pollen-robotics/grabette/integrations/openarm/openarm_gripette_simu/README.md

# OpenArm Gripette Simulation

MuJoCo simulation of the OpenArm right arm + Gripette gripper with gRPC control interfaces, policy evaluation support, and synthetic data collection in LeRobot format.

## Install

`placo` (used for kinematics) dynamically links the system `urdfdom` libraries,
which are **not** installed by `uv`. On Debian/Ubuntu, install them first:

```bash
sudo apt install -y liburdfdom-sensor4.0 liburdfdom-model4.0 liburdfdom-world4.0
# or the catch-all: sudo apt install -y liburdfdom-dev
```

Without them, `import placo` (and the sim) fails with
`ImportError: liburdfdom_sensor.so.4.0: cannot open shared object file`.

Then sync the Python environment:

> Part of the uv **workspace**: a bare `uv sync` here would build the *entire
> monorepo* environment. Always pass `--package` (root README → Development).
> The base simulator supports Python 3.11; the `dataset` and `eval` extras
> require Python 3.12 because they install LeRobot 0.6.x.

```bash
uv sync --package openarm-gripette-simu                  # base install
uv sync --package openarm-gripette-simu --extra dataset  # + lerobot (dataset collection)
uv sync --package openarm-gripette-simu --extra dev      # + grpcio-tools (proto stubs)
```

The robot model comes from the workspace package
[`openarm_gripette_model`](../openarm_gripette_model), resolved locally from the
monorepo via `[tool.uv.sources]` (`openarm-gripette-model = { workspace = true }`)
— no external fetch.

## Run the server

```bash
# With 3D viewer
uv run python -m openarm_gripette_simu --scene scenes/table_red_cube.xml \
    --initial-joints 0.0 0 0 1.57 0 0 0

# Headless
uv run python -m openarm_gripette_simu --scene scenes/table_red_cube.xml --headless
```

Two gRPC services on separate ports:

| Service | Port | Description |
|---|---|---|
| GripperService | 50051 | Camera stream + gripper motor control (same API as real Gripette) |
| ArmService | 50052 | Delta Cartesian arm control, episode reset, success detection |

## gRPC API

### GripperService (port 50051)

Identical to the real [Gripette](../../../packages/gripette) gRPC API.

| RPC | Description |
|-----|---|
| `StreamState` | 30Hz JPEG camera frames + motor positions + load + timestamp |
| `SendMotorCommand(m1, m2[, torque_limit])` | Set gripper joint goals (rad); optional grip force cap (0..1, 0 = unset) |
| `ReadMotors` | Read gripper joint positions (rad) + load |
| `SetTorque(enable)` | No-op in simulation |
| `Ping` | Health check |

### ArmService (port 50052)

| RPC | Description |
|-----|---|
| `SendCartesianDelta(dx, dy, dz, dr6d[6])` | Apply delta to end-effector pose (meters + 6D rotation). **Deltas are camera-LOCAL — see below.** |
| `GetArmState` | Current camera-frame pose (xyz + r6d) and joint positions |
| `Reset(joint_positions=[])` | Reset episode: randomize cube + arm (empty joints = random start) |
| `GetSuccessStatus` | Returns `goal_reached` (cube touched) + displacement |
| `Ping` | Health check |

The 6D rotation representation (Zhou et al., CVPR 2019) matches the action space used by diffusion policies trained with LeRobot.

#### `SendCartesianDelta` is camera-local (integrator semantics)

`(dx, dy, dz)` and `dr6d` are interpreted in the **integrator's current
camera-frame target**, not in the world frame. The server maintains an
internal `(_target_pos, _target_r6d)` initialized from FK on startup (and
re-synced after `Reset`), and each call updates it as:

```python
R_target = rotation_6d_to_matrix(self._target_r6d)
self._target_pos = self._target_pos + R_target @ (dx, dy, dz)   # local → world
self._target_r6d = rotation_matrix_to_6d(R_target @ rotation_6d_to_matrix(dr6d))
# IK solves to the new (target_pos, target_r6d) and commands the arm joints.
```

This matches `convert_dataset.py` in the [DiffusionPolicy](../../DiffusionPolicy)
integration, which builds the per-frame action as `R[t].T @ Δpos_world` and
`R[t].T @ R[t+1]` (the integrator-semantics box above has the full frame
rationale). To verify the integrator end-to-end against a running server, use
the gRPC-client `cartesian_square.py` in the
[`openarm_gripette`](../openarm_gripette) package — not the standalone one in
this repo's `examples/` (see "Examples" below).

### Evaluation loop pattern

```python
import grpc
from openarm_gripette_simu.proto import arm_pb2, arm_pb2_grpc

stub = arm_pb2_grpc.ArmServiceStub(grpc.insecure_channel("localhost:50052"))

for episode in range(n_episodes):
    stub.Reset(arm_pb2.ResetRequest())  # randomized start + cube
    for step in range(max_steps):
        state = stub.GetArmState(arm_pb2.GetArmStateRequest())
        # ... policy inference ...
        stub.SendCartesianDelta(arm_pb2.CartesianDelta(...))
        status = stub.GetSuccessStatus(arm_pb2.SuccessStatusRequest())
        if status.goal_reached:
            break
```

### Action representation at eval (`--chunk_relative`)

`evaluate.py` speaks two action representations. **Per-step deltas are the
default** and need no flag. A checkpoint trained with chunk-relative actions
(`GRABETTE_CHUNK_RELATIVE=1` in `integrations/Pi05/train.py`) emits 8-D
chunk offsets that must be differenced back into per-step deltas before the
arm server sees them:

```
--chunk_relative auto   # default: read the checkpoint's policy_preprocessor.json
                        # and enable iff a chunk-relative step is registered
--chunk_relative on     # force on (remote --policy_addr: the checkpoint is not
                        # local, so say it explicitly or auto refuses to guess)
--chunk_relative off    # force off
```

Chunk-relative needs `--n_action_steps 40` or more; the reference (the
chunk's first action) cancels in the differencing, so short horizons replay
the model's per-step noise as jitter (15 is visibly jerky). The width of the
action vector is cross-checked against the mode (8-D chunk-relative, 11-D
delta) and a mismatch aborts with a hint instead of silently misinterpreting.
Install with the `eval` extra (`grabette-chunkrel` is a workspace dependency)
— see `docs/relative_actions_lerobot_native.md` for the design and results.

Note: `--skip_stale` used to read a dead action queue on pi05 and dropped the
chunk head on every tick; it now drops exactly once per replan.

### View the camera stream

```bash
uv run python -c "
import cv2, grpc, numpy as np
from openarm_gripette_simu.proto import gripper_pb2, gripper_pb2_grpc
stub = gripper_pb2_grpc.GripperServiceStub(grpc.insecure_channel('localhost:50051'))
for frame in stub.StreamState(gripper_pb2.StreamRequest()):
    img = cv2.imdecode(np.frombuffer(frame.jpeg_data, np.uint8), cv2.IMREAD_COLOR)
    cv2.imshow('Gripette', img)
    if cv2.waitKey(1) & 0xFF == ord('q'): break
"
```

## Synthetic data collection

Generates diverse reach-and-touch episodes in LeRobot v3 format or as raw numpy arrays.

Trajectory types (mixed randomly per episode):
- **Direct reach** (40%): cube visible at start, go straight to it
- **Scan then reach** (35%): camera looking away, sweep to find cube, then reach
- **Offset reach** (25%): start displaced sideways, re-center then reach

Each episode randomizes:
- Cube XY position (±6cm in X, ±20cm in Y) and yaw (full rotation)
- Arm start joints (±0.08 rad per joint)
- Cube placement uses MuJoCo collision detection to guarantee no contact with the arm at spawn

```bash
# LeRobot format (requires: uv sync --extra dataset)
uv run python examples/collect_reach_dataset.py \
    --repo-id user/simu_reach --episodes 500

# Raw npy/jpg format (no lerobot dependency)
uv run python examples/collect_reach_dataset.py \
    --raw --root data/raw_reach --episodes 500

# Push to HuggingFace Hub
uv run python examples/collect_reach_dataset.py \
    --repo-id user/simu_reach --episodes 500 --push

# Visual debug
uv run python examples/collect_reach_dataset.py \
    --repo-id local/test --episodes 5 --viewer
```

Dataset features match the Grabette training pipeline:
- `observation.state`: `[11]` float32 — `[x, y, z, r6d_0..5, proximal_deg, distal_deg]`
- `observation.images.cam0`: video, 972×1296 fisheye
- `action`: `[11]` float32 — same 11D (absolute, next-step target)

Reach episodes record at **50fps** (20ms per frame), 972×1296 — the sim's native rate. (The real rig and the **grasp** dataset below use 30fps / 960×720 to match it; the reach set is a separate, older synthetic task.)

## Grasp data collection

`examples/collect_grasp_dataset.py` generates scripted grasp-and-lift demos of the
arm picking a cylinder ("can") off the table, in LeRobot format, for training a
visuomotor grasp policy. The gripper is driven free-floating (welded mocap) along
an approach → descend → close → hold → lift trajectory; only successful episodes
(cube lifted ≥ 5 cm) are saved.

```bash
uv run python examples/collect_grasp_dataset.py \
    --episodes 200 --repo_id user/sim_grabette_grasp --push_to_hub --private
```

Dataset format (matches the real Grabette recordings):
- `observation.images.cam0`: **h264** video, **960×720** fisheye (distorted at the
  calibration resolution then downscaled), **30 fps**.
- `action`: `[8]` float32 — `[x, y, z, ax, ay, az, proximal, distal]`: the absolute
  `oak_l` (SLAM/control) pose + gripper joint **position** at the next step.
  `DiffusionPolicy/convert_dataset.py` turns these into the camera-local deltas the
  policy trains on.

Grasp-pose sampling (tunables in `examples/grabette_trajectory.py`):
- `GRASP_TILT_RANGE_DEG = (65, 75)` — tilt off vertical (0 = top-down). Diagonal
  grasps; top-down is both hardest to reach and near the wrist-roll singularity.
- `GRASP_AZIMUTH_RANGE_DEG = (10, 30)` — grasp yaw. Positive is the right arm's
  natural side; negative wraps the elbow into the pedestal.
- `GRASP_OFFSET_BODY` z (0.090) — how deep the can sits in the V (smaller = deeper).

Episode-type mix (CLI fractions): `--release_fraction` (start closed→open),
`--recover_fraction` (deliberate near-miss → reposition → re-grasp); the remainder
are normal grasps.

Two prefilters keep only **arm-executable** demos (data-gen is free-floating, so it
must check the arm explicitly):
- `--ik_filter` (default on) — rejects per-frame poses the OpenArm can't reach.
- `--pedestal_filter` (default on) — rejects configs that collide with the mounting
  column (shared `pedestal.py` clearance query — the same one the eval gate uses).

`scenes/grabette_grasp.xml` (the free-floating grasp scene) is regenerated from the
model by `scenes/gen_grabette_grasp.py` after a model re-export.

**Verify a collected dataset** with `examples/replay_dataset.py` (needs a display):

```bash
# Free-floating gripper + the recorded cam0 frames (check the data itself)
uv run python examples/replay_dataset.py --repo_id user/sim_grabette_grasp

# Replay the recorded oak_l poses on the FULL ARM (IK + physics) and report grasp
# success — confirms the saved episodes are arm-executable
uv run python examples/replay_dataset.py --repo_id user/sim_grabette_grasp --arm
```

## Evaluate a trained policy

`examples/evaluate.py` loads a trained policy (Diffusion / ACT / Pi0…, the type
is auto-detected from its `config.json`) and drives the arm over gRPC for N
episodes, reporting grasp success. The policy must have been trained on the
camera-local delta format produced by the `DiffusionPolicy` integration's
`convert_dataset.py` (2D gripper state, 11D delta action).

```bash
uv sync --package openarm-gripette-simu --extra eval   # adds LeRobot Diffusion/Pi policy deps + scipy

# Terminal 1 — arm grasp scene, headless
uv run python -m openarm_gripette_simu --scene scenes/table_grasp.xml --headless

# Terminal 2 — run the policy
uv run python examples/evaluate.py \
    --checkpoint <user>/<model>-best \
    --num_episodes 30 --n_action_steps 8
```

- `--checkpoint` — local path or HF repo id.
- **`--grip_assist`** — the fix to reach for when the policy approaches well but
  the gripper "closes without really gripping": see
  [When the gripper closes but barely touches the object](#when-the-gripper-closes-but-barely-touches-the-object).
  Supersedes `--latch_close` / `--commit_close` / `--grip_gain`.
- `--n_action_steps 8` — committed grasp (lower = more reactive approach, but can hesitate on the trigger).
- `--debug` — preview the camera feed; `--log_gripper` — print the gripper command vs observed state (and `present_load`) each step.
- `--clamp_pos_mm` / `--clamp_rot_deg` — cap per-step Cartesian deltas (stability test).
- `--grip_torque_limit` — **grip force cap** as a fraction `0..1` of the servo's max torque, applied to both gripper DOFs. `0` (default) = full torque = the pre-existing behavior, so **existing policies are unaffected unless you opt in**. With a cap set, the DOF driven into the object stalls at the cap → a consistent, object-size-independent grip force, while the policy's position targets (grasp *shape*) are untouched — no shape classifier needed. Force is then the cap rather than position overshoot, which is what makes `--grip_assist` safe to let close until it feels the object. Real hardware only (no-op in sim, which has no torque cap). **Pair it with `--grip_assist`** (see below); the older `--grip_gain` route needed the cap for the same reason. Start around `0.25` (field-validated: "medium" grip, ample for grasping, and thermally safe to hold indefinitely — no overload-protection fade); watch the `motor{1,2}_load` telemetry via `--log_gripper`. Load clamps at `cap×1000`; `present_current` keeps rising past the cap if you need to sense firmer grasps.

**OpenCV: headless by default, GUI window opt-in.** The workspace installs **`opencv-python-headless`** — lerobot depends on it and the on-device services (grabette on the Pi) need it, and a single venv can hold only one `cv2`. In this default, `--debug` **saves annotated frames to `eval_debug_frames/`** (and warns once) instead of opening a window. To get a **live preview window** on a GUI workstation, install the full build over the headless one:

```bash
uv pip install --force-reinstall opencv-python
```

Workstation-only (don't do this for a Pi deployment), and re-run it after any `uv sync` — sync restores the headless build.

### When the gripper closes but barely touches the object

**Try this first when a policy approaches correctly but fails to actually grip.**
It is the primary remedy for the most common grasp failure on this hardware, and
it **supersedes `--latch_close` / `--commit_close` / `--grip_gain`** — set it
instead of those, not alongside them.

**The failure.** The policy replays the closing *angle* it was shown, which is
where the human demonstrator's fingers sat **while pressing the object**. Replayed
on a force-blind position servo, that angle can leave the fingers stopped just
short, touching nothing: "parked at angle θ in air" and "pressing the object at
angle θ" are indistinguishable to the policy, and the dataset gave it no force
channel to tell them apart. Measured on the real arm: the policy commanded
proximal `0.865` while the object blocks the fingers at `0.871` — short by
~0.006 rad, i.e. it would just touch the mustard with essentially zero force.

**What the assist does.** It leaves the policy in charge of *when* to close and
*which posture* to use, and intervenes only in the one state where the policy
demonstrably fails — it has **settled** into a closed pose that is **not
gripping**. Then it extends the closure **along the policy's own prox/distal
direction** until the fingers stall on the object, presses a little further to
develop grip force, and latches. Everywhere else the gripper command passes
through untouched, so neither the approach nor an already-good grasp is
perturbed.

Preserving the posture matters here: with a 2-DoF index finger against a fixed
thumb, the prox/distal *ratio* **is** the grasp type (fingertip pinch ↔ power
wrap). A fixed "closed" target would override the policy's choice and could
drive the index into the thumb; extending along its direction cannot.

```bash
uv run python examples/evaluate.py \
    --checkpoint <user>/<model> \
    --grip_assist 50 --assist_lag 0.010 --assist_step 0.02 --assist_squeeze 0.05 \
    --grip_torque_limit 0.25 \
    --start_gripper 0.40 0.30 --log_gripper --assist_log /tmp/assist.jsonl
```

**Contact is detected as a stall** — all three terms are required, and each one
is there because omitting it failed on the robot:

| term | flag | why it is needed |
|---|---|---|
| the fingers have stopped advancing | `--assist_settle_eps` (0.004) | fingers still *travelling* to a fresh command lag ~0.09 rad and draw cap current; without this the assist latched 3 ticks in having added nothing |
| settled **short** of the commanded pose | `--assist_lag` (0.010 rad) | a finger that simply arrived has ~no lag; a blocked one keeps a growing one |
| while drawing load | `--grip_assist LOAD_THRESH` | a limp/disabled servo is also "not moving", but pushes nothing, and must not read as a grasp |

Readings are debounced (`--assist_confirm_ticks`, default 2) because the load
register is noisy. **Slip is load-only** (load fell): a gripped finger keeps
creeping while the policy raises its own command, and treating that motion as
slip ratcheted the extra closure 0.18 → 0.24 → 0.30 on the arm.

**Tuning.** The defaults come from measurements on the real gripper at a 0.25
torque cap: free motion lags 0.002–0.004 rad with load 0–24, while from first
contact lag is 0.014 and growing as load climbs 72 → 250 (the cap). Re-measure
for a different gripper or cap with
[`examples/characterize_grip_load.py`](examples/characterize_grip_load.py),
which sweeps the closure in assist-sized steps and prints the load-vs-closure
curve per object. **Thresholds do not transfer between hardware and sim** (the
sim's load is MuJoCo `actuator_force`, not the servo's 0–1000 PWM proxy). If a
soft object's signal barely clears the noise floor, raise `--assist_step` (a
deeper press gives a stronger signal) rather than lowering the threshold into
the noise.

**Debugging.** Every tick reports *why* the assist acted or didn't — `open`,
`cmd still moving 3/5`, `dwell`, `stepping to 0.040`, `contact confirmed`,
`squeezing to`, `latched at`, `holding`, `slip`, `no contact within max_extra`,
`disarmed` — via `--log_gripper`, and `--assist_log FILE` writes a per-tick
JSONL (model vs sent command, observed position, load, state, offset, lag,
advance, reason) for offline analysis. A silent no-show is therefore always
explainable: if it never engages, the reason field names the gate that blocked
it (usually `cmd still moving`, fixed with `--assist_stable_ticks 3`).

The per-episode summary reports the latched **extra closure**, which is a useful
measurement in its own right: *how much the policy was under-closing by*.

**Field result (mustard, real arm).** Raw grasping (no assist, no latch/gain)
reproduces the failure clearly. `--latch_close 0.50 --grip_gain 1.3`, tuned over
several sessions and specific to that model/object, works. `--grip_assist` with
the bench-measured defaults works at least as well, with nothing to re-tune when
the object or checkpoint changes.

> **Note:** the eval reopens the gripper to `--start_gripper` when it exits
> (including Ctrl-C). A run that ends while gripped would otherwise leave the
> servo squeezing at the torque cap indefinitely — and the *next* episode would
> then start with the policy observing a **closed** gripper, which is out of
> distribution (every demo starts open) and makes it predict lift/hold instead
> of approach/close. After a `kill -9`, reopen the gripper manually.

### Remote inference (big VLA checkpoints)

Models too large for the robot machine (Pi0.5/Pi0Fast, ~10 GB in fp32) can run
on a remote GPU through a [Ficelle](https://github.com/SteveNguyen/Ficelle)
policy server — all pre/post-processing happens server-side through the
checkpoint's own pipeline, this loop only ships raw observations and receives
action chunks. Works for single-frame policies (Pi0/Pi0.5) and the two-frame
Diffusion models (the server's `n_obs_steps` picks the wire format
automatically); sync mode only.

```bash
# On the GPU machine (needs the ficelle repo). --transport iroh works through
# NAT with no VPN/port-forwarding (QUIC hole-punching) and prints a ticket:
uv run python serve.py --checkpoint <user>/<model> --dtype float32 --transport iroh
# (--dtype float32: the lerobot pi05 port has a bf16 dtype clash in its flow path)
#   -> iroh ticket: endpointv1...

# On the robot machine — same eval loop, no local checkpoint; --policy_addr
# takes the ticket (or a 'host:port' if the server is reachable directly):
uv run python examples/evaluate.py \
    --policy_addr endpointv1... --n_action_steps 15 \
    --task "pick up the red can" --num_episodes 10
```

- The ficelle client must be installed in this environment
  (`uv pip install -e '<ficelle>/client[iroh]'` — websockets + msgpack +
  numpy, plus the iroh bindings for the ticket transport).
- `--n_action_steps` matters: Pi0.5's native chunk is 50 actions = 5 s
  open-loop at 10 fps; 10–25 re-plans often enough to stay closed-loop.
- `--jpeg_quality 90` compresses frames for transport (use over WiFi/VPN;
  raw is fine on a LAN).

### Eval safety gates (`arm_servicer`)

`SendCartesianDelta` validates each IK solution before applying it (holding the
last-good command + rolling back the integrator target if it fails):
- **Pedestal gate** — rejects a config that moves a guarded link within 2 cm of the
  mounting column. Moves that *increase* clearance are always allowed, so the arm
  can never deadlock inside the margin.
- **Singularity guard** — rejects an IK solution that jumps more than
  `JOINT_JUMP_LIMIT` (0.5 rad) from the last command — the signature of a
  near-singular "explosion" (it also stops the arm flailing into the column).

Both use the shared `pedestal.py` clearance query against the `pedestal_box` proxy
geom in `scenes/table_grasp.xml` (the same query the data-gen `--pedestal_filter`
uses, so demos and eval enforce the identical constraint). Per-episode the servicer
logs `[grasp-diag]` (commanded-vs-actual grasp gap) and `[grasp-orient]` (grasp
tilt/azimuth) at `GetSuccessStatus`, for diagnosing systematic misses.

## Scenes

Scene XML files live in `scenes/`. They include the robot model and add environment elements.

| Scene | Description |
|---|---|
| `scenes/table_red_cube.xml` | Wooden table with a movable red cube (reach task) |
| `scenes/table_grasp.xml` | Arm + table + grasp cylinder + `pedestal_box` proxy (grasp eval / replay) |
| `scenes/grabette_grasp.xml` | Free-floating gripper + cylinder (grasp data generation); regenerated by `scenes/gen_grabette_grasp.py` |

To create a new scene, copy an existing one as a template. The robot is included via `<include file="...robot.xml"/>`. The `Simulation` class injects the correct `meshdir` so scenes can live anywhere.

## Examples

Standalone demos (no gRPC — each script spawns its own MuJoCo simulation):

```bash
uv run python examples/cartesian_square.py   # Standalone Cartesian square (NOT a gRPC client)
uv run python examples/joint_control.py      # Move joints one by one
uv run python examples/gripper_demo.py       # Gripper open/close cycle
uv run python examples/table_scene.py        # Table scene with red cube
uv run python examples/grpc_client_demo.py   # gRPC client (requires server running)
```

> **Two `cartesian_square.py` files exist.** The one in *this* repo
> (`openarm_gripette_simu/examples/cartesian_square.py`) is **standalone**:
> it imports `Simulation`/`Kinematics` directly and runs its own MuJoCo
> instance with world-frame waypoints. It is **not** a gRPC client — running
> `python -m openarm_gripette_simu --scene ...` in another terminal has no
> effect on it. The canonical end-to-end smoke test of the camera-local
> delta convention is the gRPC-client `cartesian_square.py` in the
> [`openarm_gripette`](../openarm_gripette) package (takes `--arm_addr`) — it
> drives a running server and tests the integrator semantics described above.

## Camera

The simulated Gripette camera matches the real camera calibration:
- Render/calibration resolution: 1296×972 (distorted at this res, then downscaled to the **960×720** streamed to the policy)
- Lens model: KannalaBrandt8 fisheye
- MuJoCo renders a wide-FOV (130°) pinhole image, then remaps with real distortion coefficients

Camera rendering is done in the main thread (alongside physics and viewer) and cached; gRPC streams read the cached frame to avoid GL context conflicts.

## Timing

| Component | Rate |
|---|---|
| Physics | 500Hz (dt=0.002s) default; 1000Hz (dt=0.001s) in the grasp scenes |
| Camera render | 30Hz (matches the real Grabette stream) |
| Gripper gRPC stream | 30Hz |
| Dataset FPS | 30 (grasp, matches real) · 50 (reach) |
| Viewer sync | 60Hz |

## Regenerating proto stubs

```bash
uv sync --package openarm-gripette-simu --extra dev
uv run python -m grpc_tools.protoc -I proto \
    --python_out=openarm_gripette_simu/proto \
    --grpc_python_out=openarm_gripette_simu/proto \
    --pyi_out=openarm_gripette_simu/proto \
    proto/gripper.proto proto/arm.proto
```

Then fix the imports in generated `*_pb2_grpc.py` files: change `import xxx_pb2` to `from . import xxx_pb2`.
