pollen-robotics/grabette/docs/images/turn_on.gif

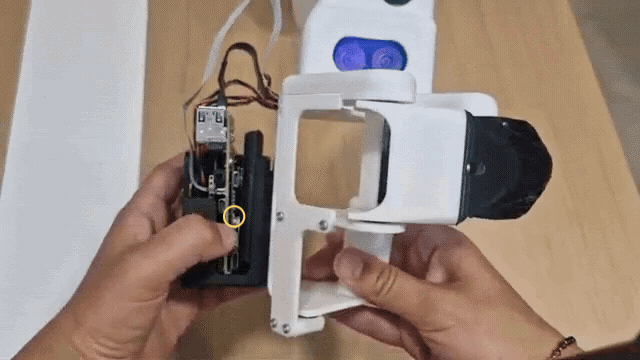
docs/images/turn_on.gif
