pollen-robotics/grabette/packages/grabette/docs/images/grabette_face.jpg

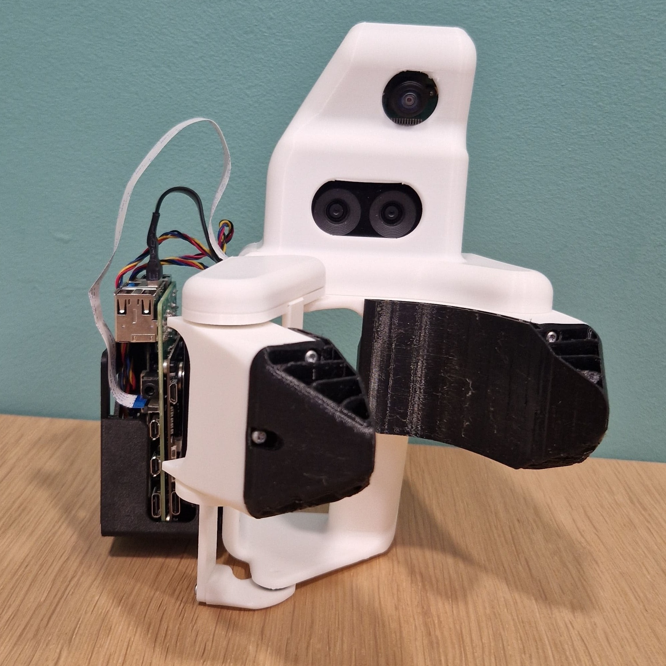
packages/grabette/docs/images/grabette_face.jpg
