pollen-robotics/grabette/packages/grabette/assembly/CAD_files/Left/STEP/Pivot_Bot_L.step

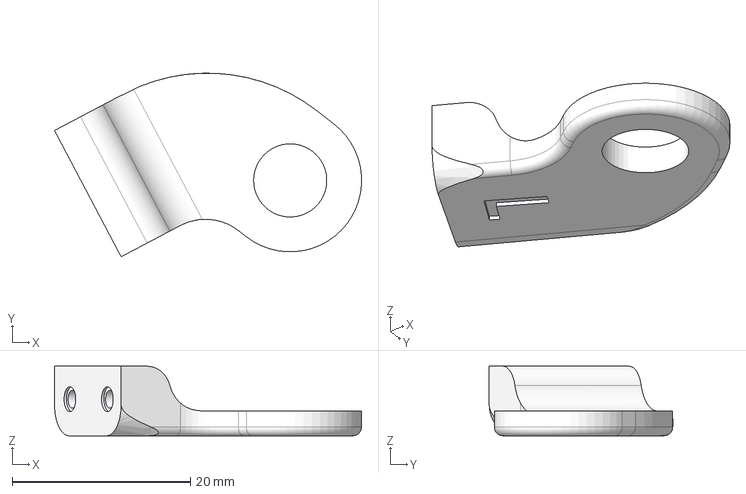
[picture p7: CAD file, 2026-07-06]
packages/grabette/assembly/CAD_files/Left/STEP/Pivot_Bot_L.step
34.4 x 20.6 x 7.80 mm
