pollen-robotics/grabette/packages/grabette/assembly/CAD_files/Right/STEP/Proximal_Shell_R.step

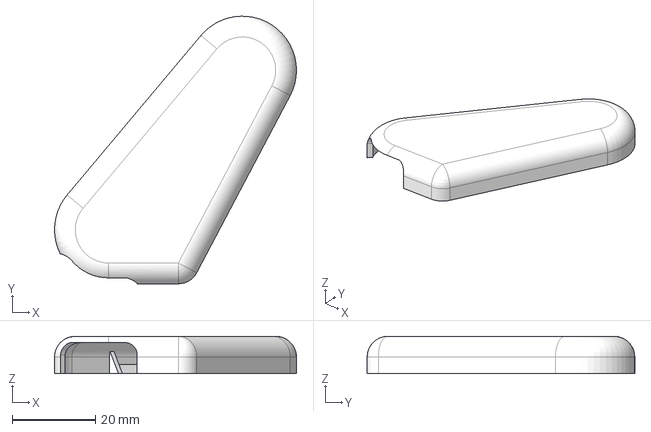
[picture p8: CAD file, 2026-07-06]
packages/grabette/assembly/CAD_files/Right/STEP/Proximal_Shell_R.step
58.1 x 64.3 x 9.00 mm
