pollen-robotics/grabette/packages/gripette/assembly/CAD_files/Left/STEP/Cameras_Holder_L.step

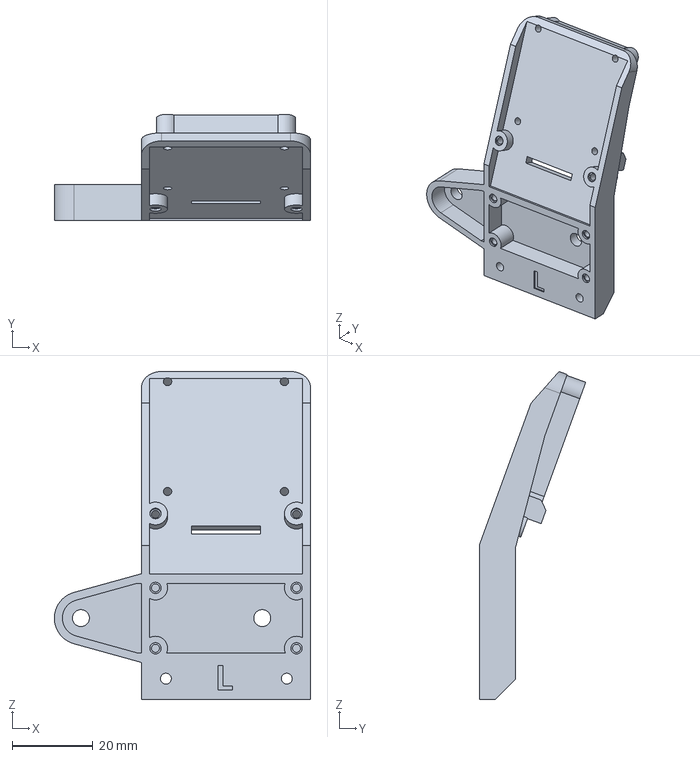
[picture p9: CAD file, 2026-07-06]
packages/gripette/assembly/CAD_files/Left/STEP/Cameras_Holder_L.step
63.6 x 26.4 x 81.4 mm
