pollen-robotics/grabette/packages/gripette/assembly/CAD_files/Right/STEP/Grip_soft_tip_R.step

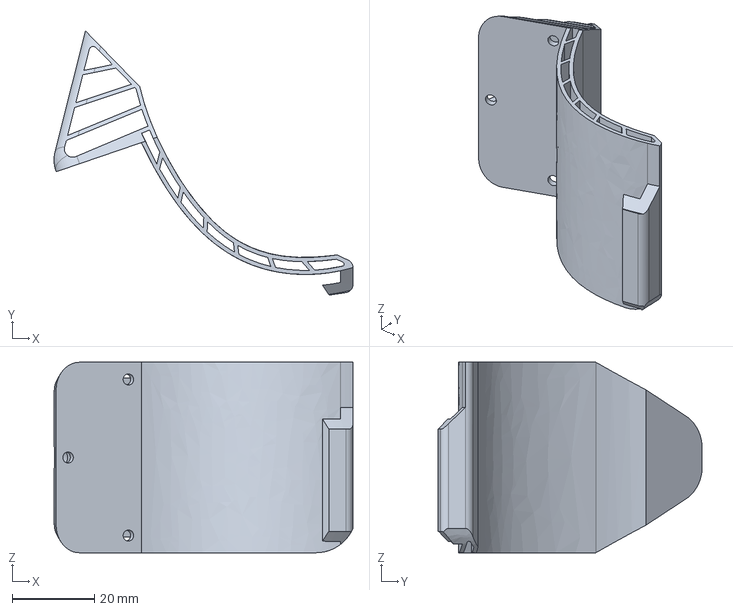
[picture p10: CAD file, 2026-07-06]
packages/gripette/assembly/CAD_files/Right/STEP/Grip_soft_tip_R.step
72.8 x 64.4 x 46.4 mm
