pollen-robotics/grabette/packages/grabette/assembly/CAD_files/Right/STEP/Grip_R.step

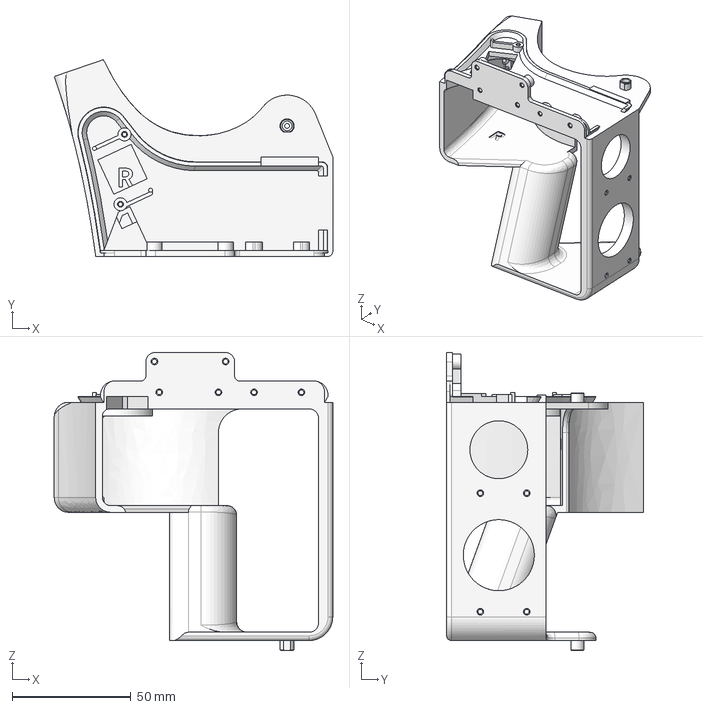
[picture p11: CAD file, 2026-07-06]
packages/grabette/assembly/CAD_files/Right/STEP/Grip_R.step
117.5 x 82.9 x 125.7 mm
