pollen-robotics/grabette/packages/gripette/assembly/CAD_files/Left/STEP/Proximal_Bot_L.step

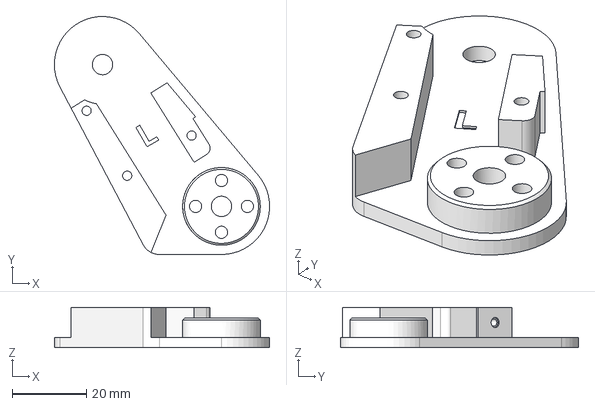
[picture p12: CAD file, 2026-07-06]
packages/gripette/assembly/CAD_files/Left/STEP/Proximal_Bot_L.step
58.1 x 64.3 x 10.9 mm
