pollen-robotics/grabette/packages/gripette/assembly/CAD_files/Right/STEP/Grip_Shell_R.step

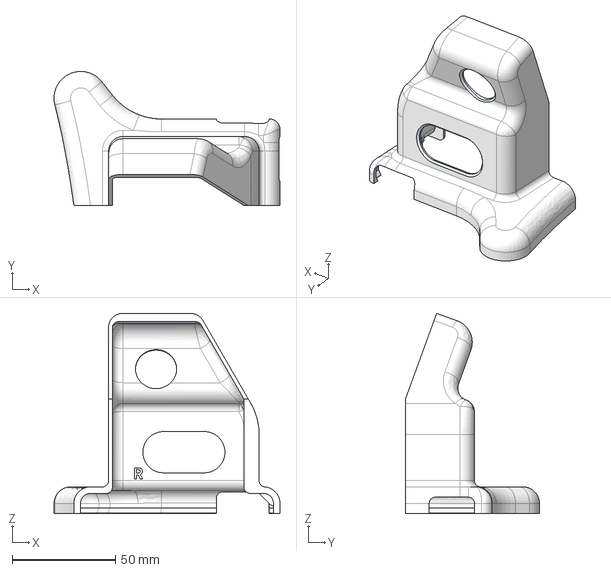
[picture p13: CAD file, 2026-07-06]
packages/gripette/assembly/CAD_files/Right/STEP/Grip_Shell_R.step
109.6 x 65.1 x 97.2 mm
