pollen-robotics/grabette/packages/grabette/assembly/CAD_files/Left/STEP/Button.step

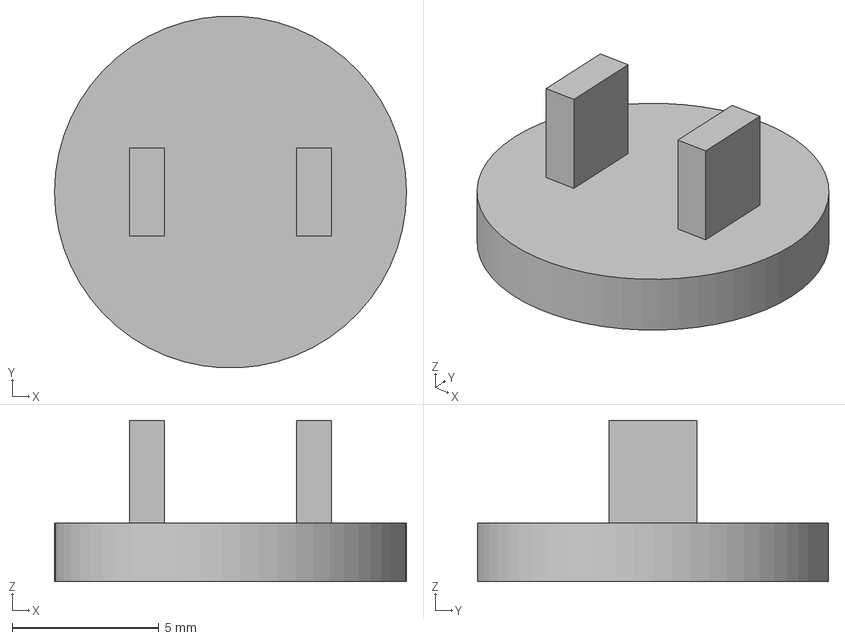
[picture p14: CAD file, 2026-07-06]
packages/grabette/assembly/CAD_files/Left/STEP/Button.step
12.0 x 12.0 x 5.50 mm
