pollen-robotics/grabette/packages/gripette/assembly/CAD_files/Left/STEP/Gripper_Base_L.step

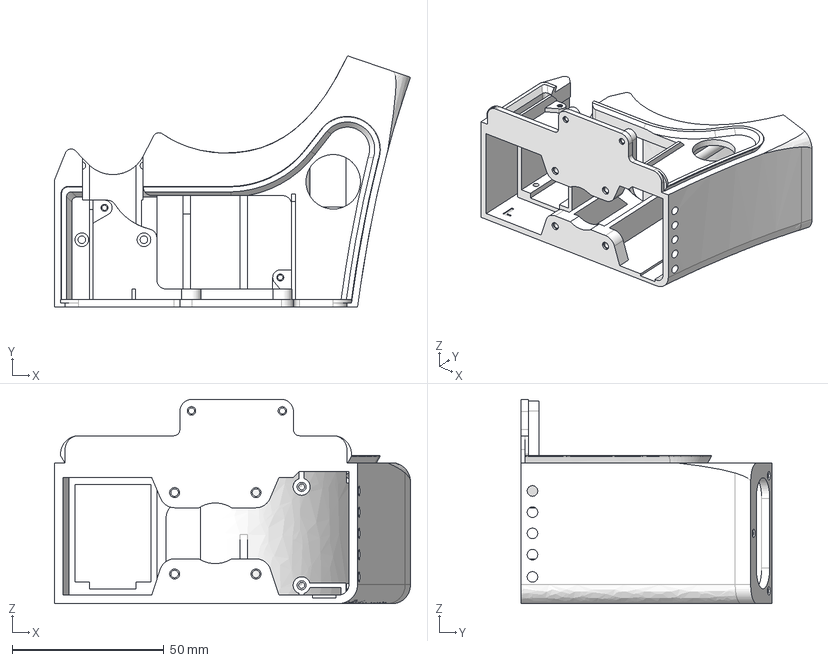
[picture p15: CAD file, 2026-07-06]
packages/gripette/assembly/CAD_files/Left/STEP/Gripper_Base_L.step
117.5 x 82.9 x 67.4 mm
