pollen-robotics/grabette/packages/grabette/assembly/CAD_files/Left/STEP/Raspi_Box_L_Flat.step

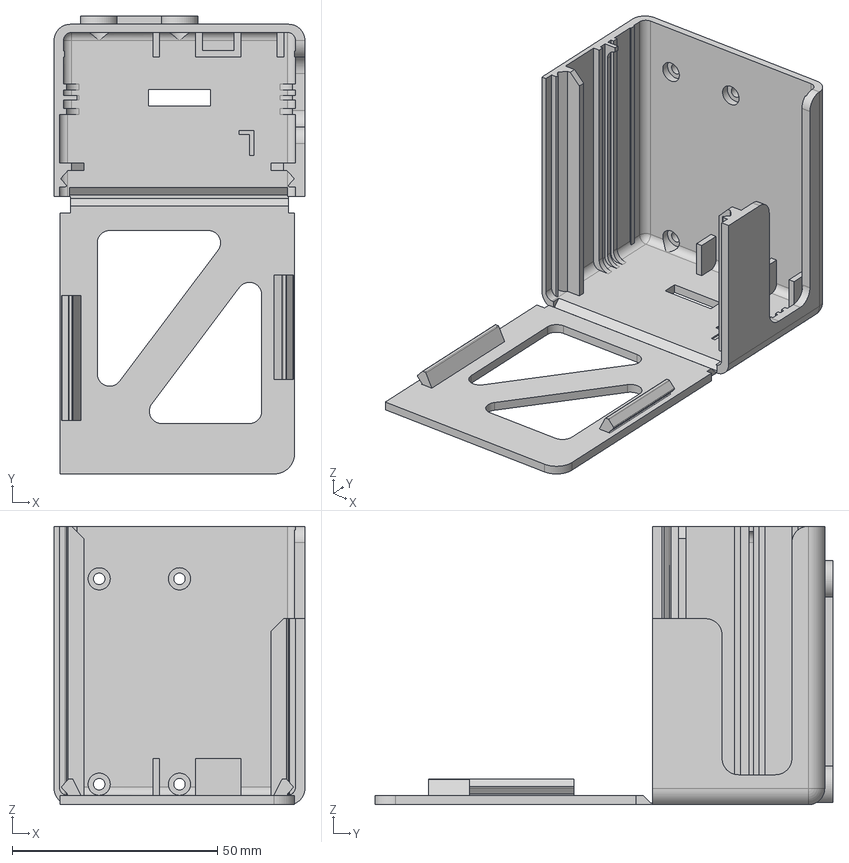
[picture p16: CAD file, 2026-07-06]
packages/grabette/assembly/CAD_files/Left/STEP/Raspi_Box_L_Flat.step
61.1 x 111.5 x 67.8 mm
