pollen-robotics/grabette/packages/grabette/assembly/CAD_files/Right/STEP/Distal_Soft_tip.step

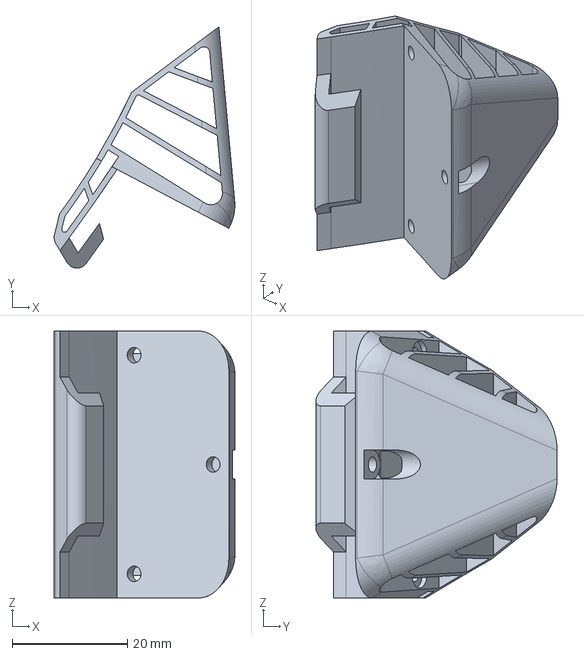
[picture p17: CAD file, 2026-07-06]
packages/grabette/assembly/CAD_files/Right/STEP/Distal_Soft_tip.step
31.4 x 41.9 x 46.4 mm
