pollen-robotics/grabette/packages/grabette/assembly/CAD_files/Left/STEP/Spacer H8.5.step

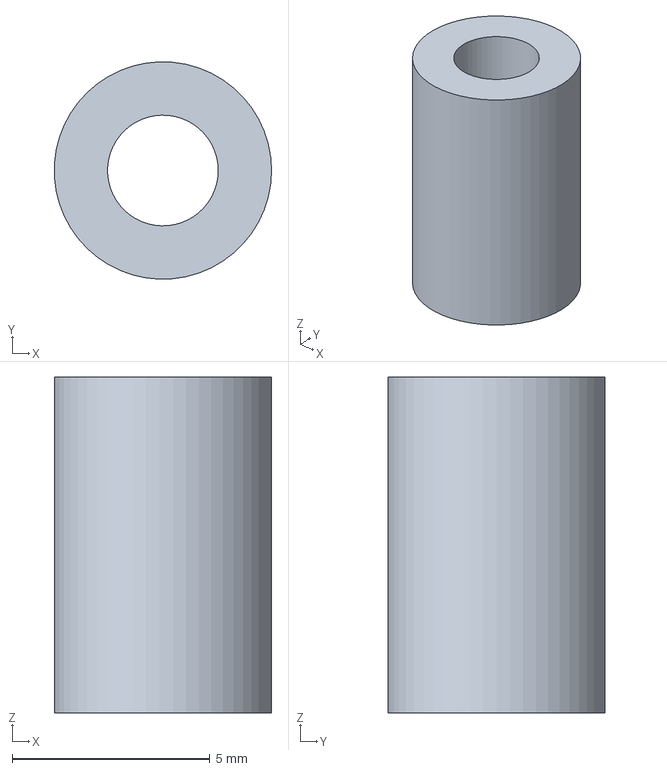
[picture p18: CAD file, 2026-07-06]
packages/grabette/assembly/CAD_files/Left/STEP/Spacer H8.5.step
5.49 x 5.50 x 8.50 mm
