pollen-robotics/grabette/packages/gripette/assembly/CAD_files/Left/STEP/Distal_Part_L.step

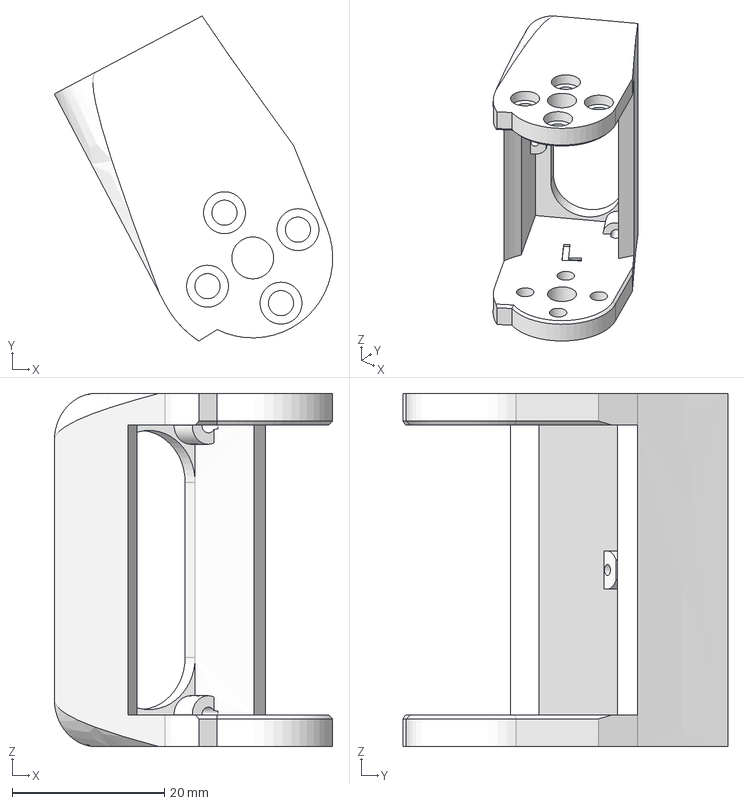
[picture p19: CAD file, 2026-07-06]
packages/gripette/assembly/CAD_files/Left/STEP/Distal_Part_L.step
36.5 x 42.7 x 46.4 mm
