pollen-robotics/grabette/packages/gripette/assembly/CAD_files/Right/STEP/Proximal_Top_R.step

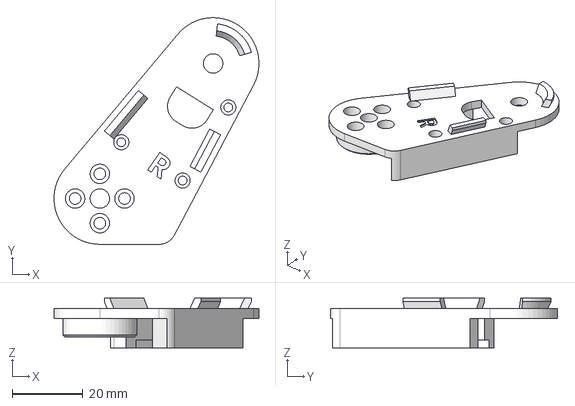
[picture p20: CAD file, 2026-07-06]
packages/gripette/assembly/CAD_files/Right/STEP/Proximal_Top_R.step
58.1 x 64.3 x 14.1 mm
