pollen-robotics/grabette/packages/grabette/assembly/CAD_files/Left/STEP/Grip_L.step

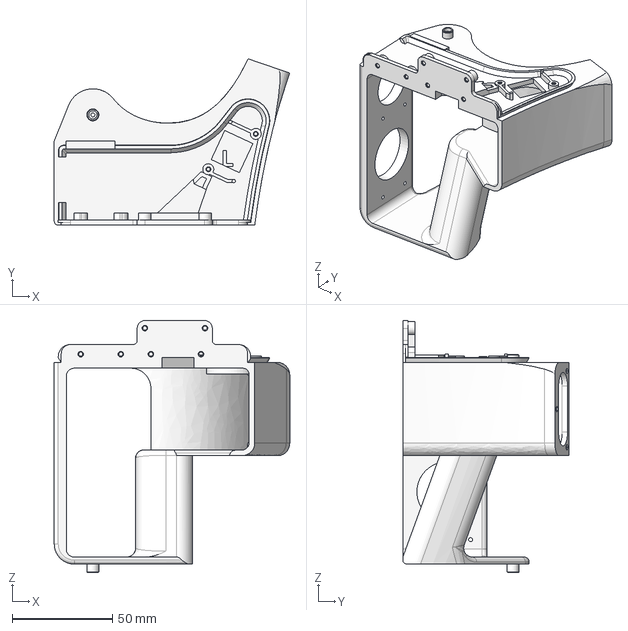
[picture p21: CAD file, 2026-07-06]
packages/grabette/assembly/CAD_files/Left/STEP/Grip_L.step
117.5 x 82.9 x 125.7 mm
