pollen-robotics/grabette/packages/grabette/assembly/CAD_files/Right/STEP/Distal_R.step

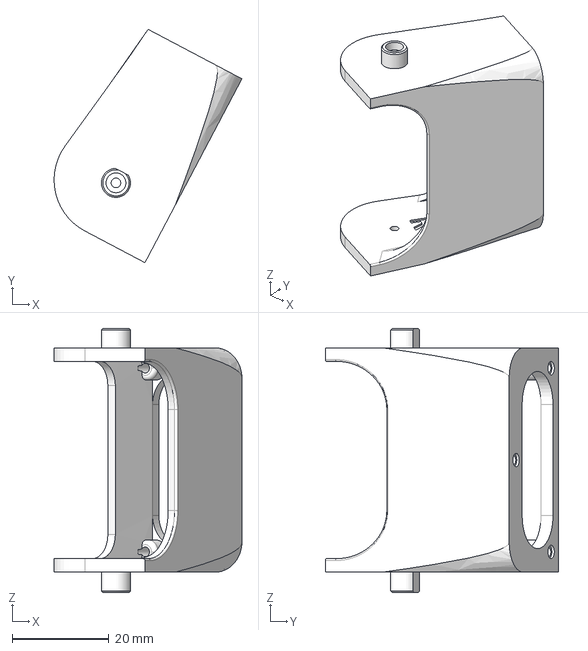
[picture p22: CAD file, 2026-07-06]
packages/grabette/assembly/CAD_files/Right/STEP/Distal_R.step
38.9 x 48.3 x 54.6 mm
