pollen-robotics/grabette/packages/gripette/assembly/CAD_files/Left/STEP/Cross_Bar.step

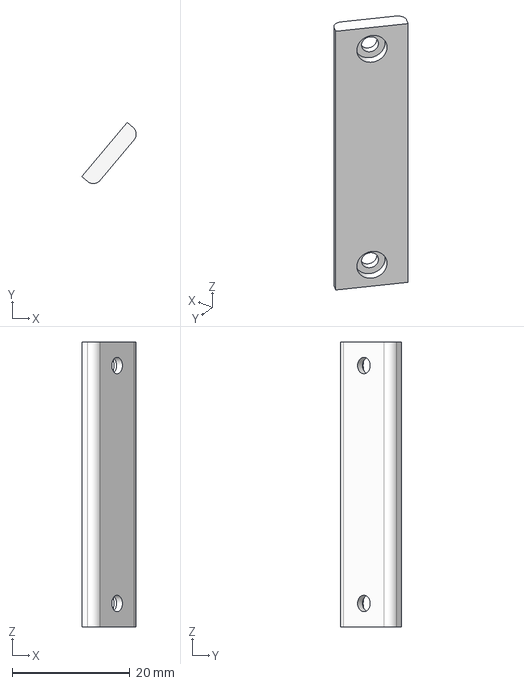
[picture p23: CAD file, 2026-07-06]
packages/gripette/assembly/CAD_files/Left/STEP/Cross_Bar.step
9.24 x 10.4 x 48.4 mm
