pollen-robotics/grabette/packages/grabette/assembly/CAD_files/Left/STEP/Proximal_Flat_L.step

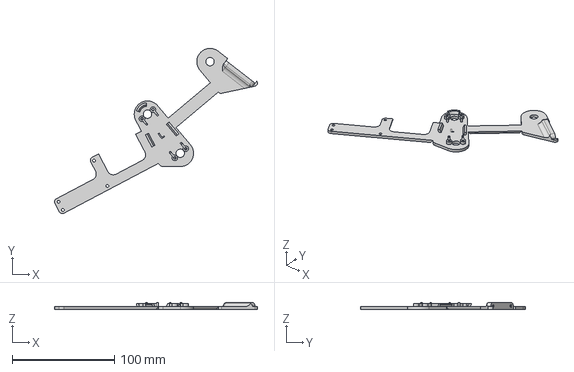
[picture p24: CAD file, 2026-07-06]
packages/grabette/assembly/CAD_files/Left/STEP/Proximal_Flat_L.step
198.8 x 161.7 x 6.80 mm
