pollen-robotics/grabette/(list of files, cad)

Other CAD files:
integrations/openarm/openarm_gripette_model/openarm_gripette_model/openarm_right/assets/part_1__configuration_copy_of_2x8.stl
packages/grabette/urdf/grabette_left/assets/radial_magnet__configuration__4x2mm.stl
packages/grabette/urdf/grabette_left_viewer/assets/lens_adhesive.stl
packages/grabette/urdf/grabette_right_viewer/assets/distal_r.stl
packages/gripette/urdf/gripette_left/assets/proximal_top_l.stl
packages/gripette/urdf/gripette_right/assets/arducam_fisheye.stl
packages/gripette/urdf/openarm_gripette_right/assets/612_00001_tim_thermal_oak_d_poe.stl
integrations/openarm/openarm_gripette_model/openarm_gripette_model/openarm_right/assets/cameras_holder_r.stl
packages/grabette/assembly/CAD_files/Left/STEP/Proximal_Shell_L.step
packages/grabette/urdf/grabette_left_viewer/assets/distal_soft_tip.stl
packages/grabette/urdf/grabette_right_viewer/assets/grip_shell_r.stl
packages/gripette/urdf/gripette_left/assets/sr_lens_py058.stl
packages/gripette/urdf/gripette_right/assets/proximal_shell_r.stl
packages/gripette/urdf/openarm_gripette_right/assets/proximal_bot_r.stl
integrations/openarm/openarm_gripette_model/openarm_gripette_model/openarm_right/assets/distal_r.stl
packages/grabette/urdf/grabette_left_viewer/assets/proximal_shell_l.stl
packages/grabette/urdf/grabette_right_viewer/assets/proximal_shell_r.stl
packages/gripette/assembly/CAD_files/Right/STEP/Proximal_Bot_R.step
packages/gripette/urdf/gripette_left/assets/grip_soft_tip_l.stl
packages/gripette/urdf/gripette_right/assets/proximal_bot_r.stl
integrations/openarm/openarm_gripette_model/openarm_gripette_model/openarm_right/assets/cross_bar.stl
packages/grabette/assembly/CAD_files/Left/STEP/Grip_soft_tip_L.step
packages/grabette/assembly/CAD_files/Right/STEP/Grip_soft_tip_R.step
packages/grabette/urdf/grabette_left_viewer/assets/distal_l.stl
packages/gripette/assembly/CAD_files/Left/STEP/Grip_Shell_L.step
packages/gripette/assembly/CAD_files/Right/STEP/Cameras_Holder_R.step
packages/gripette/urdf/gripette_right/assets/606_00021_sr_back_cover_py074.stl
integrations/openarm/openarm_gripette_model/openarm_gripette_model/openarm_right/assets/proximal_top_r.stl
packages/grabette/urdf/grabette_right_viewer/assets/spacer_h8_5.stl
packages/gripette/assembly/CAD_files/Left/STEP/Proximal_Shell_L.step
packages/gripette/assembly/CAD_files/Right/STEP/Distal_Soft_tip.step
packages/gripette/urdf/gripette_left/assets/grip_shell_l.stl
packages/gripette/urdf/gripette_right/assets/sr_lens_py058.stl
packages/gripette/urdf/openarm_gripette_right/assets/grip_shell_r.stl
integrations/openarm/openarm_gripette_model/openarm_gripette_model/openarm_right/assets/611_00020.stl
packages/grabette/assembly/CAD_files/Right/STEP/Raspi_Box_R_Flat.step
packages/grabette/urdf/grabette_left_viewer/assets/612_00001_tim_thermal_oak_d_poe.stl
packages/grabette/urdf/grabette_right_viewer/assets/distal_soft_tip.stl
packages/gripette/urdf/gripette_right/assets/grip_soft_tip_r.stl
integrations/openarm/openarm_gripette_model/openarm_gripette_model/openarm_right/assets/grip_soft_tip_r.stl
packages/grabette/urdf/grabette_left_viewer/assets/spacer_h8_5.stl
packages/grabette/urdf/grabette_right_viewer/assets/bushing_6x8x4.stl
packages/gripette/assembly/CAD_files/Left/STEP/Proximal_Top_L.step
packages/gripette/urdf/openarm_gripette_right/assets/611_00020.stl
packages/grabette/assembly/CAD_files/Right/STEP/Pivot_Bot_R.step
packages/grabette/urdf/grabette_left_viewer/assets/proximal_bend_l.stl
packages/grabette/urdf/grabette_right_viewer/assets/button.stl
packages/gripette/assembly/CAD_files/Right/STEP/Cross_Bar.step
packages/gripette/urdf/gripette_left/assets/distal_soft_tip.stl
packages/grabette/assembly/CAD_files/Left/STEP/Grip_Shell_L.step
packages/grabette/assembly/CAD_files/Right/STEP/Cameras_Holder_R.step
packages/grabette/urdf/grabette_left_viewer/assets/cameras_holder_l.stl
packages/grabette/urdf/grabette_right_viewer/assets/pivot_bot_r.stl
packages/gripette/assembly/CAD_files/Left/STEP/Distal_Soft_tip.step
packages/gripette/assembly/CAD_files/Right/STEP/Distal_Part_R.step
packages/gripette/urdf/gripette_left/assets/distal_l.stl
packages/gripette/urdf/gripette_right/assets/rasp_pi_0_2w__configuration_default.stl
integrations/openarm/openarm_gripette_model/openarm_gripette_model/openarm_right/assets/sr_lens_py058.stl
packages/grabette/urdf/grabette_left_viewer/assets/raspberry_pi_4_model_b.stl
packages/grabette/urdf/grabette_right_viewer/assets/606_00021_sr_back_cover_py074.stl
packages/gripette/assembly/CAD_files/Left/STEP/Grip_soft_tip_L.step
packages/gripette/assembly/CAD_files/Right/STEP/Gripper_Base_R.step
packages/gripette/urdf/gripette_right/assets/cameras_holder_r.stl
integrations/openarm/openarm_gripette_model/openarm_gripette_model/openarm_right/assets/distal_soft_tip.stl
packages/grabette/assembly/CAD_files/Left/STEP/Cameras_Holder_L.step
packages/grabette/urdf/grabette_left_viewer/assets/611_00020_1.stl
packages/grabette/urdf/grabette_right/assets/radial_magnet__configuration__4x2mm.stl
packages/grabette/urdf/grabette_right_viewer/assets/sr_lens_py058.stl
packages/gripette/urdf/gripette_left/assets/606_00020_sr_front_cover.stl
packages/gripette/urdf/gripette_right/assets/gripper_base_r.stl
packages/gripette/urdf/openarm_gripette_right/assets/lens_adhesive.stl
packages/grabette/assembly/CAD_files/Left/STEP/Distal_L.step
packages/grabette/assembly/CAD_files/Right/STEP/Proximal_Flat_R.step
packages/grabette/urdf/grabette_right_viewer/assets/611_00020.stl
packages/gripette/urdf/gripette_left/assets/lens_adhesive.stl
packages/gripette/urdf/gripette_right/assets/611_00020.stl
packages/gripette/urdf/openarm_gripette_right/assets/proximal_top_r.stl
integrations/openarm/openarm_gripette_model/openarm_gripette_model/openarm_right/assets/606_00020_sr_front_cover.stl
packages/grabette/urdf/grabette_left_viewer/assets/grip_l.stl
packages/grabette/urdf/grabette_right_viewer/assets/pisugar3plus.stl
packages/gripette/urdf/gripette_left/assets/611_00020.stl
packages/grabette/urdf/grabette_left_viewer/assets/pivot_bot_l.stl
packages/gripette/urdf/gripette_left/assets/606_00021_sr_back_cover_py074.stl
packages/gripette/urdf/openarm_gripette_right/assets/cross_bar.stl
integrations/openarm/openarm_gripette_model/openarm_gripette_model/openarm_right/assets/gripper_base_r.stl
packages/grabette/urdf/grabette_left_viewer/assets/bushing_6x8x4.stl
packages/grabette/urdf/grabette_right_viewer/assets/arducam_fisheye.stl
packages/gripette/urdf/gripette_right/assets/distal_r.stl
integrations/openarm/openarm_gripette_model/openarm_gripette_model/openarm_right/assets/proximal_shell_r.stl
packages/gripette/urdf/gripette_left/assets/611_00020_1.stl
packages/gripette/urdf/gripette_right/assets/bulkhead.stl
packages/gripette/urdf/openarm_gripette_right/assets/hub_dyn.stl
integrations/openarm/openarm_gripette_model/openarm_gripette_model/openarm_right/assets/611_00020_1.stl
packages/grabette/urdf/grabette_left_viewer/assets/606_00020_sr_front_cover.stl
packages/grabette/urdf/grabette_right_viewer/assets/part_1__configuration_copy_of_2x5.stl
packages/gripette/urdf/gripette_left/assets/proximal_bot_l.stl
packages/gripette/urdf/openarm_gripette_right/assets/feetech_sts3215__configuration_default.stl
integrations/openarm/openarm_gripette_model/openarm_gripette_model/openarm_right/assets/grip_shell_r.stl
packages/grabette/urdf/grabette_left_viewer/assets/pisugar3plus.stl
packages/gripette/urdf/openarm_gripette_right/assets/grip_soft_tip_r.stl
integrations/openarm/openarm_gripette_model/openarm_gripette_model/openarm_right/assets/lens_adhesive.stl
packages/grabette/urdf/grabette_left_viewer/assets/button.stl
packages/grabette/urdf/grabette_right_viewer/assets/raspi_box_r.stl
packages/gripette/urdf/gripette_left/assets/proximal_shell_l.stl
packages/gripette/urdf/gripette_right/assets/grip_shell_r.stl
packages/gripette/urdf/openarm_gripette_right/assets/distal_soft_tip.stl
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
