pollen-robotics/grabette/packages/gripette/docs/bluetooth_setup.md

# Gripette Bluetooth WiFi Setup Guide

The gripette (Pi Zero 2W) is enclosed in the gripper with no physical access. A Bluetooth Low Energy (BLE) service lets you configure WiFi credentials from a phone or laptop — no SSH or screen needed.

## Prerequisites

- Raspberry Pi Zero 2W running Debian Bookworm (or later)
- BlueZ Bluetooth stack (pre-installed on Raspberry Pi OS)
- NetworkManager (`nmcli`) for WiFi management
- Chrome or Edge browser on the client device (Web Bluetooth is not supported in Firefox or Safari)

## Pi Setup

### 1. Install system dependencies

These are usually pre-installed on Raspberry Pi OS:

```bash
sudo apt install python3-dbus python3-gi bluez
```

### 2. Configure BlueZ for BLE-only mode

By default, BlueZ enables classic Bluetooth (BR/EDR) alongside BLE. Classic mode advertises audio profiles (A2DP, Handsfree, etc.) and uses the system hostname as the device name, which overrides the BLE service name.

Since the gripette only needs BLE, disable classic Bluetooth:

```bash
sudo nano /etc/bluetooth/main.conf
```

Find the `[General]` section (or create it) and set:

```ini
[General]
ControllerMode = le
```

Then restart BlueZ:

```bash
sudo systemctl restart bluetooth
```

Verify with:

```bash
sudo bluetoothctl show
```

You should see no audio UUIDs (A/V Remote Control, Handsfree, Audio Source/Sink). The device will advertise only as a BLE peripheral with the name "Gripette".

### 3. Install the systemd service

```bash
sudo cp systemd/gripette-bluetooth.service /etc/systemd/system/
sudo systemctl daemon-reload
sudo systemctl enable gripette-bluetooth
sudo systemctl start gripette-bluetooth
```

Check it's running:

```bash
sudo systemctl status gripette-bluetooth
```

### 4. (Optional) Change the PIN

The default PIN is `00000`. To change it, edit the systemd service:

```bash
sudo systemctl edit gripette-bluetooth
```

Add:

```ini
[Service]
Environment=GRIPPER_BT_PIN=12345
```

Then restart:

```bash
sudo systemctl restart gripette-bluetooth
```

## Configuring WiFi from a Phone or Laptop

### 1. Open the Web Bluetooth tool

Open the [BT Tool](https://pollen-robotics.github.io/grabette/) in **Chrome** or **Edge**, then pick **Gripette** in the device chooser (Web Bluetooth requires HTTPS — Firefox and Safari are not supported). It's the single shared page that provisions any robot.

### 2. Connect

Click **"Connect to Gripette"**. A browser popup will show nearby BLE devices. Select **"Gripette"** and click Pair.

### 3. Verify connection

Click **"Ping"**. You should see `PONG` in the log.

### 4. Send WiFi credentials

Enter the SSID and password, then click **"Connect WiFi"**. The tool sends the PIN, exchanges keys and seals the password before sending it (see the command reference below); the Pi then connects via an explicit WPA-PSK `nmcli` profile.

The tool tries the default PIN (`00000`) on its own. If you changed it, the browser asks for it the first time the device rejects the default, and reuses it until the page is closed.

### 5. Verify

Click **"Read Network Status"**. If successful, you should see something like:

```
CONNECTED [wlan0] 192.168.1.36
```

The gripette is now on your WiFi network.

## BLE command reference

The web tool wraps these, but the commands are also usable directly — written as UTF-8 to the COMMAND characteristic; responses arrive as notifications:

| Command | Response | Description |
|---|---|---|
| `PING` | `PONG` | Health check |
| `PIN_xxxxx` | `OK: Connected` / `ERROR: Incorrect PIN` | Authenticate (required before the WIFI commands); rate-limited, 5 wrong PINs lock further attempts for 30s, doubling on each repeat |
| `WIFI_SCAN` | JSON array of SSIDs | Nearby networks, strongest first |
| `WIFI_KEYEX` | `{"kid","pk","alg"}` | The robot's ephemeral X25519 public key; no auth needed |
| `WIFI_CONNECT_ENC <json>` | `OK: Connecting to <ssid>` / `ERROR: ...` | Connect, with the password sealed (see below) |
| `WIFI_RESET` | `OK: WiFi connections cleared (<n> removed)` | Delete all saved WiFi networks |

The WiFi password is **never sent in clear**: the client runs `WIFI_KEYEX`, derives a shared key from its own ephemeral X25519 key with `HKDF-SHA256` (salt = the PIN), seals the password with `AES-256-GCM` (AAD = the SSID), and sends `{ssid,kid,epk,nonce,ct}`. `WIFI_CONNECT_ENC` and `WIFI_RESET` consume the authentication — re-send `PIN_xxxxx` before another one; `WIFI_SCAN` does not.

Network status is also readable from a dedicated BLE characteristic (auto-updates every 10s).

## Troubleshooting

### Device shows as hostname (e.g., "raspiZ") instead of "Gripette"

Classic Bluetooth is still active. Follow step 2 above to set `ControllerMode = le` in `/etc/bluetooth/main.conf`.

### Device appears as an audio device

Same cause — classic Bluetooth profiles are active. Set `ControllerMode = le`.

### "Incorrect PIN or passkey" when pairing

Stale pairing data. Remove the device from both sides:

- **On your phone/laptop**: Bluetooth settings → find the device → Forget/Remove
- **On the Pi**:
  ```bash
  sudo bluetoothctl
  paired-devices
  remove XX:XX:XX:XX:XX:XX   # use the MAC address shown
  exit
  sudo systemctl restart gripette-bluetooth
  ```

### Web page shows "Disconnected" and nothing happens on click

- **Wrong browser**: Web Bluetooth only works in Chrome and Edge. Firefox and Safari are not supported.
- **Not HTTPS**: Web Bluetooth requires a secure context. Use the GitHub Pages link (HTTPS) or `localhost` for local testing:
  ```bash
  python3 -m http.server 8080 --directory docs/
  # Then open http://localhost:8080 in Chrome
  ```

### No BLE devices found in the browser popup

- Make sure the bluetooth service is running: `sudo systemctl status gripette-bluetooth`
- Check that BLE is unblocked: `rfkill list bluetooth`
- If blocked: `sudo rfkill unblock bluetooth`

### WiFi connection fails

- Verify the SSID and password are correct
- Check that NetworkManager is running: `systemctl status NetworkManager`
- Check available networks: `nmcli device wifi list`
- Check logs: `sudo journalctl -u gripette-bluetooth -f`

### Service won't start

Check logs for the actual error:

```bash
sudo journalctl -u gripette-bluetooth -e
```

Common causes:
- Missing dependencies: `sudo apt install python3-dbus python3-gi`
- BlueZ not running: `sudo systemctl start bluetooth`
- Another process using the BLE adapter
