pollen-robotics/grabette/docs/media/getting-started.jpg

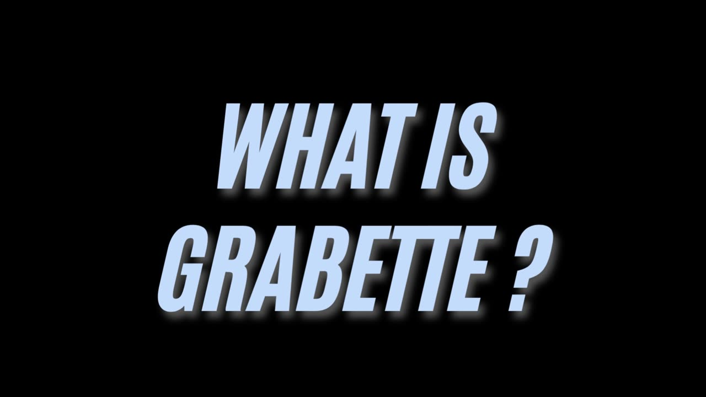
docs/media/getting-started.jpg
