pollen-robotics/grabette/packages/grabette/urdf/grabette_left/robot.urdf

<?xml version="1.0" ?>
<!-- Generated using onshape-to-robot -->
<!-- Onshape https://cad.onshape.com/documents/8728c7fdb0e0b3c78180e1fb/w/25c822efb72989a8d89a69ff/e/724e65bc9d4ec97a8392b3b0 -->
<robot name="grabette_left">
  <!-- Link grip_l -->
  <link name="grip_l">
    <inertial>
      <origin xyz="0.0240646 -0.0278499 -0.027438" rpy="0 0 0"/>
      <mass value="0.255807"/>
      <inertia ixx="0.000771636" ixy="-9.6858e-05" ixz="-0.000175444" iyy="0.00108165" iyz="1.16152e-05" izz="0.000572696"/>
    </inertial>
    <!-- Part std00333_plast_tcb_torx_2_5x8__configuration_copy_of_default -->
    <visual>
      <origin xyz="0.0263486 -0.0394281 0.0598084" rpy="-1.22173 -0 -3.14159"/>
      <geometry>
        <mesh filename="package://assets/std00333_plast_tcb_torx_2_5x8__configuration_copy_of_default.stl"/>
      </geometry>
      <material name="std00333_plast_tcb_torx_2_5x8__configuration_copy_of_default_material">
        <color rgba="0.901961 0.901961 0.901961 1"/>
      </material>
    </visual>
    <collision>
      <origin xyz="0.0263486 -0.0394281 0.0598084" rpy="-1.22173 -0 -3.14159"/>
      <geometry>
        <mesh filename="package://assets/std00333_plast_tcb_torx_2_5x8__configuration_copy_of_default.stl"/>
      </geometry>
    </collision>
    <!-- Part std00333_plast_tcb_torx_2_5x8__configuration_copy_of_default_2 -->
    <visual>
      <origin xyz="0.0259436 -0.0596 0.0172" rpy="-1.5708 -0 -0"/>
      <geometry>
        <mesh filename="package://assets/std00333_plast_tcb_torx_2_5x8__configuration_copy_of_default.stl"/>
      </geometry>
      <material name="std00333_plast_tcb_torx_2_5x8__configuration_copy_of_default_2_material">
        <color rgba="0.901961 0.901961 0.901961 1"/>
      </material>
    </visual>
    <collision>
      <origin xyz="0.0259436 -0.0596 0.0172" rpy="-1.5708 -0 -0"/>
      <geometry>
        <mesh filename="package://assets/std00333_plast_tcb_torx_2_5x8__configuration_copy_of_default.stl"/>
      </geometry>
    </collision>
    <!-- Part std00333_plast_tcb_torx_2_5x8__configuration_copy_of_default_3 -->
    <visual>
      <origin xyz="0.0966323 0.0249261 -0.0232" rpy="1.5708 -0 -0.399274"/>
      <geometry>
        <mesh filename="package://assets/std00333_plast_tcb_torx_2_5x8__configuration_copy_of_default.stl"/>
      </geometry>
      <material name="std00333_plast_tcb_torx_2_5x8__configuration_copy_of_default_3_material">
        <color rgba="0.901961 0.901961 0.901961 1"/>
      </material>
    </visual>
    <collision>
      <origin xyz="0.0966323 0.0249261 -0.0232" rpy="1.5708 -0 -0.399274"/>
      <geometry>
        <mesh filename="package://assets/std00333_plast_tcb_torx_2_5x8__configuration_copy_of_default.stl"/>
      </geometry>
    </collision>
    <!-- Part cameras_holder_l -->
    <visual>
      <origin xyz="0.210444 0.0157273 0.001" rpy="0 -0 -0"/>
      <geometry>
        <mesh filename="package://assets/cameras_holder_l.stl"/>
      </geometry>
      <material name="cameras_holder_l_material">
        <color rgba="0.262745 0.282353 0.301961 1"/>
      </material>
    </visual>
    <collision>
      <origin xyz="0.210444 0.0157273 0.001" rpy="0 -0 -0"/>
      <geometry>
        <mesh filename="package://assets/cameras_holder_l.stl"/>
      </geometry>
    </collision>
    <!-- Part hmi -->
    <visual>
      <origin xyz="0.0694271 -0.0183 0.00404" rpy="-3.14159 -0 1.13446"/>
      <geometry>
        <mesh filename="package://assets/hmi.stl"/>
      </geometry>
      <material name="hmi_material">
        <color rgba="0.231373 0.380392 0.705882 1"/>
      </material>
    </visual>
    <collision>
      <origin xyz="0.0694271 -0.0183 0.00404" rpy="-3.14159 -0 1.13446"/>
      <geometry>
        <mesh filename="package://assets/hmi.stl"/>
      </geometry>
    </collision>
    <!-- Part grip_shell_l -->
    <visual>
      <origin xyz="0.210444 0.0157273 0.001" rpy="0 -0 -0"/>
      <geometry>
        <mesh filename="package://assets/grip_shell_l.stl"/>
      </geometry>
      <material name="grip_shell_l_material">
        <color rgba="1 1 1 1"/>
      </material>
    </visual>
    <collision>
      <origin xyz="0.210444 0.0157273 0.001" rpy="0 -0 -0"/>
      <geometry>
        <mesh filename="package://assets/grip_shell_l.stl"/>
      </geometry>
    </collision>
    <!-- Part raspi_box_l -->
    <visual>
      <origin xyz="0.156727 -0.040775 -0.0933453" rpy="0 0 -1.5708"/>
      <geometry>
        <mesh filename="package://assets/raspi_box_l.stl"/>
      </geometry>
      <material name="raspi_box_l_material">
        <color rgba="0.262745 0.282353 0.301961 1"/>
      </material>
    </visual>
    <collision>
      <origin xyz="0.156727 -0.040775 -0.0933453" rpy="0 0 -1.5708"/>
      <geometry>
        <mesh filename="package://assets/raspi_box_l.stl"/>
      </geometry>
    </collision>
    <!-- Part hex_socket_head_cap_screw_m4x0_70_x_8__a416dc2a8d778a4ef6150c0739aa89d1 -->
    <visual>
      <origin xyz="0.00484864 -0.056 0.0322246" rpy="1.5708 -0 -0"/>
      <geometry>
        <mesh filename="package://assets/hex_socket_head_cap_screw_m4x0_70_x_8__a416dc2a8d778a4ef6150c0739aa89d1.stl"/>
      </geometry>
      <material name="hex_socket_head_cap_screw_m4x0_70_x_8__a416dc2a8d778a4ef6150c0739aa89d1_material">
        <color rgba="0.603922 0.647059 0.686275 1"/>
      </material>
    </visual>
    <collision>
      <origin xyz="0.00484864 -0.056 0.0322246" rpy="1.5708 -0 -0"/>
      <geometry>
        <mesh filename="package://assets/hex_socket_head_cap_screw_m4x0_70_x_8__a416dc2a8d778a4ef6150c0739aa89d1.stl"/>
      </geometry>
    </collision>
    <!-- Part part_1__configuration_copy_of_2x5 -->
    <visual>
      <origin xyz="0.0575889 -0.0271237 0.00554" rpy="-3.14159 -0 -2.00713"/>
      <geometry>
        <mesh filename="package://assets/part_1__configuration_copy_of_2x5.stl"/>
      </geometry>
      <material name="part_1__configuration_copy_of_2x5_material">
        <color rgba="0.901961 0.901961 0.901961 1"/>
      </material>
    </visual>
    <collision>
      <origin xyz="0.0575889 -0.0271237 0.00554" rpy="-3.14159 -0 -2.00713"/>
      <geometry>
        <mesh filename="package://assets/part_1__configuration_copy_of_2x5.stl"/>
      </geometry>
    </collision>
    <!-- Part arducam_fisheye -->
    <visual>
      <origin xyz="0.0408486 -0.0374758 0.0745284" rpy="3.14159 1.22173 -1.5708"/>
      <geometry>
        <mesh filename="package://assets/arducam_fisheye.stl"/>
      </geometry>
      <material name="arducam_fisheye_material">
        <color rgba="0.235294 0.235294 0.235294 1"/>
      </material>
    </visual>
    <collision>
      <origin xyz="0.0408486 -0.0374758 0.0745284" rpy="3.14159 1.22173 -1.5708"/>
      <geometry>
        <mesh filename="package://assets/arducam_fisheye.stl"/>
      </geometry>
    </collision>
    <!-- Part std00333_plast_tcb_torx_2_5x8__configuration_copy_of_default_4 -->
    <visual>
      <origin xyz="0.0553486 -0.0295095 0.0870595" rpy="-1.22173 -0 -3.14159"/>
      <geometry>
        <mesh filename="package://assets/std00333_plast_tcb_torx_2_5x8__configuration_copy_of_default.stl"/>
      </geometry>
      <material name="std00333_plast_tcb_torx_2_5x8__configuration_copy_of_default_4_material">
        <color rgba="0.901961 0.901961 0.901961 1"/>
      </material>
    </visual>
    <collision>
      <origin xyz="0.0553486 -0.0295095 0.0870595" rpy="-1.22173 -0 -3.14159"/>
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
      <geometry>
        <mesh filename="package://assets/button.stl"/>
      </geometry>
    </collision>
    <!-- Part grip_l -->
    <visual>
      <origin xyz="0.210444 0.0157273 0.001" rpy="0 -0 -0"/>
      <geometry>
        <mesh filename="package://assets/grip_l.stl"/>
      </geometry>
      <material name="grip_l_material">
        <color rgba="0.917647 0.917647 0.917647 1"/>
      </material>
    </visual>
    <collision>
      <origin xyz="0.210444 0.0157273 0.001" rpy="0 -0 -0"/>
      <geometry>
        <mesh filename="package://assets/grip_l.stl"/>
      </geometry>
    </collision>
    <!-- Part radial_magnet__configuration__4x2mm -->
    <visual>
      <origin xyz="0 0 0.002" rpy="0 -0 -0"/>
      <geometry>
        <mesh filename="package://assets/radial_magnet__configuration__4x2mm.stl"/>
      </geometry>
      <material name="radial_magnet__configuration__4x2mm_material">
        <color rgba="0.713725 0.760784 0.8 1"/>
      </material>
    </visual>
    <collision>
      <origin xyz="0 0 0.002" rpy="0 -0 -0"/>
      <geometry>
        <mesh filename="package://assets/radial_magnet__configuration__4x2mm.stl"/>
      </geometry>
    </collision>
    <!-- Part std00333_plast_tcb_torx_2_5x8__configuration_copy_of_default_9 -->
    <visual>
      <origin xyz="0.0559436 -0.0596 0.0172" rpy="-1.5708 -0 -0"/>
      <geometry>
        <mesh filename="package://assets/std00333_plast_tcb_torx_2_5x8__configuration_copy_of_default.stl"/>
      </geometry>
      <material name="std00333_plast_tcb_torx_2_5x8__configuration_copy_of_default_9_material">
        <color rgba="0.901961 0.901961 0.901961 1"/>
      </material>
    </visual>
    <collision>
      <origin xyz="0.0559436 -0.0596 0.0172" rpy="-1.5708 -0 -0"/>
      <geometry>
        <mesh filename="package://assets/std00333_plast_tcb_torx_2_5x8__configuration_copy_of_default.stl"/>
      </geometry>
    </collision>
    <!-- Part std00333_plast_tcb_torx_2_5x8__configuration_copy_of_default_10 -->
    <visual>
      <origin xyz="-0.0228729 -0.021225 -0.0883453" rpy="3.14159 -1.5708 0"/>
      <geometry>
        <mesh filename="package://assets/std00333_plast_tcb_torx_2_5x8__configuration_copy_of_default.stl"/>
      </geometry>
      <material name="std00333_plast_tcb_torx_2_5x8__configuration_copy_of_default_10_material">
        <color rgba="0.901961 0.901961 0.901961 1"/>
      </material>
    </visual>
    <collision>
      <origin xyz="-0.0228729 -0.021225 -0.0883453" rpy="3.14159 -1.5708 0"/>
      <geometry>
        <mesh filename="package://assets/std00333_plast_tcb_torx_2_5x8__configuration_copy_of_default.stl"/>
      </geometry>
    </collision>
    <!-- Part hex_socket_head_cap_screw_m4x0_70_x_8__a416dc2a8d778a4ef6150c0739aa89d1_2 -->
    <visual>
      <origin xyz="0.0498486 -0.056 0.0322246" rpy="1.5708 -0 -0"/>
      <geometry>
        <mesh filename="package://assets/hex_socket_head_cap_screw_m4x0_70_x_8__a416dc2a8d778a4ef6150c0739aa89d1.stl"/>
      </geometry>
      <material name="hex_socket_head_cap_screw_m4x0_70_x_8__a416dc2a8d778a4ef6150c0739aa89d1_2_material">
        <color rgba="0.603922 0.647059 0.686275 1"/>
      </material>
    </visual>
    <collision>
      <origin xyz="0.0498486 -0.056 0.0322246" rpy="1.5708 -0 -0"/>
      <geometry>
        <mesh filename="package://assets/hex_socket_head_cap_screw_m4x0_70_x_8__a416dc2a8d778a4ef6150c0739aa89d1.stl"/>
      </geometry>
    </collision>
    <!-- Part std00333_plast_tcb_torx_2_5x8__configuration_copy_of_default_11 -->
    <visual>
      <origin xyz="-0.0228729 -0.040775 -0.0383453" rpy="3.14159 -1.5708 0"/>
      <geometry>
        <mesh filename="package://assets/std00333_plast_tcb_torx_2_5x8__configuration_copy_of_default.stl"/>
      </geometry>
      <material name="std00333_plast_tcb_torx_2_5x8__configuration_copy_of_default_11_material">
        <color rgba="0.901961 0.901961 0.901961 1"/>
      </material>
    </visual>
    <collision>
      <origin xyz="-0.0228729 -0.040775 -0.0383453" rpy="3.14159 -1.5708 0"/>
      <geometry>
        <mesh filename="package://assets/std00333_plast_tcb_torx_2_5x8__configuration_copy_of_default.stl"/>
      </geometry>
    </collision>
    <!-- Part grip_soft_tip_l -->
    <visual>
      <origin xyz="0.210444 0.0157273 0.001" rpy="0 -0 -0"/>
      <geometry>
        <mesh filename="package://assets/grip_soft_tip_l.stl"/>
      </geometry>
      <material name="grip_soft_tip_l_material">
        <color rgba="0.301961 0.301961 0.301961 1"/>
      </material>
    </visual>
    <collision>
      <origin xyz="0.210444 0.0157273 0.001" rpy="0 -0 -0"/>
      <geometry>
        <mesh filename="package://assets/grip_soft_tip_l.stl"/>
      </geometry>
    </collision>
    <!-- Part std00333_plast_tcb_torx_2_5x8__configuration_copy_of_default_12 -->
    <visual>
      <origin xyz="-0.0228729 -0.021225 -0.0383453" rpy="3.14159 -1.5708 0"/>
      <geometry>
        <mesh filename="package://assets/std00333_plast_tcb_torx_2_5x8__configuration_copy_of_default.stl"/>
      </geometry>
      <material name="std00333_plast_tcb_torx_2_5x8__configuration_copy_of_default_12_material">
        <color rgba="0.901961 0.901961 0.901961 1"/>
      </material>
    </visual>
    <collision>
      <origin xyz="-0.0228729 -0.021225 -0.0383453" rpy="3.14159 -1.5708 0"/>
      <geometry>
        <mesh filename="package://assets/std00333_plast_tcb_torx_2_5x8__configuration_copy_of_default.stl"/>
      </geometry>
    </collision>
    <!-- Part std00333_plast_tcb_torx_2_5x8__configuration_copy_of_default_13 -->
    <visual>
      <origin xyz="0.0553486 -0.0394281 0.0598084" rpy="-1.22173 -0 -3.14159"/>
      <geometry>
        <mesh filename="package://assets/std00333_plast_tcb_torx_2_5x8__configuration_copy_of_default.stl"/>
      </geometry>
      <material name="std00333_plast_tcb_torx_2_5x8__configuration_copy_of_default_13_material">
        <color rgba="0.901961 0.901961 0.901961 1"/>
      </material>
    </visual>
    <collision>
      <origin xyz="0.0553486 -0.0394281 0.0598084" rpy="-1.22173 -0 -3.14159"/>
      <geometry>
        <mesh filename="package://assets/std00333_plast_tcb_torx_2_5x8__configuration_copy_of_default.stl"/>
      </geometry>
    </collision>
    <!-- Part hexalobular_socket_pan_head_screw_m2_5x0_45_x_16__d027c88750a7a6e541e7a7a21ff46b0b -->
    <visual>
      <origin xyz="-0.0530179 -0.016075 -0.0875569" rpy="0 -1.5708 0"/>
      <geometry>
        <mesh filename="package://assets/hexalobular_socket_pan_head_screw_m2_5x0_45_x_16__d027c88750a7a6e541e7a7a21ff46b0b.stl"/>
      </geometry>
      <material name="hexalobular_socket_pan_head_screw_m2_5x0_45_x_16__d027c88750a7a6e541e7a7a21ff46b0b_material">
        <color rgba="0.603922 0.647059 0.686275 1"/>
      </material>
    </visual>
    <collision>
      <origin xyz="-0.0530179 -0.016075 -0.0875569" rpy="0 -1.5708 0"/>
      <geometry>
        <mesh filename="package://assets/hexalobular_socket_pan_head_screw_m2_5x0_45_x_16__d027c88750a7a6e541e7a7a21ff46b0b.stl"/>
      </geometry>
    </collision>
    <!-- Part spacer_h8_5 -->
    <visual>
      <origin xyz="-0.0415779 0.0249758 -0.0875569" rpy="0 -1.5708 0"/>
      <geometry>
        <mesh filename="package://assets/spacer_h8_5.stl"/>
      </geometry>
      <material name="spacer_h8_5_material">
        <color rgba="0.262745 0.282353 0.301961 1"/>
      </material>
    </visual>
    <collision>
      <origin xyz="-0.0415779 0.0249758 -0.0875569" rpy="0 -1.5708 0"/>
      <geometry>
        <mesh filename="package://assets/spacer_h8_5.stl"/>
      </geometry>
    </collision>
    <!-- Part spacer_h8_5_2 -->
    <visual>
      <origin xyz="-0.0415779 0.0249758 -0.0295569" rpy="0 -1.5708 0"/>
      <geometry>
        <mesh filename="package://assets/spacer_h8_5.stl"/>
      </geometry>
      <material name="spacer_h8_5_2_material">
        <color rgba="0.262745 0.282353 0.301961 1"/>
      </material>
    </visual>
    <collision>
      <origin xyz="-0.0415779 0.0249758 -0.0295569" rpy="0 -1.5708 0"/>
      <geometry>
        <mesh filename="package://assets/spacer_h8_5.stl"/>
      </geometry>
    </collision>
    <!-- Part raspberry_pi_4_model_b -->
    <visual>
      <origin xyz="-0.0407879 -0.040575 -0.0485569" rpy="1.5708 -1.5708 0"/>
      <geometry>
        <mesh filename="package://assets/raspberry_pi_4_model_b.stl"/>
      </geometry>
      <material name="raspberry_pi_4_model_b_material">
        <color rgba="0.713725 0.760784 0.8 1"/>
      </material>
    </visual>
    <collision>
      <origin xyz="-0.0407879 -0.040575 -0.0485569" rpy="1.5708 -1.5708 0"/>
      <geometry>
        <mesh filename="package://assets/raspberry_pi_4_model_b.stl"/>
      </geometry>
    </collision>
    <!-- Part hexalobular_socket_pan_head_screw_m2_5x0_45_x_16__d027c88750a7a6e541e7a7a21ff46b0b_2 -->
    <visual>
      <origin xyz="-0.0530179 -0.016075 -0.0295569" rpy="0 -1.5708 0"/>
      <geometry>
        <mesh filename="package://assets/hexalobular_socket_pan_head_screw_m2_5x0_45_x_16__d027c88750a7a6e541e7a7a21ff46b0b.stl"/>
      </geometry>
      <material name="hexalobular_socket_pan_head_screw_m2_5x0_45_x_16__d027c88750a7a6e541e7a7a21ff46b0b_2_material">
        <color rgba="0.603922 0.647059 0.686275 1"/>
      </material>
    </visual>
    <collision>
      <origin xyz="-0.0530179 -0.016075 -0.0295569" rpy="0 -1.5708 0"/>
      <geometry>
        <mesh filename="package://assets/hexalobular_socket_pan_head_screw_m2_5x0_45_x_16__d027c88750a7a6e541e7a7a21ff46b0b.stl"/>
      </geometry>
    </collision>
    <!-- Part pisugar3plus -->
    <visual>
      <origin xyz="-0.0373979 -0.0405815 -0.058576" rpy="-1.5708 1.5708 0"/>
      <geometry>
        <mesh filename="package://assets/pisugar3plus.stl"/>
      </geometry>
      <material name="pisugar3plus_material">
        <color rgba="0.235294 0.235294 0.235294 1"/>
      </material>
    </visual>
    <collision>
      <origin xyz="-0.0373979 -0.0405815 -0.058576" rpy="-1.5708 1.5708 0"/>
      <geometry>
        <mesh filename="package://assets/pisugar3plus.stl"/>
      </geometry>
    </collision>
    <!-- Part ase01187_elec_rpi_hat -->
    <visual>
      <origin xyz="-0.0500779 -0.016525 -0.0875569" rpy="0 -1.5708 0"/>
      <geometry>
        <mesh filename="package://assets/ase01187_elec_rpi_hat.stl"/>
      </geometry>
      <material name="ase01187_elec_rpi_hat_material">
        <color rgba="0.647059 0.647059 0.647059 1"/>
      </material>
    </visual>
    <collision>
      <origin xyz="-0.0500779 -0.016525 -0.0875569" rpy="0 -1.5708 0"/>
      <geometry>
        <mesh filename="package://assets/ase01187_elec_rpi_hat.stl"/>
      </geometry>
    </collision>
    <!-- Part pz_pan_head_screw_m2_5x0_45_x_6__1594e833f5b11f4fecc3a0ad0b729b46 -->
    <visual>
      <origin xyz="-0.0436779 -0.065075 -0.0875569" rpy="0 -1.5708 0"/>
      <geometry>
        <mesh filename="package://assets/pz_pan_head_screw_m2_5x0_45_x_6__1594e833f5b11f4fecc3a0ad0b729b46.stl"/>
      </geometry>
      <material name="pz_pan_head_screw_m2_5x0_45_x_6__1594e833f5b11f4fecc3a0ad0b729b46_material">
        <color rgba="0.603922 0.647059 0.686275 1"/>
      </material>
    </visual>
    <collision>
      <origin xyz="-0.0436779 -0.065075 -0.0875569" rpy="0 -1.5708 0"/>
      <geometry>
        <mesh filename="package://assets/pz_pan_head_screw_m2_5x0_45_x_6__1594e833f5b11f4fecc3a0ad0b729b46.stl"/>
      </geometry>
    </collision>
    <!-- Part pz_pan_head_screw_m2_5x0_45_x_6__1594e833f5b11f4fecc3a0ad0b729b46_2 -->
    <visual>
      <origin xyz="-0.0436779 -0.065075 -0.0295569" rpy="0 -1.5708 0"/>
      <geometry>
        <mesh filename="package://assets/pz_pan_head_screw_m2_5x0_45_x_6__1594e833f5b11f4fecc3a0ad0b729b46.stl"/>
      </geometry>
      <material name="pz_pan_head_screw_m2_5x0_45_x_6__1594e833f5b11f4fecc3a0ad0b729b46_2_material">
        <color rgba="0.603922 0.647059 0.686275 1"/>
      </material>
    </visual>
    <collision>
      <origin xyz="-0.0436779 -0.065075 -0.0295569" rpy="0 -1.5708 0"/>
      <geometry>
        <mesh filename="package://assets/pz_pan_head_screw_m2_5x0_45_x_6__1594e833f5b11f4fecc3a0ad0b729b46.stl"/>
      </geometry>
    </collision>
    <!-- Part 611_00020_1 -->
    <visual>
      <origin xyz="0.0498486 -0.0325 0.0168246" rpy="1.5708 0 3.14159"/>
      <geometry>
        <mesh filename="package://assets/611_00020_1.stl"/>
      </geometry>
      <material name="611_00020_1_material">
        <color rgba="0 0 0 1"/>
      </material>
    </visual>
    <collision>
      <origin xyz="0.0498486 -0.0325 0.0168246" rpy="1.5708 0 3.14159"/>
      <geometry>
        <mesh filename="package://assets/611_00020_1.stl"/>
      </geometry>
    </collision>
    <!-- Part 611_00020 -->
    <visual>
      <origin xyz="0.0498486 -0.0325 0.0168246" rpy="1.5708 0 3.14159"/>
      <geometry>
        <mesh filename="package://assets/611_00020.stl"/>
      </geometry>
      <material name="611_00020_material">
        <color rgba="0 0 0 1"/>
      </material>
    </visual>
    <collision>
      <origin xyz="0.0498486 -0.0325 0.0168246" rpy="1.5708 0 3.14159"/>
      <geometry>
        <mesh filename="package://assets/611_00020.stl"/>
      </geometry>
    </collision>
    <!-- Part 602_00009_phillips_flat_head__m2_x_0_40mm_thread__14mm_long_screw_92010a802_1 -->
    <visual>
      <origin xyz="0.0498486 -0.0325 0.0168246" rpy="1.5708 0 3.14159"/>
      <geometry>
        <mesh filename="package://assets/602_00009_phillips_flat_head__m2_x_0_40mm_thread__14mm_long_screw_92010a802_1.stl"/>
      </geometry>
      <material name="602_00009_phillips_flat_head__m2_x_0_40mm_thread__14mm_long_screw_92010a802_1_material">
        <color rgba="0 0 0 1"/>
      </material>
    </visual>
    <collision>
      <origin xyz="0.0498486 -0.0325 0.0168246" rpy="1.5708 0 3.14159"/>
      <geometry>
        <mesh filename="package://assets/602_00009_phillips_flat_head__m2_x_0_40mm_thread__14mm_long_screw_92010a802_1.stl"/>
      </geometry>
    </collision>
    <!-- Part sr_lens_py058 -->
    <visual>
      <origin xyz="0.0498486 -0.0325 0.0168246" rpy="1.5708 0 3.14159"/>
      <geometry>
        <mesh filename="package://assets/sr_lens_py058.stl"/>
      </geometry>
      <material name="sr_lens_py058_material">
        <color rgba="0.262745 0.282353 0.301961 0.376471"/>
      </material>
    </visual>
    <collision>
      <origin xyz="0.0498486 -0.0325 0.0168246" rpy="1.5708 0 3.14159"/>
      <geometry>
        <mesh filename="package://assets/sr_lens_py058.stl"/>
      </geometry>
    </collision>
    <!-- Part 602_00009_phillips_flat_head__m2_x_0_40mm_thread__14mm_long_screw_92010a802 -->
    <visual>
      <origin xyz="0.0498486 -0.0325 0.0168246" rpy="1.5708 0 3.14159"/>
      <geometry>
        <mesh filename="package://assets/602_00009_phillips_flat_head__m2_x_0_40mm_thread__14mm_long_screw_92010a802.stl"/>
      </geometry>
      <material name="602_00009_phillips_flat_head__m2_x_0_40mm_thread__14mm_long_screw_92010a802_material">
        <color rgba="0 0 0 1"/>
      </material>
    </visual>
    <collision>
      <origin xyz="0.0498486 -0.0325 0.0168246" rpy="1.5708 0 3.14159"/>
      <geometry>
        <mesh filename="package://assets/602_00009_phillips_flat_head__m2_x_0_40mm_thread__14mm_long_screw_92010a802.stl"/>
      </geometry>
    </collision>
    <!-- Part 612_00001_tim_thermal_oak_d_poe -->
    <visual>
      <origin xyz="0.0498486 -0.0325 0.0168246" rpy="1.5708 0 3.14159"/>
      <geometry>
        <mesh filename="package://assets/612_00001_tim_thermal_oak_d_poe.stl"/>
      </geometry>
      <material name="612_00001_tim_thermal_oak_d_poe_material">
        <color rgba="0.596078 0.666667 0.686275 1"/>
      </material>
    </visual>
    <collision>
      <origin xyz="0.0498486 -0.0325 0.0168246" rpy="1.5708 0 3.14159"/>
      <geometry>
        <mesh filename="package://assets/612_00001_tim_thermal_oak_d_poe.stl"/>
      </geometry>
    </collision>
    <!-- Part lens_adhesive -->
    <visual>
      <origin xyz="0.0498486 -0.0325 0.0168246" rpy="1.5708 0 3.14159"/>
      <geometry>
        <mesh filename="package://assets/lens_adhesive.stl"/>
      </geometry>
      <material name="lens_adhesive_material">
        <color rgba="0.262745 0.282353 0.301961 1"/>
      </material>
    </visual>
    <collision>
      <origin xyz="0.0498486 -0.0325 0.0168246" rpy="1.5708 0 3.14159"/>
      <geometry>
        <mesh filename="package://assets/lens_adhesive.stl"/>
      </geometry>
    </collision>
    <!-- Part 606_00021_sr_back_cover_py074 -->
    <visual>
      <origin xyz="0.0498486 -0.0325 0.0168246" rpy="1.5708 0 3.14159"/>
      <geometry>
        <mesh filename="package://assets/606_00021_sr_back_cover_py074.stl"/>
      </geometry>
      <material name="606_00021_sr_back_cover_py074_material">
        <color rgba="0.262745 0.282353 0.301961 1"/>
      </material>
    </visual>
    <collision>
      <origin xyz="0.0498486 -0.0325 0.0168246" rpy="1.5708 0 3.14159"/>
      <geometry>
        <mesh filename="package://assets/606_00021_sr_back_cover_py074.stl"/>
      </geometry>
    </collision>
    <!-- Part 602_00009_phillips_flat_head__m2_x_0_40mm_thread__14mm_long_screw_92010a802_2 -->
    <visual>
      <origin xyz="0.0498486 -0.0325 0.0168246" rpy="1.5708 0 3.14159"/>
      <geometry>
        <mesh filename="package://assets/602_00009_phillips_flat_head__m2_x_0_40mm_thread__14mm_long_screw_92010a802_2.stl"/>
      </geometry>
      <material name="602_00009_phillips_flat_head__m2_x_0_40mm_thread__14mm_long_screw_92010a802_2_material">
        <color rgba="0 0 0 1"/>
      </material>
    </visual>
    <collision>
      <origin xyz="0.0498486 -0.0325 0.0168246" rpy="1.5708 0 3.14159"/>
      <geometry>
        <mesh filename="package://assets/602_00009_phillips_flat_head__m2_x_0_40mm_thread__14mm_long_screw_92010a802_2.stl"/>
      </geometry>
    </collision>
    <!-- Part 602_00009_phillips_flat_head__m2_x_0_40mm_thread__14mm_long_screw_92010a802_3 -->
    <visual>
      <origin xyz="0.0498486 -0.0325 0.0168246" rpy="1.5708 0 3.14159"/>
      <geometry>
        <mesh filename="package://assets/602_00009_phillips_flat_head__m2_x_0_40mm_thread__14mm_long_screw_92010a802_3.stl"/>
      </geometry>
      <material name="602_00009_phillips_flat_head__m2_x_0_40mm_thread__14mm_long_screw_92010a802_3_material">
        <color rgba="0 0 0 1"/>
      </material>
    </visual>
    <collision>
      <origin xyz="0.0498486 -0.0325 0.0168246" rpy="1.5708 0 3.14159"/>
      <geometry>
        <mesh filename="package://assets/602_00009_phillips_flat_head__m2_x_0_40mm_thread__14mm_long_screw_92010a802_3.stl"/>
      </geometry>
    </collision>
    <!-- Part 606_00020_sr_front_cover -->
    <visual>
      <origin xyz="0.0498486 -0.0325 0.0168246" rpy="1.5708 0 3.14159"/>
      <geometry>
        <mesh filename="package://assets/606_00020_sr_front_cover.stl"/>
      </geometry>
      <material name="606_00020_sr_front_cover_material">
        <color rgba="0.262745 0.282353 0.301961 1"/>
      </material>
    </visual>
    <collision>
      <origin xyz="0.0498486 -0.0325 0.0168246" rpy="1.5708 0 3.14159"/>
      <geometry>
        <mesh filename="package://assets/606_00020_sr_front_cover.stl"/>
      </geometry>
    </collision>
  </link>
  <!-- Frame camera (dummy link + fixed joint) -->
  <link name="camera">
    <origin xyz="0 0 0" rpy="0 -0 0"/>
    <inertial>
      <origin xyz="0 0 0" rpy="0 0 0"/>
      <mass value="1e-9"/>
      <inertia ixx="0" ixy="0" ixz="0" iyy="0" iyz="0" izz="0"/>
    </inertial>
  </link>
  <joint name="camera_frame" type="fixed">
    <origin xyz="0.0408486 -0.0255417 0.0701847" rpy="-1.91986 0 0"/>
    <parent link="grip_l"/>
    <child link="camera"/>
    <axis xyz="0 0 0"/>
  </joint>
  <!-- Frame oak_l (dummy link + fixed joint) -->
  <link name="oak_l">
    <origin xyz="0 0 0" rpy="0 -0 0"/>
    <inertial>
      <origin xyz="0 0 0" rpy="0 0 0"/>
      <mass value="1e-9"/>
      <inertia ixx="0" ixy="0" ixz="0" iyy="0" iyz="0" izz="0"/>
    </inertial>
  </link>
  <joint name="oak_l_frame" type="fixed">
    <origin xyz="0.0173486 -0.025667 0.0298246" rpy="-1.5708 -0 -0"/>
    <parent link="grip_l"/>
    <child link="oak_l"/>
    <axis xyz="0 0 0"/>
  </joint>
  <!-- Frame oak_r (dummy link + fixed joint) -->
  <link name="oak_r">
    <origin xyz="0 0 0" rpy="0 -0 0"/>
    <inertial>
      <origin xyz="0 0 0" rpy="0 0 0"/>
      <mass value="1e-9"/>
      <inertia ixx="0" ixy="0" ixz="0" iyy="0" iyz="0" izz="0"/>
    </inertial>
  </link>
  <joint name="oak_r_frame" type="fixed">
    <origin xyz="0.0373486 -0.025667 0.0298246" rpy="-1.5708 -0 -0"/>
    <parent link="grip_l"/>
    <child link="oak_r"/>
    <axis xyz="0 0 0"/>
  </joint>
  <!-- Frame gripper_base (dummy link + fixed joint) -->
  <link name="gripper_base">
    <origin xyz="0 0 0" rpy="0 -0 0"/>
    <inertial>
      <origin xyz="0 0 0" rpy="0 0 0"/>
      <mass value="1e-9"/>
      <inertia ixx="0" ixy="0" ixz="0" iyy="0" iyz="0" izz="0"/>
    </inertial>
  </link>
  <joint name="gripper_base_frame" type="fixed">
    <origin xyz="0.0337996 -0.055 -0.0232" rpy="1.5708 -0 -0"/>
    <parent link="grip_l"/>
    <child link="gripper_base"/>
    <axis xyz="0 0 0"/>
  </joint>
  <!-- Frame gripper_center (dummy link + fixed joint) -->
  <link name="gripper_center">
    <origin xyz="0 0 0" rpy="0 -0 0"/>
    <inertial>
      <origin xyz="0 0 0" rpy="0 0 0"/>
      <mass value="1e-9"/>
      <inertia ixx="0" ixy="0" ixz="0" iyy="0" iyz="0" izz="0"/>
    </inertial>
  </link>
  <joint name="gripper_center_frame" type="fixed">
    <origin xyz="0.0373485 0.0335873 -0.0232" rpy="-0 -0 1.5708"/>
    <parent link="grip_l"/>
    <child link="gripper_center"/>
    <axis xyz="0 0 0"/>
  </joint>
  <!-- Frame thumb_tip (dummy link + fixed joint) -->
  <link name="thumb_tip">
    <origin xyz="0 0 0" rpy="0 -0 0"/>
    <inertial>
      <origin xyz="0 0 0" rpy="0 0 0"/>
      <mass value="1e-9"/>
      <inertia ixx="0" ixy="0" ixz="0" iyy="0" iyz="0" izz="0"/>
    </inertial>
  </link>
  <joint name="thumb_tip_frame" type="fixed">
    <origin xyz="0.0910992 0.0551614 -0.0232" rpy="-1.5708 0 0.799448"/>
    <parent link="grip_l"/>
    <child link="thumb_tip"/>
    <axis xyz="0 0 0"/>
  </joint>
  <!-- Link proximal_bend_l -->
  <link name="proximal_bend_l">
    <inertial>
      <origin xyz="0.019149 0.0136249 0.0295442" rpy="0 0 0"/>
      <mass value="0.0324903"/>
      <inertia ixx="5.74845e-05" ixy="-2.45216e-06" ixz="-5.37656e-07" iyy="5.32659e-05" iyz="7.01926e-06" izz="1.37202e-05"/>
    </inertial>
    <!-- Part std00333_plast_tcb_torx_2_5x8__configuration_copy_of_default_14 -->
    <visual>
      <origin xyz="0.0243773 -0.00769107 0.1002" rpy="-2.65605 1.5708 0"/>
      <geometry>
        <mesh filename="package://assets/std00333_plast_tcb_torx_2_5x8__configuration_copy_of_default.stl"/>
      </geometry>
      <material name="std00333_plast_tcb_torx_2_5x8__configuration_copy_of_default_14_material">
        <color rgba="0.901961 0.901961 0.901961 1"/>
      </material>
    </visual>
    <collision>
      <origin xyz="0.0243773 -0.00769107 0.1002" rpy="-2.65605 1.5708 0"/>
      <geometry>
        <mesh filename="package://assets/std00333_plast_tcb_torx_2_5x8__configuration_copy_of_default.stl"/>
      </geometry>
    </collision>
    <!-- Part proximal_shell_l -->
    <visual>
      <origin xyz="-0.210444 0.0157273 -0.001" rpy="3.14159 -0 -3.14159"/>
      <geometry>
        <mesh filename="package://assets/proximal_shell_l.stl"/>
      </geometry>
      <material name="proximal_shell_l_material">
        <color rgba="1 1 1 1"/>
      </material>
    </visual>
    <collision>
      <origin xyz="-0.210444 0.0157273 -0.001" rpy="3.14159 -0 -3.14159"/>
      <geometry>
        <mesh filename="package://assets/proximal_shell_l.stl"/>
      </geometry>
    </collision>
    <!-- Part std00333_plast_tcb_torx_2_5x8__configuration_copy_of_default_15 -->
    <visual>
      <origin xyz="0 -0 0.1067" rpy="3.14159 0 -3.14159"/>
      <geometry>
        <mesh filename="package://assets/std00333_plast_tcb_torx_2_5x8__configuration_copy_of_default.stl"/>
      </geometry>
      <material name="std00333_plast_tcb_torx_2_5x8__configuration_copy_of_default_15_material">
        <color rgba="0.901961 0.901961 0.901961 1"/>
      </material>
    </visual>
    <collision>
      <origin xyz="0 -0 0.1067" rpy="3.14159 0 -3.14159"/>
      <geometry>
        <mesh filename="package://assets/std00333_plast_tcb_torx_2_5x8__configuration_copy_of_default.stl"/>
      </geometry>
    </collision>
    <!-- Part proximal_bend_l -->
    <visual>
      <origin xyz="-0.210444 0.0157273 -0.001" rpy="-3.14159 -0 -3.14159"/>
      <geometry>
        <mesh filename="package://assets/proximal_bend_l.stl"/>
      </geometry>
      <material name="proximal_bend_l_material">
        <color rgba="1 1 1 1"/>
      </material>
    </visual>
    <collision>
      <origin xyz="-0.210444 0.0157273 -0.001" rpy="-3.14159 -0 -3.14159"/>
      <geometry>
        <mesh filename="package://assets/proximal_bend_l.stl"/>
      </geometry>
    </collision>
    <!-- Part part_1__configuration_copy_of_2x5_3 -->
    <visual>
      <origin xyz="0.0375014 0.033803 -0.00914" rpy="-0 0 -0.698124"/>
      <geometry>
        <mesh filename="package://assets/part_1__configuration_copy_of_2x5.stl"/>
      </geometry>
      <material name="part_1__configuration_copy_of_2x5_3_material">
        <color rgba="0.901961 0.901961 0.901961 1"/>
      </material>
    </visual>
    <collision>
      <origin xyz="0.0375014 0.033803 -0.00914" rpy="-0 0 -0.698124"/>
      <geometry>
        <mesh filename="package://assets/part_1__configuration_copy_of_2x5.stl"/>
      </geometry>
    </collision>
    <!-- Part pivot_bot_l -->
    <visual>
      <origin xyz="-0.210444 0.0157273 -0.001" rpy="3.14159 0 -3.14159"/>
      <geometry>
        <mesh filename="package://assets/pivot_bot_l.stl"/>
      </geometry>
      <material name="pivot_bot_l_material">
        <color rgba="1 1 1 1"/>
      </material>
    </visual>
    <collision>
      <origin xyz="-0.210444 0.0157273 -0.001" rpy="3.14159 0 -3.14159"/>
      <geometry>
        <mesh filename="package://assets/pivot_bot_l.stl"/>
      </geometry>
    </collision>
    <!-- Part part_1__configuration_copy_of_2x5_4 -->
    <visual>
      <origin xyz="0.00536235 -0.00449947 -0.00914" rpy="-0 0 -0.698124"/>
      <geometry>
        <mesh filename="package://assets/part_1__configuration_copy_of_2x5.stl"/>
      </geometry>
      <material name="part_1__configuration_copy_of_2x5_4_material">
        <color rgba="0.901961 0.901961 0.901961 1"/>
      </material>
    </visual>
    <collision>
      <origin xyz="0.00536235 -0.00449947 -0.00914" rpy="-0 0 -0.698124"/>
      <geometry>
        <mesh filename="package://assets/part_1__configuration_copy_of_2x5.stl"/>
      </geometry>
    </collision>
    <!-- Part std00333_plast_tcb_torx_2_5x8__configuration_copy_of_default_16 -->
    <visual>
      <origin xyz="0.0246107 -0.00724886 0.0507" rpy="-2.65605 1.5708 0"/>
      <geometry>
        <mesh filename="package://assets/std00333_plast_tcb_torx_2_5x8__configuration_copy_of_default.stl"/>
      </geometry>
      <material name="std00333_plast_tcb_torx_2_5x8__configuration_copy_of_default_16_material">
        <color rgba="0.901961 0.901961 0.901961 1"/>
      </material>
    </visual>
    <collision>
      <origin xyz="0.0246107 -0.00724886 0.0507" rpy="-2.65605 1.5708 0"/>
      <geometry>
        <mesh filename="package://assets/std00333_plast_tcb_torx_2_5x8__configuration_copy_of_default.stl"/>
      </geometry>
    </collision>
    <!-- Part std00333_plast_tcb_torx_2_5x8__configuration_copy_of_default_17 -->
    <visual>
      <origin xyz="0.037678 0.017515 0.0507" rpy="-2.65605 1.5708 0"/>
      <geometry>
        <mesh filename="package://assets/std00333_plast_tcb_torx_2_5x8__configuration_copy_of_default.stl"/>
      </geometry>
      <material name="std00333_plast_tcb_torx_2_5x8__configuration_copy_of_default_17_material">
        <color rgba="0.901961 0.901961 0.901961 1"/>
      </material>
    </visual>
    <collision>
      <origin xyz="0.037678 0.017515 0.0507" rpy="-2.65605 1.5708 0"/>
      <geometry>
        <mesh filename="package://assets/std00333_plast_tcb_torx_2_5x8__configuration_copy_of_default.stl"/>
      </geometry>
    </collision>
    <!-- Part bushing_6x8x4 -->
    <visual>
      <origin xyz="0.0321391 0.0383025 0.0464" rpy="-0 0 3.14159"/>
      <geometry>
        <mesh filename="package://assets/bushing_6x8x4.stl"/>
      </geometry>
      <material name="bushing_6x8x4_material">
        <color rgba="0 0 0 1"/>
      </material>
    </visual>
    <collision>
      <origin xyz="0.0321391 0.0383025 0.0464" rpy="-0 0 3.14159"/>
      <geometry>
        <mesh filename="package://assets/bushing_6x8x4.stl"/>
      </geometry>
    </collision>
    <!-- Part std00333_plast_tcb_torx_2_5x8__configuration_copy_of_default_18 -->
    <visual>
      <origin xyz="0.0285775 0.000268728 0.1002" rpy="-2.65605 1.5708 0"/>
      <geometry>
        <mesh filename="package://assets/std00333_plast_tcb_torx_2_5x8__configuration_copy_of_default.stl"/>
      </geometry>
      <material name="std00333_plast_tcb_torx_2_5x8__configuration_copy_of_default_18_material">
        <color rgba="0.901961 0.901961 0.901961 1"/>
      </material>
    </visual>
    <collision>
      <origin xyz="0.0285775 0.000268728 0.1002" rpy="-2.65605 1.5708 0"/>
      <geometry>
        <mesh filename="package://assets/std00333_plast_tcb_torx_2_5x8__configuration_copy_of_default.stl"/>
      </geometry>
    </collision>
    <!-- Part plain_washer_large_grade_a_m2_5__9a369f0dc77bf9c598cdf3fb468977e5 -->
    <visual>
      <origin xyz="0 -0 0.1048" rpy="-0 -0 -3.14159"/>
      <geometry>
        <mesh filename="package://assets/plain_washer_large_grade_a_m2_5__9a369f0dc77bf9c598cdf3fb468977e5.stl"/>
      </geometry>
      <material name="plain_washer_large_grade_a_m2_5__9a369f0dc77bf9c598cdf3fb468977e5_material">
        <color rgba="0.603922 0.647059 0.686275 1"/>
      </material>
    </visual>
    <collision>
      <origin xyz="0 -0 0.1048" rpy="-0 -0 -3.14159"/>
      <geometry>
        <mesh filename="package://assets/plain_washer_large_grade_a_m2_5__9a369f0dc77bf9c598cdf3fb468977e5.stl"/>
      </geometry>
    </collision>
    <!-- Part bushing_6x8x4_2 -->
    <visual>
      <origin xyz="0 0 0" rpy="3.14159 -0 0"/>
      <geometry>
        <mesh filename="package://assets/bushing_6x8x4.stl"/>
      </geometry>
      <material name="bushing_6x8x4_2_material">
        <color rgba="0 0 0 1"/>
      </material>
    </visual>
    <collision>
      <origin xyz="0 0 0" rpy="3.14159 -0 0"/>
      <geometry>
        <mesh filename="package://assets/bushing_6x8x4.stl"/>
      </geometry>
    </collision>
    <!-- Part part_1__configuration_copy_of_2x5_5 -->
    <visual>
      <origin xyz="0.0267767 0.0428019 -0.00914" rpy="0 -0 2.44347"/>
      <geometry>
        <mesh filename="package://assets/part_1__configuration_copy_of_2x5.stl"/>
      </geometry>
      <material name="part_1__configuration_copy_of_2x5_5_material">
        <color rgba="0.901961 0.901961 0.901961 1"/>
      </material>
    </visual>
    <collision>
      <origin xyz="0.0267767 0.0428019 -0.00914" rpy="0 -0 2.44347"/>
      <geometry>
        <mesh filename="package://assets/part_1__configuration_copy_of_2x5.stl"/>
      </geometry>
    </collision>
    <!-- Part bushing_6x8x4_3 -->
    <visual>
      <origin xyz="0.0321391 0.0383025 -0" rpy="3.14159 -0 -3.14159"/>
      <geometry>
        <mesh filename="package://assets/bushing_6x8x4.stl"/>
      </geometry>
      <material name="bushing_6x8x4_3_material">
        <color rgba="0 0 0 1"/>
      </material>
    </visual>
    <collision>
      <origin xyz="0.0321391 0.0383025 -0" rpy="3.14159 -0 -3.14159"/>
      <geometry>
        <mesh filename="package://assets/bushing_6x8x4.stl"/>
      </geometry>
    </collision>
    <!-- Part bushing_6x8x4_4 -->
    <visual>
      <origin xyz="0 -0 0.1005" rpy="-0 0 -3.14159"/>
      <geometry>
        <mesh filename="package://assets/bushing_6x8x4.stl"/>
      </geometry>
      <material name="bushing_6x8x4_4_material">
        <color rgba="0 0 0 1"/>
      </material>
    </visual>
    <collision>
      <origin xyz="0 -0 0.1005" rpy="-0 0 -3.14159"/>
      <geometry>
        <mesh filename="package://assets/bushing_6x8x4.stl"/>
      </geometry>
    </collision>
    <!-- Part sensor -->
    <visual>
      <origin xyz="-0.00123268 0.0140883 -0.0068" rpy="3.14159 -0 -2.26892"/>
      <geometry>
        <mesh filename="package://assets/sensor.stl"/>
      </geometry>
      <material name="sensor_material">
        <color rgba="0.768627 0.886275 0.952941 1"/>
      </material>
    </visual>
    <collision>
      <origin xyz="-0.00123268 0.0140883 -0.0068" rpy="3.14159 -0 -2.26892"/>
      <geometry>
        <mesh filename="package://assets/sensor.stl"/>
      </geometry>
    </collision>
    <!-- Part part_1__configuration_copy_of_2x5_6 -->
    <visual>
      <origin xyz="-0.00536235 0.00449947 -0.00914" rpy="-0 0 -0.698124"/>
      <geometry>
        <mesh filename="package://assets/part_1__configuration_copy_of_2x5.stl"/>
      </geometry>
      <material name="part_1__configuration_copy_of_2x5_6_material">
        <color rgba="0.901961 0.901961 0.901961 1"/>
      </material>
    </visual>
    <collision>
      <origin xyz="-0.00536235 0.00449947 -0.00914" rpy="-0 0 -0.698124"/>
      <geometry>
        <mesh filename="package://assets/part_1__configuration_copy_of_2x5.stl"/>
      </geometry>
    </collision>
    <!-- Part sensor_2 -->
    <visual>
      <origin xyz="0.0333718 0.0242142 -0.0068" rpy="-3.14159 0 0.872672"/>
      <geometry>
        <mesh filename="package://assets/sensor.stl"/>
      </geometry>
      <material name="sensor_2_material">
        <color rgba="0.768627 0.886275 0.952941 1"/>
      </material>
    </visual>
    <collision>
      <origin xyz="0.0333718 0.0242142 -0.0068" rpy="-3.14159 0 0.872672"/>
      <geometry>
        <mesh filename="package://assets/sensor.stl"/>
      </geometry>
    </collision>
  </link>
  <!-- Link distal_l -->
  <link name="distal_l">
    <inertial>
      <origin xyz="-0.0104681 0.0190995 -0.023707" rpy="0 0 0"/>
      <mass value="0.0254111"/>
      <inertia ixx="1.18331e-05" ixy="1.30414e-06" ixz="1.3505e-07" iyy="8.7926e-06" iyz="-2.46366e-07" izz="7.48869e-06"/>
    </inertial>
    <!-- Part distal_l -->
    <visual>
      <origin xyz="0.242583 -0.0225751 0.001" rpy="-0 -0 -0"/>
      <geometry>
        <mesh filename="package://assets/distal_l.stl"/>
      </geometry>
      <material name="distal_l_material">
        <color rgba="1 1 1 1"/>
      </material>
    </visual>
    <collision>
      <origin xyz="0.242583 -0.0225751 0.001" rpy="-0 -0 -0"/>
      <geometry>
        <mesh filename="package://assets/distal_l.stl"/>
      </geometry>
    </collision>
    <!-- Part std00333_plast_tcb_torx_2_5x8__configuration_copy_of_default_19 -->
    <visual>
      <origin xyz="0 0 -0.0528" rpy="-0 -0 -0"/>
      <geometry>
        <mesh filename="package://assets/std00333_plast_tcb_torx_2_5x8__configuration_copy_of_default.stl"/>
      </geometry>
      <material name="std00333_plast_tcb_torx_2_5x8__configuration_copy_of_default_19_material">
        <color rgba="0.901961 0.901961 0.901961 1"/>
      </material>
    </visual>
    <collision>
      <origin xyz="0 0 -0.0528" rpy="-0 -0 -0"/>
      <geometry>
        <mesh filename="package://assets/std00333_plast_tcb_torx_2_5x8__configuration_copy_of_default.stl"/>
      </geometry>
    </collision>
    <!-- Part std00333_plast_tcb_torx_2_5x8__configuration_copy_of_default_20 -->
    <visual>
      <origin xyz="-0.0251042 0.0257931 -0.0232" rpy="-1.5708 -0 -2.58624"/>
      <geometry>
        <mesh filename="package://assets/std00333_plast_tcb_torx_2_5x8__configuration_copy_of_default.stl"/>
      </geometry>
      <material name="std00333_plast_tcb_torx_2_5x8__configuration_copy_of_default_20_material">
        <color rgba="0.901961 0.901961 0.901961 1"/>
      </material>
    </visual>
    <collision>
      <origin xyz="-0.0251042 0.0257931 -0.0232" rpy="-1.5708 -0 -2.58624"/>
      <geometry>
        <mesh filename="package://assets/std00333_plast_tcb_torx_2_5x8__configuration_copy_of_default.stl"/>
      </geometry>
    </collision>
    <!-- Part radial_magnet__configuration__4x2mm_2 -->
    <visual>
      <origin xyz="-0 -0 0.002" rpy="-0 -0 -0"/>
      <geometry>
        <mesh filename="package://assets/radial_magnet__configuration__4x2mm.stl"/>
      </geometry>
      <material name="radial_magnet__configuration__4x2mm_2_material">
        <color rgba="0.713725 0.760784 0.8 1"/>
      </material>
    </visual>
    <collision>
      <origin xyz="-0 -0 0.002" rpy="-0 -0 -0"/>
      <geometry>
        <mesh filename="package://assets/radial_magnet__configuration__4x2mm.stl"/>
      </geometry>
    </collision>
    <!-- Part distal_soft_tip -->
    <visual>
      <origin xyz="0.0425827 -0.0225751 -0.0474" rpy="-3.14159 0 3.14159"/>
      <geometry>
        <mesh filename="package://assets/distal_soft_tip.stl"/>
      </geometry>
      <material name="distal_soft_tip_material">
        <color rgba="0.301961 0.301961 0.301961 1"/>
      </material>
    </visual>
    <collision>
      <origin xyz="0.0425827 -0.0225751 -0.0474" rpy="-3.14159 0 3.14159"/>
      <geometry>
        <mesh filename="package://assets/distal_soft_tip.stl"/>
      </geometry>
    </collision>
    <!-- Part std00333_plast_tcb_torx_2_5x8__configuration_copy_of_default_21 -->
    <visual>
      <origin xyz="-0.0114064 0.0331157 -0.0422" rpy="-1.5708 -0 -2.58624"/>
      <geometry>
        <mesh filename="package://assets/std00333_plast_tcb_torx_2_5x8__configuration_copy_of_default.stl"/>
      </geometry>
      <material name="std00333_plast_tcb_torx_2_5x8__configuration_copy_of_default_21_material">
        <color rgba="0.901961 0.901961 0.901961 1"/>
      </material>
    </visual>
    <collision>
      <origin xyz="-0.0114064 0.0331157 -0.0422" rpy="-1.5708 -0 -2.58624"/>
      <geometry>
        <mesh filename="package://assets/std00333_plast_tcb_torx_2_5x8__configuration_copy_of_default.stl"/>
      </geometry>
    </collision>
    <!-- Part std00333_plast_tcb_torx_2_5x8__configuration_copy_of_default_22 -->
    <visual>
      <origin xyz="-0.0114064 0.0331157 -0.0042" rpy="-1.5708 -0 -2.58624"/>
      <geometry>
        <mesh filename="package://assets/std00333_plast_tcb_torx_2_5x8__configuration_copy_of_default.stl"/>
      </geometry>
      <material name="std00333_plast_tcb_torx_2_5x8__configuration_copy_of_default_22_material">
        <color rgba="0.901961 0.901961 0.901961 1"/>
      </material>
    </visual>
    <collision>
      <origin xyz="-0.0114064 0.0331157 -0.0042" rpy="-1.5708 -0 -2.58624"/>
      <geometry>
        <mesh filename="package://assets/std00333_plast_tcb_torx_2_5x8__configuration_copy_of_default.stl"/>
      </geometry>
    </collision>
    <!-- Part plain_washer_large_grade_a_m2_5__9a369f0dc77bf9c598cdf3fb468977e5_2 -->
    <visual>
      <origin xyz="0 0 -0.0509" rpy="3.14159 -0 -0"/>
      <geometry>
        <mesh filename="package://assets/plain_washer_large_grade_a_m2_5__9a369f0dc77bf9c598cdf3fb468977e5.stl"/>
      </geometry>
      <material name="plain_washer_large_grade_a_m2_5__9a369f0dc77bf9c598cdf3fb468977e5_2_material">
        <color rgba="0.603922 0.647059 0.686275 1"/>
      </material>
    </visual>
    <collision>
      <origin xyz="0 0 -0.0509" rpy="3.14159 -0 -0"/>
      <geometry>
        <mesh filename="package://assets/plain_washer_large_grade_a_m2_5__9a369f0dc77bf9c598cdf3fb468977e5.stl"/>
      </geometry>
    </collision>
  </link>
  <!-- Frame finger_tip (dummy link + fixed joint) -->
  <link name="finger_tip">
    <origin xyz="0 0 0" rpy="0 -0 0"/>
    <inertial>
      <origin xyz="0 0 0" rpy="0 0 0"/>
      <mass value="1e-9"/>
      <inertia ixx="0" ixy="0" ixz="0" iyy="0" iyz="0" izz="0"/>
    </inertial>
  </link>
  <joint name="finger_tip_frame" type="fixed">
    <origin xyz="-0.0243384 0.0565209 -0.0232" rpy="-1.5708 -0 -0.643367"/>
    <parent link="distal_l"/>
    <child link="finger_tip"/>
    <axis xyz="0 0 0"/>
  </joint>
  <!-- Joint from proximal_bend_l to distal_l -->
  <joint name="distal" type="revolute">
    <origin xyz="0.0321391 0.0383025 -0" rpy="3.14159 -0 -3.14159"/>
    <parent link="proximal_bend_l"/>
    <child link="distal_l"/>
    <axis xyz="0 0 1"/>
    <limit effort="10" velocity="10" lower="-1.5708" upper="0"/>
  </joint>
  <!-- Joint from grip_l to proximal_bend_l -->
  <joint name="proximal" type="revolute">
    <origin xyz="-0 0 -0" rpy="-3.14159 0 3.14159"/>
    <parent link="grip_l"/>
    <child link="proximal_bend_l"/>
    <axis xyz="0 0 1"/>
    <limit effort="10" velocity="10" lower="-0" upper="1.5708"/>
  </joint>
</robot>
