pollen-robotics/grabette/packages/grabette/urdf/grabette_right/robot.urdf

<?xml version="1.0" ?>
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
<robot name="grabette_right">
  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
  <link name="grip_r">
    <inertial>
      <origin xyz="-0.0240018 -0.0287977 -0.0275815" rpy="0 0 0"/>
      <mass value="0.256238"/>
      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
    </inertial>
    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
  </link>
  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
  <link name="camera">
    <origin xyz="0 0 0" rpy="0 -0 0"/>
    <inertial>
      <origin xyz="0 0 0" rpy="0 0 0"/>
      <mass value="1e-9"/>
      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
    </inertial>
  </link>
  <joint name="camera_frame" type="fixed">
    <origin xyz="-0.0408486 -0.0255417 0.0701847" rpy="-1.91986 0 0"/>
    <parent link="grip_r"/>
    <child link="camera"/>
    <axis xyz="0 0 0"/>
  </joint>
  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
  <link name="oak_l">
    <origin xyz="0 0 0" rpy="0 -0 0"/>
    <inertial>
      <origin xyz="0 0 0" rpy="0 0 0"/>
      <mass value="1e-9"/>
      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
    </inertial>
  </link>
  <joint name="oak_l_frame" type="fixed">
    <origin xyz="-0.0373486 -0.025667 0.0298246" rpy="-1.5708 0 0"/>
    <parent link="grip_r"/>
    <child link="oak_l"/>
    <axis xyz="0 0 0"/>
  </joint>
  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
  <link name="oak_r">
    <origin xyz="0 0 0" rpy="0 -0 0"/>
    <inertial>
      <origin xyz="0 0 0" rpy="0 0 0"/>
      <mass value="1e-9"/>
      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
    </inertial>
  </link>
  <joint name="oak_r_frame" type="fixed">
    <origin xyz="-0.0173486 -0.025667 0.0298246" rpy="-1.5708 0 0"/>
    <parent link="grip_r"/>
    <child link="oak_r"/>
    <axis xyz="0 0 0"/>
  </joint>
  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
  <link name="gripper_center">
    <origin xyz="0 0 0" rpy="0 -0 0"/>
    <inertial>
      <origin xyz="0 0 0" rpy="0 0 0"/>
      <mass value="1e-9"/>
      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
    </inertial>
  </link>
  <joint name="gripper_center_frame" type="fixed">
    <origin xyz="-0.0373485 0.0335873 -0.0232" rpy="0 -0 1.5708"/>
    <parent link="grip_r"/>
    <child link="gripper_center"/>
    <axis xyz="0 0 0"/>
  </joint>
  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
  <link name="gripper_base">
    <origin xyz="0 0 0" rpy="0 -0 0"/>
    <inertial>
      <origin xyz="0 0 0" rpy="0 0 0"/>
      <mass value="1e-9"/>
      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
    </inertial>
  </link>
  <joint name="gripper_base_frame" type="fixed">
    <origin xyz="-0.0337996 -0.055 -0.0232" rpy="1.5708 -0 0"/>
    <parent link="grip_r"/>
    <child link="gripper_base"/>
    <axis xyz="0 0 0"/>
  </joint>
  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
  <link name="thumb_tip">
    <origin xyz="0 0 0" rpy="0 -0 0"/>
    <inertial>
      <origin xyz="0 0 0" rpy="0 0 0"/>
      <mass value="1e-9"/>
      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
    </inertial>
  </link>
  <joint name="thumb_tip_frame" type="fixed">
    <origin xyz="-0.0910992 0.0551614 -0.0232" rpy="-1.5708 -0 -0.799448"/>
    <parent link="grip_r"/>
    <child link="thumb_tip"/>
    <axis xyz="0 0 0"/>
  </joint>
  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
  <link name="proximal_bend_r">
    <inertial>
      <origin xyz="-0.0195347 0.0138995 0.0280594" rpy="0 0 0"/>
      <mass value="0.0318375"/>
      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
    </inertial>
    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
  </link>
  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
  <link name="distal_r">
    <inertial>
      <origin xyz="0.0105389 0.0192286 -0.0235252" rpy="0 0 0"/>
      <mass value="0.0252381"/>
      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
    </inertial>
    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
  </link>
  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
  <link name="finger_tip">
    <origin xyz="0 0 0" rpy="0 -0 0"/>
    <inertial>
      <origin xyz="0 0 0" rpy="0 0 0"/>
      <mass value="1e-9"/>
      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
    </inertial>
  </link>
  <joint name="finger_tip_frame" type="fixed">
    <origin xyz="0.0243384 0.0565209 -0.0232" rpy="-1.5708 0 0.643367"/>
    <parent link="distal_r"/>
    <child link="finger_tip"/>
    <axis xyz="0 0 0"/>
  </joint>
  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
  <joint name="distal" type="revolute">
    <origin xyz="-0.0321391 0.0383025 0" rpy="-3.14159 -0 3.14159"/>
    <parent link="proximal_bend_r"/>
    <child link="distal_r"/>
    <axis xyz="0 0 1"/>
    <limit effort="10" velocity="10" lower="0" upper="1.5708"/>
  </joint>
  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
  <joint name="proximal" type="revolute">
    <origin xyz="0 -0 -0" rpy="3.14159 0 3.14159"/>
    <parent link="grip_r"/>
    <child link="proximal_bend_r"/>
    <axis xyz="0 0 1"/>
    <limit effort="10" velocity="10" lower="-1.5708" upper="0"/>
  </joint>
</robot>
