pollen-robotics/grabette/packages/grabette/urdf/grabette_right/robot.xml

<?xml version="1.0" ?>
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
<mujoco model="grabette_right">
  <compiler angle="radian" meshdir="assets" autolimits="true"/>
  <default>
    <default class="grabette_right">
      <joint frictionloss="0.1" armature="0.005"/>
      <position kp="50" dampratio="1"/>
      <default class="visual">
        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
      </default>
      <default class="collision">
        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
      </default>
    </default>
  </default>
  <worldbody>
    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
    <body name="grip_r" pos="0 0 0" quat="1 0 0 0" childclass="grabette_right">
      <freejoint name="grip_r_freejoint"/>
      <inertial pos="-0.0240018 -0.0287977 -0.0275815" mass="0.256238" fullinertia="0.00078102 0.00108374 0.000579012 0.000113596 0.000175966 8.28982e-06"/>
      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
      <body name="proximal_bend_r" pos="0 -0 -0" quat="0 0 1 0">
        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
        <joint axis="0 0 1" name="proximal" type="hinge" range="-1.5707963267948966 0.0"/>
        <inertial pos="-0.0195347 0.0138995 0.0280594" mass="0.0318375" fullinertia="5.37694e-05 4.9433e-05 1.33557e-05 2.28134e-06 1.46204e-06 6.35764e-06"/>
        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
        <body name="distal_r" pos="-0.0321391 0.0383025 0" quat="0 0 1 -0">
          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
          <joint axis="0 0 1" name="distal" type="hinge" range="0.0 1.5707963267948966"/>
          <inertial pos="0.0105389 0.0192286 -0.0235252" mass="0.0252381" fullinertia="1.16475e-05 8.65045e-06 7.40635e-06 -1.26994e-06 -8.7344e-08 -1.59146e-07"/>
          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
        </body>
      </body>
    </body>
  </worldbody>
  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
  <actuator>
    <position class="grabette_right" name="proximal" joint="proximal" inheritrange="1"/>
    <position class="grabette_right" name="distal" joint="distal" inheritrange="1"/>
  </actuator>
  <equality/>
</mujoco>
