pollen-robotics/grabette/packages/gripette/urdf/gripette_left/robot.xml

<?xml version="1.0" ?>
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
<mujoco model="gripette_left">
  <compiler angle="radian" meshdir="assets" autolimits="true"/>
  <default>
    <default class="gripette_left">
      <joint frictionloss="0.1" armature="0.005"/>
      <position kp="50" dampratio="1"/>
      <default class="visual">
        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
      </default>
      <default class="collision">
        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
      </default>
    </default>
  </default>
  <worldbody>
    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
    <body name="gripper_base_l" pos="0 0 0" quat="1 0 0 0" childclass="gripette_left">
      <freejoint name="gripper_base_l_freejoint"/>
      <inertial pos="0.0302537 -0.0209 -0.00633402" mass="0.227305" fullinertia="0.000403434 0.000539645 0.000379522 -3.41978e-05 -2.59299e-05 7.53632e-05"/>
      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
      <body name="proximal_bot_l" pos="0 0 -0.04225" quat="0.707107 -0 -0 -0.707107">
        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
        <joint axis="0 0 1" name="proximal" type="hinge" range="-1.5707963267948948 1.7763568394002505e-15"/>
        <inertial pos="-0.0238219 -0.0233283 0.0203821" mass="0.0888242" fullinertia="4.32416e-05 5.12465e-05 3.54147e-05 -9.64446e-06 -7.64551e-07 -9.95402e-07"/>
        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
        <body name="distal_l" pos="-0.0383025 -0.0321391 -0.0001" quat="0.970296 -0 0 0.241922">
          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
          <joint axis="0 0 1" name="distal" type="hinge" range="-1.5707963267948966 0.0"/>
          <inertial pos="-0.0238587 0.000329333 0.019056" mass="0.0238665" fullinertia="7.50823e-06 1.03054e-05 6.05718e-06 2.56739e-07 -1.342e-09 2.36e-10"/>
          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
        </body>
      </body>
    </body>
  </worldbody>
  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
  <actuator>
    <position class="gripette_left" name="proximal" joint="proximal" inheritrange="1"/>
    <position class="gripette_left" name="distal" joint="distal" inheritrange="1"/>
  </actuator>
  <equality/>
</mujoco>
