pollen-robotics/grabette/packages/gripette/urdf/gripette_right/robot.xml

<?xml version="1.0" ?>
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
<mujoco model="gripette_right">
  <compiler angle="radian" meshdir="assets" autolimits="true"/>
  <default>
    <default class="gripette_right">
      <joint frictionloss="0.1" armature="0.005"/>
      <position kp="50" dampratio="1"/>
      <default class="visual">
        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
      </default>
      <default class="collision">
        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
      </default>
    </default>
  </default>
  <worldbody>
    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
    <body name="gripper_base_r" pos="0 0 0" quat="1 0 0 0" childclass="gripette_right">
      <freejoint name="gripper_base_r_freejoint"/>
      <inertial pos="-0.0302536 -0.0208987 -0.00633466" mass="0.227294" fullinertia="0.000403409 0.000539617 0.000379489 3.44239e-05 2.59208e-05 7.53636e-05"/>
      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
      <body name="proximal_bot_r" pos="0 0 -0.04225" quat="0.707107 0 -0 -0.707107">
        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
        <joint axis="0 0 1" name="proximal" type="hinge" range="0.0 1.5707963267948966"/>
        <inertial pos="-0.0253697 0.0243883 0.0242046" mass="0.0769363" fullinertia="3.19064e-05 3.84967e-05 2.83826e-05 7.34138e-06 -4.06564e-06 3.31711e-06"/>
        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
        <body name="distal_r" pos="-0.0383025 0.0321391 -0.0001" quat="0.970296 -0 -0 -0.241922">
          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
          <joint axis="0 0 1" name="distal" type="hinge" range="-9.769962616701378e-15 1.570796326794887"/>
          <inertial pos="-0.0238598 -0.000329979 0.0190584" mass="0.0238623" fullinertia="7.50665e-06 1.03037e-05 6.05691e-06 -2.56698e-07 -2.063e-09 -3.57e-10"/>
          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
        </body>
      </body>
    </body>
    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
    <body name="distal_cable_r" pos="0 0 0" quat="1 0 0 0" childclass="gripette_right">
      <freejoint name="distal_cable_r_freejoint"/>
      <inertial pos="0 0 0" mass="1e-09" fullinertia="1e-09 1e-09 1e-09 0 0 0"/>
    </body>
  </worldbody>
  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
  <actuator>
    <position class="gripette_right" name="proximal" joint="proximal" inheritrange="1"/>
    <position class="gripette_right" name="distal" joint="distal" inheritrange="1"/>
  </actuator>
  <equality/>
</mujoco>
