pollen-robotics/grabette/packages/gripette/urdf/openarm_gripette_right/robot.urdf

<?xml version="1.0" ?>
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
<robot name="openarm_gripette_right">
  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
  <link name="hfsb6_6060_750_1_step">
    <inertial>
      <origin xyz="0 0 0" rpy="0 0 0"/>
      <mass value="1e-09"/>
      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
    </inertial>
    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
  </link>
  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
  <link name="dm_j8009p_2_step_1">
    <inertial>
      <origin xyz="0 0 0" rpy="0 0 0"/>
      <mass value="1e-09"/>
      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
    </inertial>
    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
  </link>
  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
  <link name="j2_b_2_step">
    <inertial>
      <origin xyz="0 0 0" rpy="0 0 0"/>
      <mass value="1e-09"/>
      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
    </inertial>
    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
  </link>
  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
  <link name="dm_j4340_2_step">
    <inertial>
      <origin xyz="0 0 0" rpy="0 0 0"/>
      <mass value="1e-09"/>
      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
    </inertial>
    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
  </link>
  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
  <link name="dm_j4310_1_2_step">
    <inertial>
      <origin xyz="0 0 0" rpy="0 0 0"/>
      <mass value="1e-09"/>
      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
    </inertial>
    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
  </link>
  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
  <link name="j6_a_3_step">
    <inertial>
      <origin xyz="0 0 0" rpy="0 0 0"/>
      <mass value="1e-09"/>
      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
    </inertial>
    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
  </link>
  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
  <link name="j7_e_2_step">
    <inertial>
      <origin xyz="0 0 0" rpy="0 0 0"/>
      <mass value="1e-09"/>
      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
    </inertial>
    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
  </link>
  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
  <joint name="r_wrist_roll" type="revolute">
    <origin xyz="0.0172 -0 0.0455" rpy="1.5708 0.00215838 -1.5708"/>
    <parent link="j6_a_3_step"/>
    <child link="j7_e_2_step"/>
    <axis xyz="0 0 1"/>
    <limit effort="10" velocity="10" lower="-0.78324" upper="0.787556"/>
  </joint>
  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
  <link name="dm_j4310_1_2_step_2">
    <inertial>
      <origin xyz="0 0 0" rpy="0 0 0"/>
      <mass value="1e-09"/>
      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
    </inertial>
    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
  </link>
  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
  <link name="j8_a_2_step">
    <inertial>
      <origin xyz="0.0168653 -0.0836013 -0.0169536" rpy="0 0 0"/>
      <mass value="0.227294"/>
      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
    </inertial>
    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
  </link>
  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
  <link name="camera">
    <origin xyz="0 0 0" rpy="0 -0 0"/>
    <inertial>
      <origin xyz="0 0 0" rpy="0 0 0"/>
      <mass value="1e-9"/>
      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
    </inertial>
  </link>
  <joint name="camera_frame" type="fixed">
    <origin xyz="0.0933847 -0.0789583 -0.0275486" rpy="1.22173 -1.5708 0"/>
    <parent link="j8_a_2_step"/>
    <child link="camera"/>
    <axis xyz="0 0 0"/>
  </joint>
  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
  <link name="gripper_base">
    <origin xyz="0 0 0" rpy="0 -0 0"/>
    <inertial>
      <origin xyz="0 0 0" rpy="0 0 0"/>
      <mass value="1e-9"/>
      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
    </inertial>
  </link>
  <joint name="gripper_base_frame" type="fixed">
    <origin xyz="-0 -0.0495 -0.0205" rpy="-1.5708 -1.5708 0"/>
    <parent link="j8_a_2_step"/>
    <child link="gripper_base"/>
    <axis xyz="0 0 0"/>
  </joint>
  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
  <link name="oak_l">
    <origin xyz="0 0 0" rpy="0 -0 0"/>
    <inertial>
      <origin xyz="0 0 0" rpy="0 0 0"/>
      <mass value="1e-9"/>
      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
    </inertial>
  </link>
  <joint name="oak_l_frame" type="fixed">
    <origin xyz="0.0530246 -0.078833 -0.0240486" rpy="1.5708 -1.5708 0"/>
    <parent link="j8_a_2_step"/>
    <child link="oak_l"/>
    <axis xyz="0 0 0"/>
  </joint>
  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
  <link name="oak_r">
    <origin xyz="0 0 0" rpy="0 -0 0"/>
    <inertial>
      <origin xyz="0 0 0" rpy="0 0 0"/>
      <mass value="1e-9"/>
      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
    </inertial>
  </link>
  <joint name="oak_r_frame" type="fixed">
    <origin xyz="0.0530246 -0.078833 -0.00404864" rpy="1.5708 -1.5708 0"/>
    <parent link="j8_a_2_step"/>
    <child link="oak_r"/>
    <axis xyz="0 0 0"/>
  </joint>
  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
  <link name="gripper_center">
    <origin xyz="0 0 0" rpy="0 -0 0"/>
    <inertial>
      <origin xyz="0 0 0" rpy="0 0 0"/>
      <mass value="1e-9"/>
      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
    </inertial>
  </link>
  <joint name="gripper_center_frame" type="fixed">
    <origin xyz="-0 -0.138087 -0.0240485" rpy="-1.5708 0 -1.5708"/>
    <parent link="j8_a_2_step"/>
    <child link="gripper_center"/>
    <axis xyz="0 0 0"/>
  </joint>
  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
  <link name="thumb_tip">
    <origin xyz="0 0 0" rpy="0 -0 0"/>
    <inertial>
      <origin xyz="0 0 0" rpy="0 0 0"/>
      <mass value="1e-9"/>
      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
    </inertial>
  </link>
  <joint name="thumb_tip_frame" type="fixed">
    <origin xyz="-0 -0.159661 -0.0777992" rpy="0 -0.771348 1.5708"/>
    <parent link="j8_a_2_step"/>
    <child link="thumb_tip"/>
    <axis xyz="0 0 0"/>
  </joint>
  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
  <link name="feetech_sts3215__configuration_default">
    <inertial>
      <origin xyz="-0.0253697 0.0243883 0.0242046" rpy="0 0 0"/>
      <mass value="0.0769363"/>
      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
    </inertial>
    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
  </link>
  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
  <link name="distal_soft_tip">
    <inertial>
      <origin xyz="-0.0238598 -0.000329979 0.0190584" rpy="0 0 0"/>
      <mass value="0.0238623"/>
      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
    </inertial>
    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
  </link>
  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
  <link name="finger_tip">
    <origin xyz="0 0 0" rpy="0 -0 0"/>
    <inertial>
      <origin xyz="0 0 0" rpy="0 0 0"/>
      <mass value="1e-9"/>
      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
    </inertial>
  </link>
  <joint name="finger_tip_frame" type="fixed">
    <origin xyz="-0.0613312 -0.00504543 0.01905" rpy="-1.5708 -0 2.70286"/>
    <parent link="distal_soft_tip"/>
    <child link="finger_tip"/>
    <axis xyz="0 0 0"/>
  </joint>
  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
  <joint name="distal" type="revolute">
    <origin xyz="-0.0383025 0.0321391 -0.0001" rpy="-0 0 -0.488692"/>
    <parent link="feetech_sts3215__configuration_default"/>
    <child link="distal_soft_tip"/>
    <axis xyz="0 0 1"/>
    <limit effort="10" velocity="10" lower="0" upper="1.5708"/>
  </joint>
  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
  <joint name="proximal" type="revolute">
    <origin xyz="-0.01905 -0.1045 0.0133" rpy="1.5708 -0 1.5708"/>
    <parent link="j8_a_2_step"/>
    <child link="feetech_sts3215__configuration_default"/>
    <axis xyz="0 0 1"/>
    <limit effort="10" velocity="10" lower="0" upper="1.5708"/>
  </joint>
  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
  <joint name="r_wrist_pitch" type="revolute">
    <origin xyz="0.0205 0 -0.0343" rpy="1.5708 -1.56452 1.5708"/>
    <parent link="dm_j4310_1_2_step_2"/>
    <child link="j8_a_2_step"/>
    <axis xyz="0 0 1"/>
    <limit effort="10" velocity="10" lower="-1.56452" upper="1.57707"/>
  </joint>
  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
  <joint name="r_wrist_roll_mimic" type="revolute">
    <origin xyz="0.0343 -0 0.1205" rpy="1.5708 -0.00215838 1.5708"/>
    <parent link="j6_a_3_step"/>
    <child link="dm_j4310_1_2_step_2"/>
    <axis xyz="0 0 1"/>
    <limit effort="10" velocity="10" lower="-3.141592653589793" upper="3.141592653589793"/>
    <mimic joint="r_wrist_roll" multiplier="-1.0"/>
  </joint>
  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
  <joint name="r_wrist_yaw" type="revolute">
    <origin xyz="-0 -0.0955 -0.0315" rpy="1.5708 0 -0"/>
    <parent link="dm_j4310_1_2_step"/>
    <child link="j6_a_3_step"/>
    <axis xyz="0 0 1"/>
    <limit effort="10" velocity="10" lower="-1.5708" upper="1.5708"/>
  </joint>
  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
  <joint name="r_elbow" type="revolute">
    <origin xyz="0 0.03155 0.15375" rpy="-1.5708 0 0"/>
    <parent link="dm_j4340_2_step"/>
    <child link="dm_j4310_1_2_step"/>
    <axis xyz="0 0 1"/>
    <limit effort="10" velocity="10" lower="0" upper="2.44346"/>
  </joint>
  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
  <joint name="r_arm_yaw" type="revolute">
    <origin xyz="-0 0.06625 -0.0301" rpy="-1.5708 1.5708 0"/>
    <parent link="j2_b_2_step"/>
    <child link="dm_j4340_2_step"/>
    <axis xyz="0 0 1"/>
    <limit effort="10" velocity="10" lower="-1.5708" upper="1.5708"/>
  </joint>
  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
  <joint name="r_arm_roll" type="revolute">
    <origin xyz="-0.0301 -0 0.06" rpy="-3.14159 1.5708 0"/>
    <parent link="dm_j8009p_2_step_1"/>
    <child link="j2_b_2_step"/>
    <axis xyz="0 0 1"/>
    <limit effort="10" velocity="10" lower="-1.74533" upper="1.74533"/>
  </joint>
  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
  <joint name="r_arm_pitch" type="revolute">
    <origin xyz="-0 -0.0925 0.689" rpy="1.5708 0 -0"/>
    <parent link="hfsb6_6060_750_1_step"/>
    <child link="dm_j8009p_2_step_1"/>
    <axis xyz="0 0 1"/>
    <limit effort="10" velocity="10" lower="-1.39626" upper="3.49066"/>
  </joint>
</robot>
