pollen-robotics/grabette/packages/gripette/urdf/openarm_gripette_right/robot.xml

<?xml version="1.0" ?>
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
<mujoco model="openarm_gripette_right">
  <compiler angle="radian" meshdir="assets" autolimits="true"/>
  <default>
    <default class="openarm_gripette_right">
      <joint frictionloss="0.1" armature="0.005"/>
      <position kp="50" dampratio="1"/>
      <default class="visual">
        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
      </default>
      <default class="collision">
        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
      </default>
    </default>
  </default>
  <worldbody>
    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
    <body name="hfsb6_6060_750_1_step" pos="0 0 0" quat="1 0 0 0" childclass="openarm_gripette_right">
      <inertial pos="0 0 0" mass="1e-09" fullinertia="1e-09 1e-09 1e-09 0 0 0"/>
      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
      <body name="dm_j8009p_2_step_1" pos="-0 -0.0925 0.689" quat="0.707107 0.707107 -0 -0">
        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
        <joint axis="0 0 1" name="r_arm_pitch" type="hinge" range="-1.3962634015954636 3.490658503988659"/>
        <inertial pos="0 0 0" mass="1e-09" fullinertia="1e-09 1e-09 1e-09 0 0 0"/>
        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
        <body name="j2_b_2_step" pos="-0.0301 -0 0.06" quat="0 0.707107 -0 -0.707107">
          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
          <joint axis="0 0 1" name="r_arm_roll" type="hinge" range="-1.7453292519943278 1.7453292519943313"/>
          <inertial pos="0 0 0" mass="1e-09" fullinertia="1e-09 1e-09 1e-09 0 0 0"/>
          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
          <body name="dm_j4340_2_step" pos="-0 0.06625 -0.0301" quat="0.5 -0.5 0.5 0.5">
            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
            <joint axis="0 0 1" name="r_arm_yaw" type="hinge" range="-1.5707963267948957 1.5707963267948974"/>
            <inertial pos="0 0 0" mass="1e-09" fullinertia="1e-09 1e-09 1e-09 0 0 0"/>
            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
            <body name="dm_j4310_1_2_step" pos="0 0.03155 0.15375" quat="0.707107 -0.707107 0 0">
              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
              <joint axis="0 0 1" name="r_elbow" type="hinge" range="0.0 2.443460952792061"/>
              <inertial pos="0 0 0" mass="1e-09" fullinertia="1e-09 1e-09 1e-09 0 0 0"/>
              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
              <body name="j6_a_3_step" pos="-0 -0.0955 -0.0315" quat="0.707107 0.707107 -0 -0">
                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
                <joint axis="0 0 1" name="r_wrist_yaw" type="hinge" range="-1.570796326794886 1.5707963267949072"/>
                <inertial pos="0 0 0" mass="1e-09" fullinertia="1e-09 1e-09 1e-09 0 0 0"/>
                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
                <body name="j7_e_2_step" pos="0.0172 -0 0.0455" quat="0.49946 0.500539 -0.49946 -0.500539">
                  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
                  <joint axis="0 0 1" name="r_wrist_roll" type="hinge" range="-0.7832396212099086 0.7875563787900914"/>
                  <inertial pos="0 0 0" mass="1e-09" fullinertia="1e-09 1e-09 1e-09 0 0 0"/>
                  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
                </body>
                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
                <body name="dm_j4310_1_2_step_2" pos="0.0343 -0 0.1205" quat="0.49946 0.500539 0.49946 0.500539">
                  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
                  <joint axis="0 0 1" name="r_wrist_roll_mimic" type="hinge"/>
                  <inertial pos="0 0 0" mass="1e-09" fullinertia="1e-09 1e-09 1e-09 0 0 0"/>
                  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
                  <body name="j8_a_2_step" pos="0.0205 0 -0.0343" quat="0.00221726 0.707103 0.00221726 0.707103">
                    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
                    <joint axis="0 0 1" name="r_wrist_pitch" type="hinge" range="-1.5645249569847266 1.5770676966050665"/>
                    <inertial pos="0.0168653 -0.0836013 -0.0169536" mass="0.227294" fullinertia="0.000379489 0.000539617 0.000403409 -7.53636e-05 2.59208e-05 -3.44239e-05"/>
                    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
                    <body name="feetech_sts3215__configuration_default" pos="-0.01905 -0.1045 0.0133" quat="0.5 0.5 0.5 0.5">
                      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
                      <joint axis="0 0 1" name="proximal" type="hinge" range="0.0 1.5707963267948966"/>
                      <inertial pos="-0.0253697 0.0243883 0.0242046" mass="0.0769363" fullinertia="3.19064e-05 3.84967e-05 2.83826e-05 7.34138e-06 -4.06564e-06 3.31711e-06"/>
                      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
                      <body name="distal_soft_tip" pos="-0.0383025 0.0321391 -0.0001" quat="0.970296 0 0 -0.241922">
                        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
                        <joint axis="0 0 1" name="distal" type="hinge" range="0.0 1.5707963267948968"/>
                        <inertial pos="-0.0238598 -0.000329979 0.0190584" mass="0.0238623" fullinertia="7.50665e-06 1.03037e-05 6.05691e-06 -2.56698e-07 -2.063e-09 -3.57e-10"/>
                        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
                      </body>
                    </body>
                  </body>
                </body>
              </body>
            </body>
          </body>
        </body>
      </body>
    </body>
  </worldbody>
  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
  <actuator>
    <position class="openarm_gripette_right" name="r_arm_pitch" joint="r_arm_pitch" inheritrange="1"/>
    <position class="openarm_gripette_right" name="r_arm_roll" joint="r_arm_roll" inheritrange="1"/>
    <position class="openarm_gripette_right" name="r_arm_yaw" joint="r_arm_yaw" inheritrange="1"/>
    <position class="openarm_gripette_right" name="r_elbow" joint="r_elbow" inheritrange="1"/>
    <position class="openarm_gripette_right" name="r_wrist_yaw" joint="r_wrist_yaw" inheritrange="1"/>
    <position class="openarm_gripette_right" name="r_wrist_roll" joint="r_wrist_roll" inheritrange="1"/>
    <position class="openarm_gripette_right" name="r_wrist_pitch" joint="r_wrist_pitch" inheritrange="1"/>
    <position class="openarm_gripette_right" name="proximal" joint="proximal" inheritrange="1"/>
    <position class="openarm_gripette_right" name="distal" joint="distal" inheritrange="1"/>
  </actuator>
  <equality>
    <joint joint1="r_wrist_roll_mimic" joint2="r_wrist_roll" polycoef="0 -1.0 0 0 0"/>
  </equality>
</mujoco>
