pollen-robotics/grabette/integrations/openarm/openarm_gripette/openarm_gripette/openarm7_follower.py

#!/usr/bin/env python

# Copyright 2025 The HuggingFace Inc. team. All rights reserved.
#
# Licensed under the Apache License, Version 2.0 (the "License");
# you may not use this file except in compliance with the License.
# You may obtain a copy of the License at
#
#     http://www.apache.org/licenses/LICENSE-2.0
#
# Unless required by applicable law or agreed to in writing, software
# distributed under the License is distributed on an "AS IS" BASIS,
# WITHOUT WARRANTIES OR CONDITIONS OF ANY KIND, either express or implied.
# See the License for the specific language governing permissions and
# limitations under the License.

"""7-DOF OpenArm follower (arm only, no gripper on CAN).

Use when the gripper is controlled via a separate interface (e.g. the Gripette
has its own gRPC service). Inherits from `OpenArmFollower` and overrides only
what's necessary: `send_action` uses a dynamic motor-index built from
`config.motor_config.keys()` so the kp/kd gain lookup works with any number of
motors (7 here vs. 8 for the standard OpenArm).
"""

import logging
from functools import cached_property

from lerobot.types import RobotAction, RobotObservation
from lerobot.utils import check_if_already_connected, check_if_not_connected

from lerobot.robots.openarm_follower import OpenArmFollower
from lerobot.robots.utils import ensure_safe_goal_position
from .config_openarm7_follower import (
    LEFT_DEFAULT_JOINTS_LIMITS,
    RIGHT_DEFAULT_JOINTS_LIMITS,
    OpenArm7FollowerConfig,
)

logger = logging.getLogger(__name__)


class OpenArm7Follower(OpenArmFollower):
    """OpenArm follower with 7 arm joints only (no gripper on CAN)."""

    config_class = OpenArm7FollowerConfig
    name = "openarm7_follower"

    def __init__(self, config: OpenArm7FollowerConfig):
        # Apply Gripette-7-specific side defaults before the base class would
        # apply the standard OpenArm defaults (which include a 'gripper' slot).
        if config.side == "left":
            config.joint_limits = LEFT_DEFAULT_JOINTS_LIMITS
        elif config.side == "right":
            config.joint_limits = RIGHT_DEFAULT_JOINTS_LIMITS
        # Prevent the parent __init__ from overwriting our joint_limits with
        # the standard 8-motor defaults.
        original_side = config.side
        config.side = None
        super().__init__(config)
        config.side = original_side

    @cached_property
    def action_features(self) -> dict[str, type]:
        """Position-only action schema expected by the teleoperator and bus.

        LeRobot 0.6 uses ``use_velocity_and_torque`` for the upstream
        ``_motors_ft`` map shared by observations and actions. We keep those
        channels in observations for dataset compatibility, but neither the
        teleoperator nor ``send_action`` produces velocity/torque commands.
        Advertising them here makes ``lerobot-record`` index missing action
        keys. Keep the command surface aligned with what is actually sent.
        """
        return {f"{motor}.pos": float for motor in self.bus.motors}

    # -- Calibration bypass -------------------------------------------------
    # OpenArm motor zeros live in the Damiao motor firmware (set externally
    # via OpenArm's official calibration tool). The Damiao bus never reads
    # the LeRobot calibration fields (homing_offset / drive_mode / range_*),
    # so LeRobot's file-based calibration is purely vestigial for this arm.
    # We bypass it entirely to avoid prompts and accidental zero overwrites.

    @check_if_already_connected
    def connect(self, calibrate: bool = True) -> None:
        """Connect WITHOUT re-zeroing the motors.

        Upstream `OpenArmFollower.connect` calls `bus.set_zero_position()` on
        every connect when `is_calibrated` is True (their convention: zero =
        the hanging rest pose the arm is assumed to be in at startup). Our
        zeros are the OpenArm official firmware calibration and must survive
        restarts — re-zeroing at the current pose silently DESTROYS the
        calibration whenever the server starts with the arm away from the
        calibration pose (e.g. after a torque-off fall).

        Identical to the upstream method otherwise (bus + cameras + configure
        + enable torque); LeRobot calibration is skipped per the bypass above.
        """
        logger.info(f"Connecting arm on {self.config.port} (firmware zeros preserved)...")
        self.bus.connect()
        for cam in self.cameras.values():
            cam.connect()
        self.configure()
        self.bus.enable_torque()
        logger.info(f"{self} connected.")

    @property
    def is_calibrated(self) -> bool:
        return True

    def calibrate(self) -> None:
        logger.info(
            "LeRobot calibration is disabled for OpenArm7Follower. "
            "Motor zeros are stored in firmware — use OpenArm's calibration tool "
            "to (re)set them. No calibration file will be read or written."
        )

    def _joint_sign(self, motor_name: str) -> float:
        """Per-joint sign multiplier (+1 = no flip, -1 = flip direction).

        Applied symmetrically to both `get_observation` (encoder → URDF) and
        `send_action` (URDF → motor) so the round-trip stays consistent.
        Defaults to +1 if `joint_signs` isn't configured.
        """
        signs = getattr(self.config, "joint_signs", None) or {}
        return float(signs.get(motor_name, 1.0))

    @check_if_not_connected
    def get_observation(self) -> RobotObservation:
        """Same observation as the base class, then multiply each joint
        position by `joint_signs[motor_name]` so motors with reversed wiring
        appear in the URDF convention upstream.
        """
        obs = super().get_observation()
        # Position, its derivative, and generalized torque all change sign
        # when mapping a reversed motor coordinate into the URDF coordinate.
        for key in list(obs.keys()):
            motor, separator, quantity = key.rpartition(".")
            if separator and quantity in {"pos", "vel", "torque"}:
                sign = self._joint_sign(motor)
                if sign != 1.0:
                    obs[key] = obs[key] * sign
        return obs

    @check_if_not_connected
    def send_action(
        self,
        action: RobotAction,
        custom_kp: dict[str, float] | None = None,
        custom_kd: dict[str, float] | None = None,
    ) -> RobotAction:
        """Send joint position commands over CAN using MIT control.

        Same as OpenArmFollower.send_action, but builds motor_index dynamically
        from config.motor_config so it matches any motor count.

        Also flips each joint's commanded angle by `config.joint_signs[name]`
        (default +1, no flip), symmetric to the read path in
        `get_observation`. Use this when a specific motor's wiring direction
        disagrees with the URDF axis.
        """
        # URDF-space goal from the incoming action.
        urdf_goal = {
            key.removesuffix(".pos"): val
            for key, val in action.items()
            if key.endswith(".pos")
        }

        # 1. Clip in URDF space (joint_limits are URDF-correct degrees).
        for motor_name, position in urdf_goal.items():
            if motor_name in self.config.joint_limits:
                min_limit, max_limit = self.config.joint_limits[motor_name]
                clipped = max(min_limit, min(max_limit, position))
                if clipped != position:
                    logger.debug(f"Clipped {motor_name} from {position:.2f}° to {clipped:.2f}°")
                urdf_goal[motor_name] = clipped

        # 2. Flip into motor space (per-joint sign). Everything from here to
        #    the bus send happens in motor-encoder direction.
        motor_goal = {name: val * self._joint_sign(name) for name, val in urdf_goal.items()}

        # 3. Max-relative-target safety in motor space (`present_pos` is raw
        #    encoder space from the bus, so motor_goal must be in motor space).
        if self.config.max_relative_target is not None:
            present_pos = self.bus.sync_read("Present_Position")
            goal_present_pos = {k: (g, present_pos[k]) for k, g in motor_goal.items()}
            motor_goal = ensure_safe_goal_position(goal_present_pos, self.config.max_relative_target)
            # max_relative_target may have re-clipped; reflect the change back
            # into URDF space so the return value matches what actually got
            # commanded (in URDF convention).
            urdf_goal = {name: val * self._joint_sign(name) for name, val in motor_goal.items()}

        # 4. Send MIT commands in motor space.
        motor_index = {name: i for i, name in enumerate(self.config.motor_config.keys())}
        commands = {}
        for motor_name, position_degrees in motor_goal.items():
            idx = motor_index.get(motor_name, 0)
            if custom_kp is not None and motor_name in custom_kp:
                kp = custom_kp[motor_name]
            else:
                kp = (
                    self.config.position_kp[idx]
                    if isinstance(self.config.position_kp, list)
                    else self.config.position_kp
                )
            if custom_kd is not None and motor_name in custom_kd:
                kd = custom_kd[motor_name]
            else:
                kd = (
                    self.config.position_kd[idx]
                    if isinstance(self.config.position_kd, list)
                    else self.config.position_kd
                )
            commands[motor_name] = (kp, kd, position_degrees, 0.0, 0.0)

        self.bus._mit_control_batch(commands)

        # 5. Return URDF-space goal (same convention as the input action).
        return {f"{motor}.pos": val for motor, val in urdf_goal.items()}
