pollen-robotics/grabette/integrations/openarm/openarm_gripette/openarm_gripette/config_openarm7_follower.py

#!/usr/bin/env python

# Copyright 2025 The HuggingFace Inc. team. All rights reserved.
#
# Licensed under the Apache License, Version 2.0 (the "License");
# you may not use this file except in compliance with the License.
# You may obtain a copy of the License at
#
#     http://www.apache.org/licenses/LICENSE-2.0
#
# Unless required by applicable law or agreed to in writing, software
# distributed under the License is distributed on an "AS IS" BASIS,
# WITHOUT WARRANTIES OR CONDITIONS OF ANY KIND, either express or implied.
# See the License for the specific language governing permissions and
# limitations under the License.

"""Config for the 7-DOF OpenArm without a gripper on the CAN bus.

Use this when the gripper is controlled via a separate interface (e.g. the
Gripette has its own gRPC service, so the CAN-side driver only needs to
handle the 7 arm joints).
"""

from dataclasses import dataclass, field

from lerobot.robots import RobotConfig
from lerobot.robots.openarm_follower import OpenArmFollowerConfigBase

# Default arm joint limits (degrees). These match the standard OpenArm arm.
RIGHT_DEFAULT_JOINTS_LIMITS: dict[str, tuple[float, float]] = {
    "joint_1": (-75.0, 75.0),
    "joint_2": (-9.0, 90.0),
    "joint_3": (-85.0, 85.0),
    "joint_4": (0.0, 135.0),
    "joint_5": (-85.0, 85.0),
    "joint_6": (-40.0, 40.0),
    "joint_7": (-80.0, 80.0),
}

LEFT_DEFAULT_JOINTS_LIMITS: dict[str, tuple[float, float]] = {
    "joint_1": (-75.0, 75.0),
    "joint_2": (-90.0, 9.0),
    "joint_3": (-85.0, 85.0),
    "joint_4": (0.0, 135.0),
    "joint_5": (-85.0, 85.0),
    "joint_6": (-40.0, 40.0),
    "joint_7": (-80.0, 80.0),
}


@dataclass
class OpenArm7FollowerConfigBase(OpenArmFollowerConfigBase):
    """Config for the 7-DOF arm-only variant of the OpenArm follower.

    No gripper motor on the CAN bus — the gripper is expected to be controlled
    via a separate interface (gRPC, USB, etc.).
    """

    # lerobot 0.6.0 gates per-motor .vel/.torque observations behind this flag,
    # defaulting to False (position-only, for the openarm_mini teleoperator).
    # Keep the 0.5.x OBSERVATION shape: datasets recorded with this robot keep
    # their velocity/torque columns. OpenArm7Follower.action_features overrides
    # the upstream shared feature map so actions remain position-only.
    use_velocity_and_torque: bool = True

    # 7 arm joints, no gripper. Same CAN IDs and motor types as the standard OpenArm.
    motor_config: dict[str, tuple[int, int, str]] = field(
        default_factory=lambda: {
            "joint_1": (0x01, 0x11, "dm8009"),
            "joint_2": (0x02, 0x12, "dm8009"),
            "joint_3": (0x03, 0x13, "dm4340"),
            "joint_4": (0x04, 0x14, "dm4340"),
            "joint_5": (0x05, 0x15, "dm4310"),
            "joint_6": (0x06, 0x16, "dm4310"),
            "joint_7": (0x07, 0x17, "dm4310"),
        }
    )

    # MIT control gains for the 7 arm joints (matches OpenArmFollower defaults minus the gripper).
    position_kp: list[float] = field(
        default_factory=lambda: [240.0, 240.0, 240.0, 240.0, 24.0, 31.0, 25.0]
    )
    position_kd: list[float] = field(
        default_factory=lambda: [5.0, 5.0, 3.0, 5.0, 0.3, 0.3, 0.3]
    )

    # Safe default joint limits. Override via CLI or set config.side='left'/'right'.
    joint_limits: dict[str, tuple[float, float]] = field(
        default_factory=lambda: {
            "joint_1": (-5.0, 5.0),
            "joint_2": (-5.0, 5.0),
            "joint_3": (-5.0, 5.0),
            "joint_4": (0.0, 5.0),
            "joint_5": (-5.0, 5.0),
            "joint_6": (-5.0, 5.0),
            "joint_7": (-5.0, 5.0),
        }
    )

    # Per-joint sign multipliers applied symmetrically to read AND write paths.
    # Use only when a specific motor's physical rotation direction disagrees
    # with the URDF axis (and you can't or don't want to fix it in Damiao
    # firmware via the official OpenArm tool). Default = +1 for every joint
    # (no flip), preserving identical behavior to upstream.
    #
    # Per-robot overrides: each physical OpenArm may have different motor
    # wiring directions. Set per-robot via the `grpc_server_real.py` CLI flag
    # `--flip_joint_signs joint_7` (etc.), or by constructing the config
    # programmatically. Do NOT bake your robot's specific flips into this
    # default — that breaks portability to other robots / sim.
    #
    # Example: if commanded joint_7=+30° physically rotates the wrist
    # opposite to URDF's +Z axis on YOUR specific arm, pass
    # `--flip_joint_signs joint_7` to the server.
    joint_signs: dict[str, float] = field(
        default_factory=lambda: {
            "joint_1": +1.0,
            "joint_2": +1.0,
            "joint_3": +1.0,
            "joint_4": +1.0,
            "joint_5": +1.0,
            "joint_6": +1.0,
            "joint_7": +1.0,
        }
    )


@RobotConfig.register_subclass("openarm7_follower")
@dataclass
class OpenArm7FollowerConfig(RobotConfig, OpenArm7FollowerConfigBase):
    pass
