pollen-robotics/grabette/packages/grabette/grabette/config.py

"""Configuration management using Pydantic Settings."""

from __future__ import annotations

import uuid
from pathlib import Path
from typing import Literal

from pydantic import field_validator, model_validator
from pydantic_settings import BaseSettings


def _stable_device_id() -> str:
    """Return a stable per-device id, persisted across restarts."""
    path = Path.home() / ".cache" / "grabette" / "device_id"
    if path.exists():
        return path.read_text().strip()
    did = f"grabette-{uuid.uuid4().hex[:8]}"
    path.parent.mkdir(parents=True, exist_ok=True)
    path.write_text(did)
    return did


class Settings(BaseSettings):
    model_config = {
        "env_prefix": "GRABETTE_",
        "env_file": ".env",
        "env_file_encoding": "utf-8",
    }

    # Server
    host: str = "0.0.0.0"
    port: int = 8000

    # Backend
    backend: str = "auto"  # "auto", "mock", or "rpi"

    # Data
    data_dir: Path = Path.home() / "grabette-data"

    # Camera
    camera_fps: int = 46
    camera_resolution_w: int = 1296
    camera_resolution_h: int = 972

    # IMU
    imu_hz: int = 200

    # Angle sensors (AS5600 on I2C buses 4 & 5)
    angle_sensors: bool = True

    # ------------------------------------------------------------------
    # Robot-frame angle convention (matches the gripette runtime):
    #   0 rad        = fingers fully open
    #   positive rad = closing
    # The AS5600L magnets rotate in directions determined by the physical
    # sensor mounting, so we apply a sign per channel to produce the
    # convention above. The sign per finger depends on which hand this
    # is (mirror builds); override individual signs only for asymmetric
    # hardware revisions.
    # ------------------------------------------------------------------
    hand: Literal["left", "right"] = "right"

    # Per-sensor sign for raw -> robot-frame mapping (+1 or -1). Derived
    # from `hand` in the model validator below unless explicitly set via
    # GRABETTE_PROXIMAL_SIGN / GRABETTE_DISTAL_SIGN.
    proximal_sign: int | None = None
    distal_sign: int | None = None

    # OAK-D SR — default OFF to save battery. Toggle from the UI to enable.
    enable_oakd: bool = False
    # After a capture that auto-enabled the OAK-D, keep it warm this many
    # seconds before powering down — lets back-to-back recordings start
    # instantly instead of paying the cold-boot warmup each time.
    oakd_keepalive_s: float = 30.0

    # Which depth camera `enable_oakd` brings up. "oakd" is the Luxonis OAK-D SR
    # via depthai; "gemini305" is the Orbbec Gemini 305 via pyorbbecsdk2, kept as
    # a second source so the rig is not single-sourced on Luxonis. This selects
    # the model only — enable_oakd still controls whether it is powered at all.
    depth_camera: Literal["oakd", "gemini305"] = "gemini305"

    # Gemini 305 IR exposure. 0 = leave the camera's auto-exposure alone.
    # AE favours low noise over short integration (~15.6 ms with gain 16 in a
    # dim room), which smears a moving rig. Pinning a shorter exposure trades
    # depth coverage for less motion blur; whether that wins depends on the
    # workspace lighting, so it is opt-in per device.
    orbbec_ir_exposure_us: int = 0
    orbbec_ir_gain: int = 0

    orbbec_rotate_180: bool = True

    # UI
    ui_enabled: bool = True

    # Hardware button (Grove LED Button on GPIO22/23)
    button_enabled: bool = True

    # Audible cue on the V2 HAT's TLV320AIC3104 codec: a beep at the instant a
    # recording actually goes live (after the OAK-D warm-up), so the operator
    # doesn't have to watch the LED — and a whole group beeps together at T0.
    # Degrades silently when the codec isn't set up (see `make install-audio`).
    sound_enabled: bool = True
    # ALSA device. Empty = auto-detect the codec BY CARD NAME
    # (plughw:CARD=aic3104) — never by index, since on a Pi 4 the vc4-hdmi
    # cards shift the numbering. Set explicitly only to override.
    sound_device: str = ""
    # Default speaker volume, 0..1 (the dashboard's 0..100 %), used until one is
    # picked on the dashboard. Set on the codec mixer, see hardware/sound.py
    # (DAC_MIN/DAC_MAX). 0.5 gives the level scripts/aic3104-init.sh sets at
    # boot ('Line DAC Playback Volume' 45).
    sound_volume: float = 0.5

    # Logging
    log_level: str = "INFO"

    # Fleet relay
    relay_url: str = "https://pollen-robotics-grabette-fleet.hf.space"
    relay_enabled: bool = True
    device_id: str = ""
    device_name: str = ""

    @field_validator("device_id", mode="before")
    @classmethod
    def _resolve_device_id(cls, v: str) -> str:
        return v or _stable_device_id()

    @field_validator("device_name", mode="before")
    @classmethod
    def _resolve_device_name(cls, v: str) -> str:
        if v:
            return v
        import socket
        return socket.gethostname()

    @model_validator(mode="after")
    def _derive_signs_from_hand(self):
        # V2 mechanical: the two AS5600L magnets rotate in OPPOSITE
        # directions when the fingers close (distal mounted upside-down
        # relative to proximal). So for a given hand the per-sensor signs
        # have OPPOSITE values. The right vs left build is the mirror
        # image, which negates both signs at once.
        #
        # Right hand: distal=+1, proximal=-1 → both go positive on close.
        # Left hand:  distal=-1, proximal=+1 → both go positive on close.
        # (The left configuration happens to match what the OLD code used
        # to call 'right' under the negative-closing convention. Renamed
        # consistently with the new positive=closing convention.)
        right_signs = {"distal": +1, "proximal": -1}
        left_signs = {"distal": -1, "proximal": +1}
        default = right_signs if self.hand == "right" else left_signs
        if self.distal_sign is None:
            self.distal_sign = default["distal"]
        if self.proximal_sign is None:
            self.proximal_sign = default["proximal"]
        return self


settings = Settings()
