pollen-robotics/grabette/packages/casquette/casquette/hardware/camera.py

"""Video capture using picamera2 with H.264 encoding.

Ported from grabette-capture/grabette_capture/video.py.
"""

import logging
import subprocess
import threading
import time
from pathlib import Path

from .sync import SyncManager

logger = logging.getLogger(__name__)


class VideoCapture:
    """Captures video from CSI camera using picamera2.

    Default configuration:
        - Resolution: 1296x972 (native OV5647 binned mode)
        - Frame rate: 46 fps (CFR)
        - Codec: H.264 at ~5 Mbps
    """

    DEFAULT_RESOLUTION = (1296, 972)
    DEFAULT_FPS = 46
    DEFAULT_BITRATE = 5_000_000

    # Background mux threads, tracked across all VideoCapture instances so a
    # new capture can detect that a previous clip's ffmpeg mux is still
    # running. RpiBackend builds a fresh VideoCapture per capture, so each
    # background thread keeps its own instance's paths alive — no cross-clip
    # race — but stacked ffmpegs compete for CPU on the Pi Zero 2W, so we warn.
    _live_mux_threads: list[threading.Thread] = []

    def __init__(
        self,
        sync_manager: SyncManager,
        resolution: tuple[int, int] = DEFAULT_RESOLUTION,
        fps: int = DEFAULT_FPS,
        bitrate: int = DEFAULT_BITRATE,
        preview: bool = False,
        exposure_us: int = 0,
    ):
        self.sync = sync_manager
        self.resolution = resolution
        self.fps = fps
        self.bitrate = bitrate
        self.preview = preview
        # 0 = use libcamera auto-exposure. Non-zero = fixed exposure in
        # microseconds (auto-gain still applies). Useful to fight motion
        # blur for ArUco-style detection.
        self.exposure_us = exposure_us

        self._picam2 = None
        self._encoder = None
        self._output_path: Path | None = None
        self._h264_path: Path | None = None
        self._frame_timestamps: list[float] = []
        self._recording = False
        self._first_sensor_ts: int | None = None
        self._sync_offset_ms: float = 0.0

    def init_camera(self) -> None:
        """Initialize picamera2 with CFR configuration."""
        from picamera2 import Picamera2, Preview
        from picamera2.encoders import H264Encoder

        self._picam2 = Picamera2()
        frame_duration_us = int(1_000_000 / self.fps)

        # Build controls dict; FrameDurationLimits forces CFR. Add a
        # fixed ExposureTime if exposure_us > 0; libcamera's auto-gain
        # still adjusts for ambient light at the fixed shutter speed.
        controls: dict = {
            "FrameDurationLimits": (frame_duration_us, frame_duration_us),
        }
        if self.exposure_us > 0:
            controls["ExposureTime"] = int(self.exposure_us)
            logger.info("Camera fixed exposure: %d µs", self.exposure_us)

        if self.preview:
            video_config = self._picam2.create_video_configuration(
                main={"size": self.resolution, "format": "RGB888"},
                lores={"size": (640, 480), "format": "YUV420"},
                display="lores",
                controls=controls,
            )
        else:
            video_config = self._picam2.create_video_configuration(
                main={"size": self.resolution, "format": "RGB888"},
                controls=controls,
            )
        self._picam2.configure(video_config)
        self._encoder = H264Encoder(bitrate=self.bitrate)

        if self.preview:
            try:
                self._picam2.start_preview(Preview.QTGL)
            except Exception:
                try:
                    self._picam2.start_preview(Preview.DRM)
                except Exception:
                    logger.warning("Could not start preview")

        self._picam2.start()

    def set_exposure_us(self, us: int) -> int:
        """Set fixed exposure at runtime. Returns the value actually applied.

        us > 0: fixed exposure in microseconds; auto-gain still active.
        us == 0: re-enable libcamera auto-exposure (best-effort — exact
                 behaviour depends on libcamera version, may require a
                 daemon restart to fully unstick a previously fixed value).
        """
        if self._picam2 is None:
            raise RuntimeError("Camera not initialized")
        if us > 0:
            self._picam2.set_controls({"ExposureTime": int(us)})
            self.exposure_us = int(us)
            logger.info("Camera exposure → %d µs (fixed)", us)
        else:
            self._picam2.set_controls({"AeEnable": True})
            self.exposure_us = 0
            logger.info("Camera exposure → AUTO")
        return self.exposure_us

    def _on_frame(self, request) -> None:
        if self._recording:
            metadata = request.get_metadata()
            sensor_ts_ns = metadata.get("SensorTimestamp")

            if sensor_ts_ns is not None:
                if self._first_sensor_ts is None:
                    self._first_sensor_ts = sensor_ts_ns
                    self._sync_offset_ms = self.sync.get_timestamp_ms()
                ts = (sensor_ts_ns - self._first_sensor_ts) / 1_000_000.0 + self._sync_offset_ms
            else:
                ts = self.sync.get_timestamp_ms()

            self._frame_timestamps.append(ts)

    def start_recording(self, output_path: Path) -> None:
        if self._recording:
            raise RuntimeError("Video capture already running")
        if self._picam2 is None:
            raise RuntimeError("Camera not initialized. Call init_camera() first.")
        if not self.sync.is_started:
            raise RuntimeError("SyncManager must be started before video capture")

        # Sweep finished background mux threads; warn if a previous clip's
        # mux is still running (safe — different files — but ffmpeg will
        # compete for CPU with this recording on the Pi Zero 2W).
        VideoCapture._live_mux_threads = [
            t for t in VideoCapture._live_mux_threads if t.is_alive()
        ]
        if VideoCapture._live_mux_threads:
            logger.warning(
                "start_recording: %d previous mux thread(s) still running; "
                "recording will start fine but ffmpeg competes for CPU until "
                "they finish",
                len(VideoCapture._live_mux_threads),
            )

        self._output_path = Path(output_path)
        self._h264_path = self._output_path.with_suffix(".h264")
        self._frame_timestamps = []
        self._first_sensor_ts = None
        self._sync_offset_ms = 0.0

        self._picam2.pre_callback = self._on_frame
        self._recording = True
        self._picam2.start_encoder(self._encoder, str(self._h264_path))

    def stop(self) -> list[float]:
        if not self._recording:
            return self._frame_timestamps

        self._recording = False
        # Per-phase timing, emitted at DEBUG only (set CASQUETTE_LOG_LEVEL=DEBUG).
        t: dict[str, float] = {}

        _s = time.monotonic()
        self._picam2.stop_encoder()
        t["stop_encoder"] = (time.monotonic() - _s) * 1000

        _s = time.monotonic()
        if self.preview:
            try:
                self._picam2.stop_preview()
            except Exception:
                pass
        self._picam2.stop()
        t["picam2_stop"] = (time.monotonic() - _s) * 1000

        _s = time.monotonic()
        self._picam2.close()
        self._picam2 = None
        self._encoder = None
        t["picam2_close"] = (time.monotonic() - _s) * 1000

        # Background the ffmpeg mux. On the Pi Zero 2W ffmpeg takes ~5-7 s for
        # typical clips, and the .mp4 doesn't need to be ready when stop()
        # returns — running it off-thread keeps the stop path from blocking
        # the next recording. The .h264 is durable on disk; the .mp4
        # materialises when the thread finishes (logged on completion). If the
        # daemon is killed mid-mux the .h264 survives for offline muxing.
        self._mux_thread = threading.Thread(
            target=self._mux_to_mp4_background,
            daemon=True,
            name="mux-to-mp4",
        )
        self._mux_thread.start()
        VideoCapture._live_mux_threads.append(self._mux_thread)

        logger.debug(
            "VideoCapture.stop timing ms: %s total=%.0f (mux backgrounded)",
            " ".join(f"{k}={v:.0f}" for k, v in t.items()),
            sum(t.values()),
        )
        return self._frame_timestamps

    def _mux_to_mp4_background(self) -> None:
        """Run the ffmpeg mux off the stop path (see stop())."""
        t0 = time.monotonic()
        try:
            self._mux_to_mp4()
        except Exception:
            logger.exception(
                "Background mux failed; .h264 left on disk for manual recovery"
            )
            return
        logger.info(
            "Background mux completed in %.0f ms → %s",
            (time.monotonic() - t0) * 1000, self._output_path,
        )

    def _mux_to_mp4(self) -> None:
        if self._h264_path is None or self._output_path is None:
            return
        if not self._h264_path.exists():
            raise RuntimeError(f"H.264 file not found: {self._h264_path}")

        actual_fps = self.fps
        if len(self._frame_timestamps) >= 2:
            duration_ms = self._frame_timestamps[-1] - self._frame_timestamps[0]
            if duration_ms > 0:
                actual_fps = (len(self._frame_timestamps) - 1) / (duration_ms / 1000.0)

        cmd = [
            "ffmpeg", "-y", "-fflags", "+genpts",
            "-r", str(actual_fps), "-i", str(self._h264_path),
            "-c", "copy", "-video_track_timescale", "90000",
            str(self._output_path),
        ]
        result = subprocess.run(cmd, capture_output=True, text=True)
        if result.returncode != 0:
            raise RuntimeError(f"ffmpeg muxing failed: {result.stderr}")
        self._h264_path.unlink()

    @property
    def frame_count(self) -> int:
        return len(self._frame_timestamps)
