pollen-robotics/grabette/packages/grabette/grabette/daemon.py

from __future__ import annotations

import asyncio
import logging
import threading
from collections import deque
from enum import Enum

from grabette.backend.base import Backend

logger = logging.getLogger(__name__)


class SampleRing:
    """Thread-safe ring buffer with cursor-based reads (multi-consumer safe)."""

    def __init__(self, maxlen: int = 500) -> None:
        self._imu: deque[tuple[int, dict]] = deque(maxlen=maxlen)
        self._angle: deque[tuple[int, dict]] = deque(maxlen=maxlen)
        self._seq = 0
        self._lock = threading.Lock()

    def push_state(self, state) -> None:
        with self._lock:
            self._seq += 1
            seq = self._seq
            if state.imu is not None:
                s = state.imu
                self._imu.append((seq, {"t": s.timestamp_ms, "a": list(s.accel), "g": list(s.gyro)}))
            if state.angle is not None:
                s = state.angle
                self._angle.append((seq, {"t": s.timestamp_ms, "p": s.proximal, "d": s.distal}))

    def push_raw(self, imu: dict | None = None, angle: dict | None = None) -> None:
        """Push pre-formatted dicts directly (used by ReplayEngine)."""
        with self._lock:
            self._seq += 1
            seq = self._seq
            if imu is not None:
                self._imu.append((seq, imu))
            if angle is not None:
                self._angle.append((seq, angle))

    def get_since(self, cursor: int = 0) -> dict:
        """Return samples with seq > cursor. Multiple consumers can read independently."""
        with self._lock:
            imu = [s for seq, s in self._imu if seq > cursor]
            angle = [s for seq, s in self._angle if seq > cursor]
            seq = self._seq
        return {"imu": imu, "angle": angle, "cursor": seq}


class DaemonState(str, Enum):
    NOT_INITIALIZED = "not_initialized"
    STARTING = "starting"
    RUNNING = "running"
    STOPPING = "stopping"
    STOPPED = "stopped"
    ERROR = "error"


class Daemon:
    def __init__(self, backend: Backend) -> None:
        self.backend = backend
        self.state = DaemonState.NOT_INITIALIZED
        self._error: str | None = None
        self.sample_ring = SampleRing()
        self._poll_task: asyncio.Task | None = None
        self._replay: "ReplayEngine | None" = None  # noqa: F821  forward ref; real import is deferred (see below) to avoid a cycle
        self._generation: int = 0
        self._last_state = None  # latest SensorState from the poll loop (for status, non-blocking)

    async def start(self) -> None:
        if self.state not in (DaemonState.NOT_INITIALIZED, DaemonState.STOPPED, DaemonState.ERROR):
            logger.warning("Cannot start daemon from state %s", self.state)
            return
        self.state = DaemonState.STARTING
        self._error = None
        try:
            await self.backend.start()
            self._poll_task = asyncio.create_task(self._poll_loop())
            self.state = DaemonState.RUNNING
            logger.info("Daemon started with backend %s", type(self.backend).__name__)
        except Exception as exc:
            self._error = str(exc)
            self.state = DaemonState.ERROR
            logger.exception("Failed to start daemon")

    async def stop(self) -> None:
        if self.state != DaemonState.RUNNING:
            logger.warning("Cannot stop daemon from state %s", self.state)
            return
        self.state = DaemonState.STOPPING
        try:
            if self._poll_task is not None:
                self._poll_task.cancel()
                try:
                    await self._poll_task
                except asyncio.CancelledError:
                    pass
                self._poll_task = None
            await self.backend.stop()
            self.state = DaemonState.STOPPED
            logger.info("Daemon stopped")
        except Exception as exc:
            self._error = str(exc)
            self.state = DaemonState.ERROR
            logger.exception("Failed to stop daemon")

    async def restart(self) -> None:
        if self.state == DaemonState.RUNNING:
            await self.stop()
        await asyncio.sleep(0.1)
        await self.start()

    async def _poll_loop(self) -> None:
        """Poll backend at ~50Hz and push samples into the ring buffer.

        backend.get_state() does blocking I2C reads on the angle sensor when
        the daemon is idle (not capturing). Running it directly on the event
        loop blocks every other async task — including the teleop WS stream,
        UI HTTP responses, and any router endpoint — for ~5ms every 20ms.
        We hand it off to the default thread pool so the loop stays free.
        """
        loop = asyncio.get_running_loop()
        while True:
            try:
                state = await loop.run_in_executor(None, self.backend.get_state)
                self.sample_ring.push_state(state)
                self._last_state = state  # cache for the (non-blocking) status property
            except Exception:
                logger.debug("Poll loop sample error", exc_info=True)
            await asyncio.sleep(0.02)  # 50Hz

    def latest_state(self):
        """Most recent SensorState from the 50Hz poll loop (~20ms old) WITHOUT a
        blocking I2C read. backend.get_state() does blocking I2C when idle, and
        callers on the event loop (the relay get_state handler, /api/state,
        /api/state/ws at 10Hz) would otherwise stall the whole device server —
        making the dashboard laggy, especially while the fleet is driving it.
        Falls back to a direct read only before the poll has produced one."""
        return self._last_state if self._last_state is not None else self.backend.get_state()

    @property
    def status(self) -> dict:
        result = {
            "state": self.state.value,
            "backend": type(self.backend).__name__,
            "error": self._error,
            # A backend-detected fault that makes capture refuse ("" = none).
            # Distinct from "error" above, which is the daemon's own start-up
            # failure: here the daemon runs fine, the HARDWARE can't produce
            # usable episodes. Rides on the status dict so it reaches the local
            # dashboard and the fleet's get_state without a second endpoint.
            "hardware_error": getattr(self.backend, "hardware_error", ""),
        }
        if self.state == DaemonState.RUNNING:
            result["sensor"] = self.latest_state().model_dump()
        return result

    # ── Replay ─────────────────────────────────────────────────────

    def get_active_ring(self) -> SampleRing:
        if self._replay is not None and self._replay.active:
            return self._replay.ring
        return self.sample_ring

    @property
    def generation(self) -> int:
        return self._generation

    async def start_replay(self, episode_dir: str, episode_id: str) -> None:
        from grabette.replay import ReplayEngine

        if self._replay is not None and self._replay.active:
            await self._replay.stop()
        engine = ReplayEngine(on_end=self._on_replay_end)
        engine.load(episode_dir, episode_id)
        await engine.start()
        self._replay = engine
        self._generation += 1
        logger.info("Replay started for %s (gen %d)", episode_id, self._generation)

    async def stop_replay(self) -> None:
        if self._replay is not None:
            await self._replay.stop()
            self._replay = None
            self._generation += 1
            logger.info("Replay stopped (gen %d)", self._generation)

    def _on_replay_end(self, engine) -> None:
        """The replay played to the end: hand the live sensors back."""
        if self._replay is engine:
            self._replay = None
            self._generation += 1
            logger.info("Replay ended (gen %d)", self._generation)

    async def replay_pause(self) -> None:
        if self._replay is not None:
            self._replay.pause()

    async def replay_resume(self) -> None:
        if self._replay is not None:
            self._replay.resume()

    async def replay_seek(self, time_ms: float) -> None:
        if self._replay is not None:
            self._replay.seek(time_ms)
            self._generation += 1
            logger.info("Replay seek to %.0fms (gen %d)", time_ms, self._generation)

    @property
    def replay_status(self) -> dict:
        if self._replay is not None:
            return self._replay.status
        return {"active": False, "episode_id": None, "time_ms": 0, "duration_ms": 0, "playing": False}
