pollen-robotics/grabette/packages/grabette/grabette/replay.py

"""Replay engine — loads a recorded episode and feeds samples into a SampleRing at real-time rate."""

from __future__ import annotations

import asyncio
import json

from grabette.hardware.episode_files import DCAM_IMU, resolve
import logging
from bisect import bisect_left
from pathlib import Path

from grabette.daemon import SampleRing

logger = logging.getLogger(__name__)


class ReplayEngine:
    def __init__(self, on_end=None) -> None:
        # Called once playback reaches the end; the engine is inactive by then.
        self._on_end = on_end
        self.ring = SampleRing(maxlen=500)
        self._episode_id: str | None = None
        self._duration_ms: float = 0
        self._imu_samples: list[dict] = []   # {"t", "a", "g"}
        self._angle_samples: list[dict] = []  # {"t", "p", "d"}
        self._imu_times: list[float] = []
        self._angle_times: list[float] = []
        self._playback_ms: float = 0
        self._playing: bool = False
        self._active: bool = False
        self._task: asyncio.Task | None = None

    @property
    def active(self) -> bool:
        return self._active

    @property
    def status(self) -> dict:
        return {
            "active": self._active,
            "episode_id": self._episode_id,
            "time_ms": self._playback_ms,
            "duration_ms": self._duration_ms,
            "playing": self._playing,
        }

    def load(self, episode_dir: str, episode_id: str) -> None:
        """Load sensor data + metadata from an episode directory.

        Supports three data layouts:
        - imu_data.json   : legacy casquette format (ACCL/GYRO/ANGL streams)
        - dcam_imu.json   : depth-camera format (interleaved kind/accel/gyro samples)
        - angle_data.json : grabette angle sensor ({"cts", "value": [distal, proximal]})
        """
        path = Path(episode_dir)

        # Load duration from metadata
        meta_path = path / "metadata.json"
        meta = {}
        if meta_path.exists():
            # Same tolerance as TaskManager._get_episode_info: an episode whose
            # metadata was truncated by an interrupted write still has its video
            # and IMU, so replay it at duration 0 rather than raising.
            try:
                meta = json.loads(meta_path.read_text())
            except (OSError, ValueError) as e:
                logger.warning("Unreadable metadata for replay of %s: %s", path, e)
        self._duration_ms = meta.get("duration_seconds", 0) * 1000

        self._imu_samples = []
        self._angle_samples = []

        # Legacy casquette format: imu_data.json with ACCL/GYRO/ANGL streams
        imu_path = path / "imu_data.json"
        if imu_path.exists():
            with open(imu_path) as f:
                data = json.load(f)
            streams = data.get("1", {}).get("streams", {})
            accl_samples = streams.get("ACCL", {}).get("samples", [])
            gyro_samples = streams.get("GYRO", {}).get("samples", [])
            angl_samples = streams.get("ANGL", {}).get("samples", [])

            n_imu = min(len(accl_samples), len(gyro_samples))
            for i in range(n_imu):
                a = accl_samples[i]
                g = gyro_samples[i]
                self._imu_samples.append({"t": a["cts"], "a": a["value"], "g": g["value"]})

            # value=[sensor1, sensor2]: sensor1=distal(v[0]), sensor2=proximal(v[1])
            for s in angl_samples:
                v = s["value"]
                self._angle_samples.append({"t": s["cts"], "p": v[1], "d": v[0]})

        # Depth-camera format: dcam_imu.json (legacy oakd_imu.json) with
        # interleaved accel/gyro/rotation packets
        if not self._imu_samples:
            dcam_imu_path = resolve(path, DCAM_IMU)
            if dcam_imu_path.exists():
                with open(dcam_imu_path) as f:
                    data = json.load(f)
                samples = data.get("samples", [])
                accels = [(s["host_ms"], s["value"]) for s in samples if s.get("kind") == "accel"]
                gyros  = [(s["host_ms"], s["value"]) for s in samples if s.get("kind") == "gyro"]
                n = min(len(accels), len(gyros))
                for i in range(n):
                    self._imu_samples.append({
                        "t": accels[i][0],
                        "a": accels[i][1],
                        "g": gyros[i][1],
                    })

        # Grabette angle sensor: angle_data.json with {"cts", "value": [distal, proximal]}
        if not self._angle_samples:
            angle_path = path / "angle_data.json"
            if angle_path.exists():
                with open(angle_path) as f:
                    data = json.load(f)
                for s in data.get("samples", []):
                    v = s["value"]
                    self._angle_samples.append({"t": s["cts"], "p": v[1], "d": v[0]})

        self._imu_times = [s["t"] for s in self._imu_samples]
        self._angle_times = [s["t"] for s in self._angle_samples]

        # Fall back to data duration if metadata missing
        if self._duration_ms == 0 and self._imu_times:
            self._duration_ms = self._imu_times[-1]

        self._episode_id = episode_id
        logger.info(
            "Replay loaded: %s — %d IMU, %d angle samples, %.1fs",
            episode_id, len(self._imu_samples), len(self._angle_samples),
            self._duration_ms / 1000,
        )

    async def start(self) -> None:
        self._playback_ms = 0
        self._playing = True
        self._active = True
        self.ring = SampleRing(maxlen=500)
        self._task = asyncio.create_task(self._feed_loop())

    async def stop(self) -> None:
        self._playing = False
        self._active = False
        if self._task is not None:
            self._task.cancel()
            try:
                await self._task
            except asyncio.CancelledError:
                pass
            self._task = None

    def pause(self) -> None:
        self._playing = False

    def resume(self) -> None:
        self._playing = True

    def seek(self, time_ms: float) -> None:
        """Seek to a position — replace ring and pre-fill ~1s of trailing context."""
        time_ms = max(0, min(time_ms, self._duration_ms))
        self._playback_ms = time_ms
        self.ring = SampleRing(maxlen=500)

        # Pre-fill ~1s of trailing context
        context_start = max(0, time_ms - 1000)
        self._push_window(context_start, time_ms)

    def _push_window(self, from_ms: float, to_ms: float) -> None:
        """Push all samples in [from_ms, to_ms) into the ring."""
        # IMU
        i_start = bisect_left(self._imu_times, from_ms)
        i_end = bisect_left(self._imu_times, to_ms)
        for i in range(i_start, i_end):
            self.ring.push_raw(imu=self._imu_samples[i])

        # Angle
        a_start = bisect_left(self._angle_times, from_ms)
        a_end = bisect_left(self._angle_times, to_ms)
        for i in range(a_start, a_end):
            self.ring.push_raw(angle=self._angle_samples[i])

    async def _feed_loop(self) -> None:
        """Run at 50Hz, advancing playback_ms by 20ms each tick."""
        tick_ms = 20.0
        try:
            while self._active:
                if self._playing:
                    prev = self._playback_ms
                    self._playback_ms += tick_ms
                    if self._playback_ms >= self._duration_ms:
                        self._playback_ms = self._duration_ms
                        self._push_window(prev, self._playback_ms)
                        self._playing = False
                        self._active = False
                        logger.info("Replay reached end of episode")
                        # Ending here, not paused at the end: a replay left
                        # active pins every live reading (3D model, charts) to
                        # its last sample once nobody is watching it.
                        if self._on_end is not None:
                            self._on_end(self)
                        return
                    self._push_window(prev, self._playback_ms)
                await asyncio.sleep(tick_ms / 1000)
        except asyncio.CancelledError:
            pass
