pollen-robotics/grabette/packages/grabette/grabette/capture_scheduler.py

"""Schedules a capture start at a future UTC instant, for synchronized
multi-device group recordings.

Used by every local start trigger — the physical button (button_listener.py),
the local UI (app/routers/sessions.py), and fleet-dispatched commands
(app/main.py) — so a device grouped in grabette-fleet starts in lockstep with
its peers regardless of which one actually triggered the recording. Each
device waits out T0 on its own NTP-disciplined clock, so the round-trip
latency to discover/notify peers only delays when T0 is picked, not how
tightly the group starts once it fires.

A single process-wide instance (get_capture_scheduler()) since there's only
ever one capture — scheduled or running — per device.
"""

from __future__ import annotations

import asyncio
import logging
from datetime import datetime, timezone
from pathlib import Path

from grabette.hardware.sound import cue_error

logger = logging.getLogger(__name__)


class CaptureScheduler:
    def __init__(self) -> None:
        self._task: asyncio.Task | None = None
        self._start_at_utc: datetime | None = None
        # True once T0 has fired and backend.start_capture is in flight.
        # Distinguishes "safe to cancel" (still waiting) from "must let it
        # finish" (hardware init in progress) when a stop races the start.
        self._starting: bool = False
        # Background task for a synchronized stop (wait until a shared T_stop,
        # then stop_capture). Mirrors the start: all group members stop at the
        # same instant instead of the pressed device stopping instantly and
        # peers lagging by the command round-trip.
        self._stop_task: asyncio.Task | None = None

    def is_scheduled(self) -> bool:
        return self._task is not None and not self._task.done()

    @property
    def is_starting(self) -> bool:
        return self._starting

    @property
    def scheduled_start_utc(self) -> datetime | None:
        return self._start_at_utc if self.is_scheduled() else None

    async def schedule(self, backend, sm, episode_dir: Path, start_at_utc: datetime) -> None:
        """Start a background wait-then-start task for a synchronized start.
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
