pollen-robotics/grabette/(commit log)

2026-06-08 Initial monorepo: GRABETTE software workspace
    Consolidate the GRABETTE software components into a single uv workspace,
    replacing the per-component repositories as the project exits POC.
    Layout:
    packages/ arm-agnostic core
    grabette on-device collection service (was pollen-robotics/grabette)
    casquette POV head-cam collection service
    gripette gripper gRPC service
    grabette-postprocess SLAM -> LeRobot dataset pipeline (renamed from grabette-data)
    integrations/openarm reference integration for the OpenArm arm
    openarm_gripette_simu MuJoCo sim + gRPC servers
    openarm_gripette_model robot description + meshes (git-lfs)
    Imported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
    [b0404.stl, backplate.stl, bmi088.stl, board.stl, bushing_6x8x4.stl, camera_imu_support.stl, composite_part_1.stl, config.txt]
2026-06-09 fix(rpi): make device install target the workspace-root venv
    In the monorepo, uv's venv lives at the workspace root, not in the package
    dir. The standalone Makefiles created/verified a .venv inside packages/<svc>/
    that uv sync/run never used, so 'make install-rpi' left the active venv without
    the rpi extra or --system-site-packages — and the service silently fell back to
    MockBackend.
    - install-rpi: create the --system-site-packages venv at WORKSPACE_ROOT and
    'uv sync --package <svc> --extra rpi [--extra ui]' into it; verify there.
    - install-systemd: patch the unit's hardcoded path to this device's actual
    workspace root so boot-time start uses the right interpreter.
    - casquette: same,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
2026-06-10 Set up the OAK in the correct orientation.
    [oakd.py, oakd_teleop.py]
2026-06-11 Fix post-processing for upright OAK.
    [robot.urdf]
2026-06-11 Replay was not working
    [replay.py]
2026-06-11 Fix physical button task
    [button_listener.py]
2026-06-17 Modify depth frame capture in mkv format.
2026-06-17 Import connector_demo to grabette
2026-06-17 Revert "Remove old content"
    This reverts commit 9d607f5b5036d97a9e2d5de41af6d44a7f874539.
    [__main__.py, auth.py, webauth.py]
2026-06-17 updated urdf
    [602_00009_phillips_flat_head__m2_x_0_40mm_thread__14mm_long_screw_92010a802.stl, 602_00009_phillips_flat_head__m2_x_0_40mm_thread__14mm_long_screw_92010a802_1.stl, 602_00009_phillips_flat_head__m2_x_0_40mm_thread__14mm_long_screw_92010a802_2.stl, 602_00009_phillips_flat_head__m2_x_0_40mm_thread__14mm_long_screw_92010a802_3.stl, 606_00020_sr_front_cover.stl, 606_00021_sr_back_cover_py074.stl, 611_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]
2026-06-18 Try fix scan network
    [wifi.py]
2026-06-18 Authentication via relay
2026-06-18 models now ok. Need to check sign with real world
    [ase01187_elec_rpi_hat.stl, bulkhead.stl, distal_l.stl, distal_r.stl, feetech_sts3215__configuration_default.stl, flex_camera_l.stl, grip_l.stl, grip_r.stl]
2026-06-23 switch to pollen org
2026-06-24 Change post-processing architecture, fix sync imu/cam, integrate angles.
    [sync.py]
2026-06-24 Add power-off button.
    To be tested
2026-06-25 log on arm singularity and collision
    [arm_servicer.py]
2026-06-25 Fix sync of OAK and arducam.
    [camera.py, check_hardware.py, oakd.py, sync.py]
2026-06-29 Manage the pisugar power cut.
2026-06-29 Add timeout for network switch
2026-06-29 try fix key-mgmt missing
    [wifi.py]
2026-06-30 RGB camera unavailable rather that disconnected
2026-06-30 LED managed by backend.
2026-06-30 Fix LED gestion if service crashes.
    [button_listener.py]
2026-06-30 add side choice, motors calibration and closing is always positive
2026-07-01 load the correct urdf
2026-07-01 fix left grabette urdf
    [robot.urdf]
2026-07-01 add ffmpeg thread
2026-07-02 Fix ffmpeg PNG frame extraction failing under HF Space thread limit
    convert.py extracts left-camera and depth frames to PNG via ffmpeg. The
    PNG encoder defaults to frame-level multithreading and spawns ~nproc
    worker threads. In the grabette-slam HF Space the container runs under a
    restricted pids/threads cgroup, so that pool can't be created and ffmpeg
    aborts with "ff_frame_thread_encoder_init failed" / "Error while opening
    encoder for output stream #0:0", exit 1. The mp4 itself is valid (decodes
    fine locally, incl. with the same ffmpeg 4.4.2 the Space ships).
    Force -threads 1 on both PNG extractors (placed AFTER -i so it applies to
    the output encoder, not the input decoder — verified by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
2026-07-02 now filters the slam spikes
2026-07-02 add dataset filtering
2026-07-02 fix gradio tmp dir
    [main.py]
2026-07-06 Add Cad files & Assembly guide
    [Button.step, Button.stl, Cameras_Holder_L.step, Cameras_Holder_L.stl, Cameras_Holder_R.step, Cameras_Holder_R.stl, Cross_Bar.step, Cross_Bar.stl]
2026-07-06 migrate lfs
    [Button.step, Button.stl, Cameras_Holder_L.step, Cameras_Holder_L.stl, Cameras_Holder_R.step, Cameras_Holder_R.stl, Cross_Bar.step, Cross_Bar.stl]
2026-07-06 add arm control
2026-07-07 filter deltas
2026-07-08 test gripper camera
2026-07-10 add login to motors
2026-07-13 wip pi0 still bugged
    [gripper_servicer.py]
2026-07-15 docs: correct teleop rig (OAK-D SR) + note scene-dependent sim physics dt
    teleop.md: live BasaltVIO teleop runs on the OAK-D SR, not the legacy BMI088 (oakd_teleop.py); 320x200 verified unchanged. simu README: physics timestep is scene-dependent — 0.002s/500Hz default, 0.001s/1000Hz in the grasp scenes (table_grasp.xml, grabette_grasp.xml).
2026-07-16 remote eval: single-frame policy support (pi0/pi0.5) + iroh warm-up timeout
    The --policy_addr remote mode was gated to the two-frame diffusion case
    (n_obs_steps == 2). Generalize it for the pi0.5 arm session:
    - accept n_obs_steps 1 (Pi0/Pi0.5): send the freshest single frame at
    replan time with unstacked wire shapes, per the ficelle obs spec
    - raise iroh infer_timeout to 60 s: the default 5 s is tighter than a
    cold server's first inference (measured 30+ s warm-up for pi05 fp32)
    - README: document the remote-inference flow (iroh ticket through NAT,
    --dtype float32 for the pi05 bf16 flow-path clash, replan cadence)
    Wire format validated against a real ficelle pi05 server (CPU, both
    web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
2026-07-16 release: restructure Pi0Fast integration into the Pi05 recipe
    integrations/Pi0Fast -> integrations/Pi05: pi05 is the verified VLA path
    (real-arm grasps via Ficelle remote inference); pi0fast collapsed at our
    data scale and moves to Pi05/pi0fast/ as documented history.
    - README.md: the full certified recipe — money-last ladder (port smoke ->
    $2 training smoke -> full run -> generation gate -> language gate ->
    serve/eval), exact training flags (mandatory LR-schedule trio,
    empty_cameras=0, compile off with inline eval), deployment settings with
    their measured rationales (jpeg_quality, n_action_steps, grip_gain)
    - train_pi0fast.py -> train.py, docstring generalized (fresh-pipeline fix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
2026-07-16 pi05 release: document local+cloud training and local+remote inference
    - Pi05 README: HF Jobs commands (bucket-mounted output_dir for
    checkpoint persistence, pyav, $2 smoke then real run) alongside the
    local-GPU command; robot section split into local-checkpoint mode
    (~10 GB GPU on the robot machine) and Ficelle remote mode (iroh/
    websocket); explicit note that pi05 needs NO action-tokenizer stage
    (that workflow is pi0fast-only, see pi0fast/)
    - evaluate.py _load_policy_any: cast pi05/pi0 checkpoints to float32
    (saved bf16; the port's flow path has a bf16 dtype clash) and force
    compile off — local --checkpoint mode would crash on pi05 otherwise.
    Gated: old vs new load path p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
2026-07-16 gripette: fail fast on camera failure
    At boot the camera stack could start 'successfully' yet never deliver a
    frame (libcamera race): StreamState hung silently while motors kept
    responding, and inference ran on a frozen image. Convert every silent
    camera state into a loud failure:
    - boot self-check: probe one frame before exposing the gRPC API; exit
    nonzero on failure so systemd (Restart=on-failure) restarts the
    service — the field-validated cure
    - capture timeout (5 s) via capture_array(wait=False) + wait(timeout):
    a wedged pipeline raises CameraError instead of blocking forever
    (also frees the StreamState worker that used to pin the camera lock)
    - StreamState aborts the stream w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
    [camera.py, config.py, server.py, service.py]
2026-07-16 gripette: default camera config = video 648x486 @ 30 Hz
    Make the validated deployment config the code default instead of
    carrying it per-device in /etc/gripette/env. Still mode has a ~10 Hz
    capture ceiling on the Pi — far too slow for the 30 Hz stream — so a
    gripette without an env override streamed unusably slowly while looking
    healthy. (GRIPPER_JPEG_QUALITY=70 was already the default.)
    [config.py]
2026-07-16 gripette: self-heal runtime camera wedge + bounded shutdown
    Field test (2026-07-16): camera frontend timed out mid-run (libcamera
    points at the CSI connector), stream aborted loudly as designed, but
    recovery still needed a manual service restart — and stopping took ~90 s
    because picam2.stop()/close() hang on a wedged pipeline until systemd's
    default SIGKILL timeout.
    - StreamState: after 3 consecutive capture failures, os._exit(1) so
    systemd restarts the service (restart is the validated cure; a fresh
    process cleared this exact wedge). Gripper motors hold their last
    goal through the gap — MotorController.stop() never touches torque.
    - CameraCapture.stop(): run picam2 stop/close in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
    [camera.py, service.py]
2026-07-16 eval safety: hard-stop on a dead/frozen Gripette camera stream
    A camera that streamed once and stopped left CameraStream serving the
    same frame forever (the ready-flag latches and nothing checked frame
    age): the policy ran open-loop on a static image while the arm kept
    integrating deltas — observed as erratic arm motion on the real robot
    when the camera service was up but not streaming (2026-07-16).
    - get()/get_pair(): freshness gate — newest frame older than 2 s raises
    RuntimeError with an actionable message (episode aborts, no further
    arm commands) instead of feeding a stale image to the policy
    - never-streamed: startup error names GRIPPER_CAMERA_MODE, cable, and
    journalctl inst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
2026-07-17 test: pytest foundation + SessionManager regression tests, run in CI
    grabette: add 'test' extra (pytest) + tests/test_session.py locking the #79 has_imu regression (OAK-D writes oakd_imu.json), plus has_video and imu_sample_count-from-metadata. ci.yml: new 'tests' job runs pytest for the grabette package (no hardware). uv.lock: include pytest so 'uv lock --check' stays green.
2026-07-17 gripette: status web UI prototype (gripette-web)
    Glanceable 'is the gripette OK?' page + clean shutdown, isolated from
    the gripper service:
    - separate process/unit (gripette-web.service, port 8080): a UI bug
    can't touch the gripper, and the page survives to report a dead or
    wedged service
    - strictly pull-based: zero work when no browser is open; camera frames
    grabbed one at a time via the real StreamState API (grab-and-cancel,
    1 s shared cache) so health shown = actual pipeline health, at ~1
    extra capture/s only while viewed
    - stdlib http.server: no new dependencies on the Pi Zero 2W
    - shows systemd state + NRestarts (= camera-wedge counter with the
    fail-fast machinery), live vi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
    [webui.py]
2026-07-17 gripette webui: review fixes — fast status when service down, honest stale-frame display
    - full_status: skip the frame grab when Ping already failed (status stays
    fast during an outage; camera reports 'service unreachable' instead of
    repeating the raw gRPC error three times)
    - page: missing systemd info (dev machine / manual run) no longer forces a
    red banner — gRPC + camera are the real health signals
    - page: dim the last image when a frame fetch fails — a frozen frame must
    never look live
    [webui.py]
2026-07-20 test(postprocess): trajectory math + SLAM-quality/recording checks + tags
    Layer-1 pure-Python tests for grabette-postprocess (no Docker/SLAM): trajectory.py (quaternion->axis-angle, poses, angle interp+distal/proximal swap), checks.trajectory (GOOD/FAIL/drift/zigzag/speed/low-tracking verdicts), checks.recording (imu/calib/static-gripper + missing-input aggregation), checks.tags (tracking_lost/traj_with_jumps/fixed_gripper). 30 tests. Add 'test' extra to postprocess; CI 'tests' job runs them without lerobot/torch (empty __init__, modules don't import it); uv.lock refreshed.
2026-07-21 ci: add ruff lint gate + fix unused imports/f-strings across repo
    Root [tool.ruff]: ruff default rules (pyflakes + pycodestyle E4/E7/E9, no E501); generated *_pb2 stubs excluded; noisy/often-intentional style rules (E402/E701/E702/E731/E741/F841) deferred (lean gate, tighten later). Autofixed 38 safe findings (F401 unused imports, F541 empty f-strings) across 22 files. 4 residual noqa'd with reasons: 1 pandas == True mask (E712), 1 ReplayEngine forward-ref (F821 FP), 2 _hf_status_text (F821 — real latent NameError in the Gradio UI, deferred to its own issue). New CI 'lint' job runs uvx ruff. Verified: ruff clean, all 35 tests pass, packages import.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
    [aruco_explore.py, button_listener.py, calibrate_angles.py, camera_test.py, configure_motor.py]
2026-07-22 Point assembly guides.
2026-07-22 gripette: per-grasp torque-limit (grip force cap) + present_load telemetry
    Grip force becomes a consistent hardware cap set per grasp, instead of an
    object-size-dependent side effect of position error. Three additive,
    backward-compatible layers (all no-op at defaults):
    Layer 1 (motors.py): set_torque_limit(fractions 0..1) -> RAM running
    torque-limit register (NOT EEPROM), deposited last-wins and written by the
    bus thread only when changed (per-grasp, never per-tick). present_load read
    each cycle (decimated off the position hot path), Feetech direction bit
    decoded to a signed value, exposed via get_present_load().
    Layer 2 (proto x2 + both servicers): MotorCommand gains motor{1,2}_torque_lim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
    [gripper_servicer.py, motors.py, service.py]
2026-07-22 fix(eval): headless-safe --debug + correct --device handling
    Two pre-existing evaluate.py bugs (on develop, unrelated to the lerobot bump): (1) --debug crashed via cv2.imshow when OpenCV is headless (opencv-python-headless pulled by lerobot) — now tries the live window, else saves numbered frames to eval_debug_frames/ + warns once. (2) --device cpu crashed input(cuda)/weight(cpu): the preprocessor's DeviceProcessorStep is restored from the checkpoint config (cuda) — override via preprocessor_overrides; also fall back cuda->cpu when unavailable. Verified: cpu runs, --debug headless saves frames, GPU grasp path 3/3 unchanged.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
2026-07-22 docs(eval): document OpenCV headless default + GUI opt-in; drop inert overrides
    OpenCV stays headless by default (lerobot + grabette/Pi need it; one cv2 per venv). Documented in the sim README how to get a live --debug window on a workstation: uv pip install --force-reinstall opencv-python (re-run after uv sync). Removed the member-level [tool.uv] override-dependencies from openarm_gripette_simu + openarm_gripette pyprojects — uv honors override-dependencies only at the workspace root, so they were no-ops (lock unchanged after removal). --debug already degrades to saving frames headless (prior commit).
2026-07-22 gripette: present_load in robot frame (positive = closing effort)
    Map present_load into the same robot convention as the joint angles:
    positive = closing effort (matching 'positive angle closes', true for left
    and right). Applies the per-motor position sign (left/right consistent) plus
    a calibrated polarity (LOAD_CLOSING_SIGN). Sign is PRESERVED — a force driving
    the joint the other way flips it — so 'motor driving closed' and 'external
    force forcing it closed' keep opposite signs. No offset (0 effort = 0, like
    0deg = mechanical full-open). Polarity calibrated on a RIGHT unit; verify on
    a LEFT unit before trusting its load sign.
    [motors.py]
2026-07-22 chore: gitignore evaluate.py --debug frame output
2026-07-22 ci: add lerobot-boundary test lane (guards dependency bumps)
    New CI 'lerobot' job runs the tests that need lerobot actually installed — Tier A API-surface tripwires (LeRobotDataset/RGBEncoderConfig/create(rgb_encoder)/recompute_stats/...) + Tier B synthetic build_dataset round-trip — which the fast 'tests' job skips via pytest.importorskip. Installs CPU-only torch (uv pip --torch-backend=cpu, ~200MB; a workspace sync pulls the ~2.5GB CUDA wheel) and reads the lerobot spec from the postprocess pyproject so the tested version tracks the pin (no drift). This would have caught the 0.5.1->0.6.0 vcodec->rgb_encoder break automatically. Fast job now: 30 passed, 2 skipped; lerobot job: 8 passed.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
2026-07-22 docs: document the gripette grip-force cap + present_load
    User-facing docs for the torque-limit grasp feature (code merged in #101):
    - eval README: --grip_torque_limit flag (opt-in force cap, 0=full torque=old
    behavior, real-hw only, start ~0.25), --log_gripper now shows load, and the
    gRPC API table reflects the new optional torque_limit / load fields
    - gripette configuration.md: 'Grip force cap & load feedback' — RAM (not
    EEPROM) running torque-limit, backward-compatible 0=unset, and robot-frame
    present_load (positive=closing, sign preserved, left-unit verify caveat)
2026-07-22 ci(lerobot): install system FFmpeg for torchcodec
    The lerobot lane failed at Tier B (build_dataset): lerobot[dataset]'s video path uses torchcodec, which dlopens system FFmpeg (libavutil.so.* etc.) at runtime — a bare ubuntu-latest runner has none (7 passed / 1 failed; cv2 imported fine, so it was NOT libGL). Add 'apt-get install -y ffmpeg' (ubuntu-24.04 → libavutil.so.58, in torchcodec's probe set). Also drop the redundant explicit opencv-python (lerobot already provides headless cv2) + fix the comment.
2026-07-23 Sound when low battery.
2026-07-23 eval: committed-close primitive for the under-close grasp failure
    The VLAs under-CLOSE — they start a close but stop short of the object, so
    --grip_gain (deepen target) and --latch_close (hold model's shallow max)
    only partly help. Now that --grip_torque_limit makes a full close SAFE,
    decouple the close decision from its execution:
    --commit_full THRESH low intent threshold on the model's gripper cmd
    --commit_target P D the fully-closed pose to drive to on commit
    --grasp_confirm_load L (hardware) post-commit load check: empty -> reopen
    --commit_settle_steps N ticks before that check
    When the model's gripper command first crosses THRESH (a trustworthy 'I'm at
    the object' sign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
2026-07-23 Increase battery update intervall.
2026-07-23 eval: --log_gripper shows the SENT gripper command, not just model intent
    Under the committed-close primitive the sent command diverges from the
    model's raw goal (it's pinned at commit_target). Logging only the model
    value hid that the primitive was driving. Now log the actual gg1,gg2 sent,
    with the model's raw goal in parens and a COMMITTED tag — so a hardware
    operator can see the override in the trace.
    Verified in sim: regression 4/5 (unchanged baseline); commit fires, drives
    to commit_target, latches (obs holds at target); log reflects the override.
2026-07-23 Modify threshold of battery color.
2026-07-27 examples: bench tool to characterize the grabbed-vs-empty grip signal
    Gripper-only (no arm, no policy) characterization to decide how the
    committed-close confirm should work — the thing sim couldn't tell us
    (present_load is 0 in sim). Drives a torque-capped full close on an object
    vs on air, logs the load + position trajectory (ReadMotors poll), and reports
    which signal separates grabbed from empty.
    Key hypothesis it tests: with a torque cap, an empty close may load up against
    the gripper's own mechanical stop just like a grasp does, so present_load
    could saturate in BOTH cases and the real discriminator may be final POSITION
    (object stops the fingers short) rather than load. Outcome deci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
2026-07-27 sim: emit a load signal from MuJoCo actuator_force (was hardcoded 0)
    The sim gripper reported motor{1,2}_load=0 always ('no load sensor'), which
    makes the load-triggered grip-assist untestable in sim. Wire a sim ANALOG:
    Simulation.get_actuator_force reads data.actuator_force on the proximal/distal
    actuators, and the servicer maps it into MotorState.motor{1,2}_load (robot
    frame, PROXIMAL_CMD_SIGN bridge). For a position actuator this stays HIGH when
    a finger is blocked by an object (persistent position error) and drops LOW
    once it reaches its commanded angle freely — the blocked-vs-reached signal
    grip-assist keys on.
    CAVEAT (documented in-code): physics units, NOT the device's 0-1000 PWM p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
    [gripper_servicer.py, simulation.py]
2026-07-28 eval: --grip_assist — load-triggered, posture-preserving fix for under-close
    The policy replays the DEMONSTRATED closing angle, which is where the human's
    fingers sat while PRESSING the object; on a force-blind position servo that can
    stop just short, touching nothing ('parked at angle in air' and 'pressing at
    angle' are indistinguishable to it, and the dataset has no force channel).
    GripAssist intervenes ONLY in that failure state — policy command SETTLED in a
    closing range with LOW load — and then extends closure ALONG THE POLICY'S OWN
    posture direction until load reports contact, bounded by max_extra, the joint
    limits and the servo torque cap. Everywhere else the gripper command pa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
2026-07-28 eval: make --grip_assist convention-agnostic (works with legacy models too)
    Two spots assumed the CURRENT positive-closing convention, so the assist would
    silently never fire for legacy pre-flip models/datasets (which close proximal
    NEGATIVE). The server-side PROXIMAL_CMD_SIGN=-1 bridge does not help here: it
    flips command-in/state-out inside the sim servicer, while the assist runs
    client-side on the model's raw commands.
    - 'closing' detection: displacement MAGNITUDE from the open reference
    (norm), not a signed max -> fires in either convention, and the existing
    unit-direction extension then deepens whichever way that model closes.
    - travel clamp: bound by magnitude preserving sign, ins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
2026-07-28 examples: rewrite the grip characterization tool to measure the load CURVE
    Replaces the earlier version, which had the two client bugs found on the bench
    2026-07-27 (a per-invocation SetTorque that silently wiped the goal, and
    one-shot goal writes that intermittently did not take on one motor) and only
    measured endpoints. Both lessons are now baked in and documented in the
    docstring: torque is enabled ONCE, goals are re-commanded CONTINUOUSLY.
    It also measures the right thing. --grip_assist detects contact from a SMALL
    incremental press, so what matters is the load produced by ~one --assist_step
    past contact, which depends on object STIFFNESS: rigid reacts hard (easy),
    soft just deforms (we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
2026-07-28 examples: fix nan-poisoned summary and aggregate trials across runs
    Two bugs found while measuring on the real gripper:
    - An empty dwell 'tail' slice produced nan loads: over a slow link a dwell can
    yield a single sample (each step costs two network round trips to the Pi), and
    rows[max(1,len//2):] was then empty -> np.median([]) = nan -> one bad step
    poisoned the entire summary (observed: 'early/free |load| nan | max nan').
    Now never slices to empty.
    - The summary only saw the CURRENT invocation, but trials are naturally run one
    object per run (place object, sweep, repeat), so the 'air' floor and the
    objects were never compared. It now aggregates from the JSONL log.
    Measured on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
2026-07-28 eval: grip_assist reads load only after settling, and debounces contact
    No torque sensor: a MOVING finger reads a nonzero motion load regardless of
    contact (measured median ~26, spikes to ~88), so dwell after each increment
    before trusting the reading, and require N consecutive settled readings before
    latching a grasp (or accepting a slip). Adds --assist_dwell_ticks /
    --assist_confirm_ticks (default 2/2).
2026-07-28 eval: detect grip contact as a STALL (lag + load), not load alone
    Load alone is weak: with no torque sensor a MOVING finger draws load anyway.
    Contact is now lag(commanded vs measured) > --assist_lag AND load >= threshold.
    Measured on the gripper at 25% cap: free motion lags 0.002-0.004 rad with load
    0-24; from first contact lag is 0.014 and grows while load climbs 72->250.
    Lag rather than raw velocity/ratio because it is rate-robust (a blocked finger's
    lag grows every tick regardless of loop timing). The load term rejects a limp
    servo, which is also 'not moving'. Falls back to load-only if no measured
    position is supplied.
2026-07-28 examples: closed-loop bench test of --grip_assist on the real gripper (no arm)
    - Stands in for the policy with a deliberate under-close, runs the real
    GripAssist loop against live load/position, reports whether contact was found.
2026-07-28 examples: fix bench-test probe (open pose reads as a stall)
    - Probe now starts past the open pose and dwells before judging: commanding 0
    while the fingers rest slightly off it IS a stall (lag + open-stop load), so
    it reported contact at travel 0 and the run became a no-op.
    - Refuses instead of running when the resulting close would be too shallow.
    - Validated offline against a fake gripper: object -> GRIPPED with the exact
    under-close recovered; clear jaws -> EXHAUSTED.
2026-07-28 eval: grip_assist requires the fingers to be SETTLED before calling contact
    - Transit to a freshly-commanded close lags ~0.09 rad and draws cap current,
    which read as contact on the real gripper (GRIPPED at tick 3, zero top-up).
    - Contact now needs settled (advance < --assist_settle_eps) AND lag AND load.
2026-07-28 eval: grip_assist presses past contact (--assist_squeeze) before latching
    - Contact fires at a light touch (bench: lag 0.0114, load 64, barely over
    threshold) and grip force only persists while commanding past the object.
    - New SQUEEZING state presses --assist_squeeze (default 0.05 rad) further,
    bounded by max_extra and the torque cap, then latches.
2026-07-28 eval: debug logging for grip_assist (reason codes + JSONL trace)
    - Every gate now reports WHY it acted or didn't (open / cmd still moving /
    dwell / stepping / contact confirmed / squeezing / latched / holding / slip /
    no contact within max_extra / disarmed), so a no-show on the arm is
    explainable rather than silent.
    - --log_gripper line adds assist state, offset, lag, advance and that reason.
    - --assist_log FILE appends a per-tick JSONL (model vs sent command, observed
    position, load, state, offset, lag, advance, reason) for offline analysis.
2026-07-28 servers: refuse to start when the port is already served
    gRPC enables SO_REUSEPORT by default, so a second server binds the same port
    with NO error and both instances run. On the real arm that means two servers,
    each with its own interpolator, writing to the same CAN bus and motors — the
    arm shook violently (observed 2026-07-28, two grpc_server_real on :50052).
    - so_reuseport=0 on the real arm server and both sim servers, and the bind
    result is now checked (grpcio returns 0 OR raises RuntimeError) instead of
    being discarded.
    - Refusal message names the hazard and how to find the other process.
    Verified: with reuseport both binds succeed (51999 twice); with the guard the
    second return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
    [grpc_server_real.py, server.py]
2026-07-28 eval: slip detection is load-only (fixes offset ratcheting on the arm)
    Slip reused the 'stalled' test, which requires the fingers to be SETTLED — but
    a gripped finger legitimately keeps creeping while the policy raises its own
    command. On the arm that read as slip three times with load pinned at the cap,
    ratcheting the offset 0.18 -> 0.24 -> 0.30 and tripping the arm's lead guard.
    Slip is now simply: load fell below threshold (still debounced).
2026-07-28 tests: GripAssist regression suite (17 cases, no hardware)
    - Drives the REAL class with synthetic lag/load/advance traces; every case
    corresponds to a failure seen on the bench or the arm (transit-as-contact,
    creep-as-slip, limp servo, noise spike, legacy negative-closing, ...).
    - Adds a 'test' extra (pytest); needs 'eval' too since it loads evaluate.py.
2026-07-28 eval: reopen the gripper on exit, and clamp inside the real joint limit
    - A run ending while gripped (normal end, Ctrl-C, crash) left the servo
    squeezing at the torque cap indefinitely: found at prox 1.387 / load 250 long
    after a killed run. The next episode then starts with the policy observing a
    CLOSED gripper — out of distribution — so it predicts lift/hold instead of
    approach/close. Now an atexit hook reopens to --start_gripper.
    - The assist clamped to the DOCUMENTED limits (1.484/2.025), but the service
    enforces exact radians (85 deg = 1.48353, 116 deg = 2.02458), so those goals
    were rejected. Clamp now keeps a 1e-3 margin inside.
2026-07-28 eval: fix teardown ordering — reopen the gripper before closing the channels
    The atexit hook ran after main() had already closed the gRPC channels, so the
    reopen failed with 'Cannot invoke RPC on closed channel!'. Now ONE idempotent
    teardown reopens the gripper and then releases camera/channels; it is called at
    the end of main() and registered with atexit for abnormal exits.
2026-07-28 docs: --grip_assist as the primary fix for a grasp that barely touches
    - New eval README section: the failure (policy replays the demonstrated angle,
    which is where the demonstrator's fingers sat while PRESSING), what the assist
    does, why the posture is preserved, the stall terms and why each is needed,
    tuning via characterize_grip_load.py, the reason-code log, and the field
    result (raw fails / tuned latch+gain works / assist works untuned).
    - Flag list points to it; notes it supersedes latch_close/commit_close/grip_gain.
2026-07-28 review: match the service's joint limits, tidy GripAssist init, clarify log
    - GRIPPER_LIMITS now mirrors gripette.config (radians(85)/radians(116)); the
    docs' rounded 1.484/2.025 are LARGER than the real limits, so clamping to them
    produced rejected goals. Margin drops to a float32 guard.
    - Test asserts against the service's limits and the float32 wire value.
    - Group GripAssist.__init__ into tunables/state; note why --assist_log reopens
    per tick (crash-safe append).
2026-07-30 Make the ruff gate version-independent
    - Select E4/E7/E9/F explicitly instead of inheriting ruff's default, which
    widened in 0.16 and broke every PR on untouched files (547 errors, none
    of them E* or F* — no correctness findings).
    - Pin `uvx ruff@0.16.0` in CI so the gate only moves deliberately.
2026-07-30 Add the grasp projection: joint angles <-> (strategy, closure)
    - Pure geometry, dataset-independent, exactly invertible (verified 2e-16 on
    real data). Parametric boundary/path exponents default to the plain map so
    they can be fitted later without touching call sites.
    - Recording procedure documented: free-air mimic fits the parameters (object
    data can't - the object truncates the path).
2026-07-30 Set real joint limits and enforce a server-side torque ceiling
    - motor1_max 85 -> 93.5 deg (measured collision). The old CAD value rejected
    the last 8.5 deg, which is where a firm close lives.
    - Torque is now capped at 0.5 server-side, and an unset per-command limit
    resolves to that ceiling instead of full torque. This is what makes the
    raised limit safe: a full close drives into the stop by design.
    - Projection normalises on measured reachable travel, not the command bounds.
    [config.py, grasp_projection.py, service.py, test_grasp_projection.py, test_torque_ceiling.py]
2026-07-30 Accept a goal exactly at the joint limit
    Commanding a full close (93.5 deg = the configured max) was rejected on
    hardware: goals cross gRPC as float32 while limits are float64, so a value
    equal to the limit quantises just above it. Now tolerated (1e-4 rad, well
    under the 0.088 deg encoder step) and clamped rather than refused.
    Matters because decode(s, c=1) targets the limit by design.
2026-08-03 Detect grip events, and adopt a rest-closed recording convention
    - segment_grip() labels frames open/rest/close from intention RAMPS, not
    levels: with an intermediate rest posture, approach and grasp-holding sit at
    similar angles and similar near-zero velocity, so no level test separates
    them. Finds exactly one close in 90-97% of real episodes.
    - Criteria are physical (amplitude + sustained hold), not noise-scaled. Hand
    motion is correlated drift, so bars built from per-frame steps were cleared
    by posture wobble: 250-500 spurious events per dataset.
    - rest_is_closed mode: with rest = full closure, rest and grasp are the SAME
    command, so the one unresolvable ambiguity (relax-to-re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
    [grasp_projection.py, test_grip_segmentation.py]
2026-08-03 Add the dataset converter for the grasp projection
    Rewrites a dataset's gripper channels as (strategy, commanded closure):
    - action gripper cols -> (s, c_target), c_target = 1.0 on a grasp and the
    demonstrated closure everywhere else. So the ONLY change is that the grasp
    becomes a full close; approach and release pass through untouched.
    - observation.state -> (s, c_obs) continuous, so 'am I holding something'
    stays observable (jaws blocked short vs reaching the stop).
    - Strategy is latched across a close: left per-frame it drifts as the fingers
    settle and the commanded target wandered 57-93 deg mid-grasp.
    - Onset refined by slope: the hand creeps during approach, which merged with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
    [grasp_projection.py]
2026-08-03 Switch the strategy coordinate from polar to decoupled
    Measured on 199 real mustard grasps, the polar form (strategy = atan2 angle)
    manufactures variation that is not in the demonstrations:
    - it couples the channels, ds/dv = u/(u^2+v^2), so noise in the small channel
    (distal, 13.6 +/- 14.7 deg) leaks into the shape coordinate, worst near the
    origin i.e. during the approach
    - c=1 scales along the ray, multiplying that noise by k ~ 1/cos(a)
    - net: 35.8 deg of demonstrated distal spread became 96.8 deg of commanded
    spread, x2.71. Decoupled reproduces it at 35.4 deg, x0.99.
    Decoupled normalises each joint independently: closure drives the PROXIMAL
    joint, strategy IS the distal target. Th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
    [grasp_projection.py, test_grasp_projection.py]
2026-08-04 Wire the grasp projection into evaluate.py
    - decode() on the policy's last two channels before latch/gain/assist, so
    everything downstream still operates on angles; result clamped to the
    server's command bounds.
    - observation.state is ENCODED the same way the policy was trained on, since
    feeding raw angles there would be silently out of distribution.
    - Auto-detected from the checkpoint's saved normaliser ranges, NOT names: the
    checkpoint records only shapes ({'action': {'shape': [11]}}), so names are
    gone. Projected channels are 0..1; raw angles reach ~1.6 rad. Verified True
    on the projected checkpoint and False on synthesised raw stats.
    --grasp_projection on|off overrides; the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
2026-08-04 Log the projected gripper channels under their real names
    With the projection active, state[-2:] and the model output are (strategy,
    closure), not angles — so the log printed a firm 60 deg grasp as
    'obs: prox=+0.02', which read as the gripper barely moving. Now prints s/c
    plus the angles they decode to.
2026-08-04 Document the contact guard (--max_target_lead_mm)
    It appeared in no markdown at all. Records what the compromise is, that 80mm
    is the considered default (deliberately above normal tracking lag), and the
    observed failure at 40mm: 25 false contact trips while lifting a near-weightless
    object, ending in a stalled lift. Also notes --max_relative_target 3 vs its
    default of 8 feeding the same loop.
2026-08-04 Pi05 README: bucket mount cannot be /data, and set --save_freq
    - HF now reserves /data for Jobs artifacts when running a local script, so the
    documented mount was rejected outright. Moved to /bucket.
    - Note that --save_freq must be set explicitly: unset, a 20k-step run of a ~3B
    model writes several GB per checkpoint into the bucket.
2026-08-04 Detect the projection on Hub checkpoints, and refuse to guess
    Evaluating a Hub checkpoint is the normal case after a cloud run, and the
    detector only looked at local directories — so it returned undeterminable and
    ASSUMED RAW, which sends a closure of 1.0 as 1.0 radian and silently
    reproduces the under-close.
    - Hub ids: fetch just the normaliser file (a few KB) and inspect it. Verified
    True on the pi05 checkpoint and False on the raw diffusion model on the Hub.
    - Undeterminable now EXITS with an explanation instead of assuming raw. The
    wrong guess here is invisible, so refusing is safer than defaulting.
    Not added: the runtime range check I proposed. Policy outputs pass through the
    un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
2026-08-05 Pi05 README: enable wandb or the loss curve is unrecoverable
    Finished a 12h/$30 run whose losses cannot be recovered: wandb defaults off,
    HF Jobs logs 404 after the job leaves the queue, and nothing but checkpoints
    lands in the bucket. The recipe's own success criterion (eval loss descending)
    was therefore uncheckable.
2026-08-06 Apply the projection on the Ficelle remote path too
    Two bugs that would have hit the first remote robot session:
    - The --policy_addr path builds its observation inline instead of going through
    build_observation(), so it was sending RAW gripper angles to a policy trained
    on (strategy, closure). Silent: no error, just a state channel out of
    distribution. Now encoded in both the 1-frame and 2-frame branches.
    - detect_grasp_projection(None) crashed on _Path(None). With remote inference
    there is no checkpoint to inspect at all, so it now returns None, which the
    caller turns into a hard error demanding --grasp_projection on|off.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
2026-08-06 docs(pi05): explain how to choose --fps and --n_action_steps
    --fps is the LIVE camera rate (Gripette stream_hz 30), not the dataset's
    (Grabette camera_fps 46, declared 50) — two different devices. Also records
    that n_action_steps 15 is inherited from ACT/Diffusion, not tuned for pi05,
    with the measured replan-pause / grasp-commit trade-off.
    Claude-Session: https://claude.ai/code/session_0185xfk84D8sCXWMPmx1cxpp
2026-08-06 simplify: drop the unused polar mode and its dead scaffolding
    The polar parameterisation was kept "for comparison" but had no production
    caller — only its own tests. Removing it takes the boundary/bisection
    machinery, the p/a/b parameters, and `encode_trajectory` (whose nan-filling
    existed solely because polar is undefined at the open pose; the surviving map
    never returns nan). The measurements that ruled polar out stay in the docstring
    so the experiment is not repeated.
    Also fixes two docstrings that had gone stale: `segment_grip` documented a
    `tremor_k` parameter that no longer exists, and `clamp_to_command_limits` still
    claimed commands above 85 deg are rejected after this branch raise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
    [grasp_projection.py, test_grasp_projection.py]
2026-08-06 tests: cover the episode conversion
    The converter decides what the policy imitates and fails silently, but had no
    tests. Covers the full close being commanded, the state staying honest (the
    action/observation asymmetry is the "something is in the hand" signal), the
    strategy latch across a grasp, non-grasp frames passing through, both rest
    conventions, and the output dtype/range contract.
    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
2026-08-10 checks: add the publication gate
    Nothing validated the last stage of the pipeline, so every defect there was
    found from the failure end: identifier task strings reaching a VLA's language
    channel, gripper channels whose representation is undecidable without names, a
    missing git tag surfacing as an unrelated TypeError an hour into training, and
    cards with no viewer link.
    check_publish() runs against a local root (before upload) or a repo id (to
    verify what landed). Metadata-only by default so it is cheap to always run;
    deep=True adds duplicate-frame detection, which is the only way to check the
    real capture rate since the timestamps are synthesised from the declared fps.
    The converter WARNS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
2026-08-10 convert: record the projection calibration in the dataset
    Channel names say WHICH representation a dataset is in; they cannot say which
    CALIBRATION produced it, and decode must use the limits encode used.
    REACHABLE_DISTAL is provisional (torque-capped stall, not a measured stop), so
    re-measuring it would make every existing dataset decode differently with
    nothing recording the change.
    So a conversion now writes meta/grasp_projection.json (representation + limits +
    source) and, if absent, a card carrying the LeRobot and grasp-projection tags —
    the latter queryable from the Hub API, unlike the channel names. check_publish
    cross-validates all three and errors on limit drift or on a file that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
    [grasp_projection.py]
2026-08-10 Add design spec for Orbbec Gemini 305 camera swap
    Driver is vendor risk on the Luxonis OAK-D SR, so the design is a pluggable
    depth-camera interface with the Gemini 305 as a second implementation rather
    than an in-place replacement — the OAK-D path has to stay working to A/B a
    SLAM pipeline that has no ground truth.
    Findings are measured against a real Gemini 305, not taken from the datasheet:
    no IMU, depth is ASIC-rectified (zero distortion) while color is not, depth
    and LEFT_IR stream concurrently at 640x400 with 0us skew, depth_scale is 0.1
    so raw values are 0.1mm, and get_global_timestamp_us is the correct clock.
    Phase 0 is an IMU ablation on existing OAK-D episodes — the 305 has n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
2026-08-10 Record Phase 0 IMU ablation results: PASS
    Ran the ablation on four real episodes (112-446 frames). check_trajectory
    grades GOOD -> GOOD on all four with zero tracking losses introduced.
    The result hinges on a control the original plan did not call for. RTAB-Map's
    F2M odometry is RANSAC-based and this pipeline is not reproducible run to run,
    so the baseline was run twice to establish a noise floor. Camera-local delta
    RMSE for IMU-vs-no-IMU comes out at 0.74-1.03x the IMU-vs-IMU noise floor --
    the IMU's effect on odometry is indistinguishable from rerunning the pipeline.
    The IMU's real role is world-frame convention, in two places (RTAB-Map's
    gravity-aligned init, plus a host-side gravity_al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
2026-08-10 Verify Config A on hardware: rectification and depth scale confirmed
    Recorded a 305 sequence straight into the oak/ layout and ran it through the
    production offline_vslam image. Tracking was 100% on 1801 frames with no IMU,
    which confirms the plumbing, but the decisive evidence is a falsifiable stereo
    check rather than the trajectory: predict disparity fx*B/Z from each depth
    value and score the LEFT_IR patch against RIGHT_IR there.
    raw * 0.1 -> mm (the design) mean NCC 0.8754
    raw unscaled (10x) mean NCC 0.0782
    raw * 0.01 (0.1x) mean NCC 0.0125
    Both sharpness sweeps peak exactly at zero. So LEFT_IR is the rectified left
    image, row-rectified against RIGHT_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
2026-08-10 Gemini 305 grades GOOD at realistic Grabette pace
    Third capture finally hit the target: 3.84 mm/frame (OAK-D band is 3.38-4.54),
    0.33 m median depth, 65.5% valid. Graded GOOD with zero jumps, reproducibly
    across two runs. The first two captures were invalid -- one moved 3-4x too fast
    at room scale, the other was stationary -- so motion is now verified from pixel
    statistics before any grade is trusted.
    Run-to-run local-delta RMSE is 2.184 mm on a 3.968 mm step, matching the OAK-D
    noise floor from Phase 0 (2.309 on 3.715). The non-determinism is the pipeline's,
    not the camera's.
    The one deficit is 97.8% vs 100% tracking, and it is fully explained: the 30 lost
    frames are a single contiguous 1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
2026-08-10 Phase 1: pluggable depth-camera interface
    RpiBackend talked directly to OakdCapture, so the rig was single-sourced on
    Luxonis at the code level as well as the supply level. Extract the contract it
    actually depends on -- 10 members -- into a DepthCameraCapture Protocol, and
    select the implementation from a new depth_camera config field.
    OakdCapture satisfies the Protocol unchanged; it was extracted from that class
    rather than imposed on it. Only _init_oakd() and the two construction sites
    changed. Keeping the OAK-D path alive is required, not incidental: the SLAM
    pipeline has no ground truth, so validating the 305 means A/B-ing it against
    OAK-D recordings of the same motion.
    Deviation from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
2026-08-10 Record SLAM Space deployment gap and correct the encoding plan
    SLAM runs in the pollen-robotics/grabette-slam Space, not on the Pi. That Space
    vendors a full copy of grabette-postprocess, including its own
    offline_vslam.cpp. Verified by fetching it: the Space copy still has the
    unguarded calib["imu_to_cam"] at line 108, so an IMU-free Gemini 305 episode
    pushed through /api/hf/slam would abort with type_error.302 despite this repo
    being fixed. The fix must be propagated and the Space rebuilt.
    Flagged as a standing hazard rather than a one-off: Phase 2 changes to
    convert.py or checks/* need the same propagation, and nothing in this repo
    fails when the two copies drift.
    Also corrects the Phas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
2026-08-10 Retire both Pi-side unknowns: SDK streams, encoding is cheap
    Validated on grabette-01 (Pi 4B Rev 1.5, Trixie, Python 3.13.5, USB 3.2).
    pyorbbecsdk2 2.1.1 installs from a real aarch64 wheel for 3.13 with no source
    build, and streams 640x400@30 depth+LEFT_IR at 29.90 fps for 30s with ~0 dropped
    frames and 0 timeouts.
    One install blocker found: the device enumerates but will not open
    ("usbEnumerator openUsbDevice failed!") because nothing installs an Orbbec udev
    rule -- only 80-movidius.rules exists, from make install-udev-oak. The SDK ships
    99-obsensor-libusb.rules with an explicit entry for PID 0840; installing it
    yields crw-rw-rw- root video plus a /dev/Gemini_305 symlink and the device
    op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
2026-08-10 Phase 2: OrbbecCapture, validated on Pi hardware
    hardware/orbbec.py mirrors OakdCapture and satisfies the same Protocol. Run on
    grabette-01 against the real camera: 600 frames in 20s at 30.02 fps, with mp4
    frame count, left timestamps and depth timestamps all agreeing at 600. Depth
    decodes from the FFV1 mkv as uint16 millimetres (median 1.047m, max 6.519m) with
    no 65535 markers surviving -- the silent-corruption case this was written to
    avoid. End to end through convert.py and the patched offline_vslam: "No
    imu_to_cam ... using identity", 600/600 tracked, GOOD. That run was stationary,
    so it validates plumbing rather than trajectory quality, which the paced
    workstation capture already establ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
    [orbbec.py]
2026-08-11 Make episode checks tolerate an IMU-less camera
    check_recording rejected every Gemini 305 episode twice over: a missing
    oakd_imu.json was a hard error, and imu_to_cam was a required calib key. Both
    are legitimately absent for a camera with no IMU, and offline_vslam already
    probes for imu_to_cam with contains().
    Relaxed both, without weakening the OAK-D case: a present-but-empty
    oakd_imu.json still errors on missing accel/gyro, so a genuinely broken OAK-D
    capture is caught exactly as before. Added a test pinning that distinction,
    since it is the part that is easy to lose.
    Two existing tests encoded the old contract and were updated to the new one
    rather than deleted, and the aggregate empty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
2026-08-12 Record pre-merge TODO: generic camera naming in the dashboard
    The UI hardcodes "OAK-D" in five status badges, the toggle button, two 501
    messages and two endpoint docstrings. Requested before merge: show whichever
    depth camera is configured instead.
    Notes the clean seam -- routers/oakd.py::_status() already returns the payload
    the dashboard polls, so adding a model/label field there lets the UI name itself
    without a new endpoint -- and records what is deliberately NOT in scope: the
    /api/oakd/* route paths and the oakd_* filenames, since renaming either breaks
    external consumers and belongs in its own PR with a shim.
2026-08-12 Fix frame drops, wrong clock and idle CPU burn in OrbbecCapture
    First recordings through the daemon -- the first time OrbbecCapture ran with
    picamera2 encoding concurrently -- dropped 71% of depth frames (8.61 fps against
    the OAK-D's 30.02 with zero drops) and pushed the Pi into thermal throttling. The
    standalone bench had passed at 30 fps because nothing else was running; the
    "margin, not a measurement" caveat recorded earlier turned out to matter.
    Three bugs, all introduced by this work:
    1. Frame drops. Per frame the acquisition thread did a 640x400 uint16 PNG encode,
    a float32 depth conversion allocating 1 MB and walking it four times, and a
    mask cast recomputed every frame for a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
    [orbbec.py]
2026-08-12 Share one Orbbec Context per process instead of one per init
    ob.Context() is not a cheap handle: each spawns a device-watcher thread and
    native state that is never released when the Python object is dropped. Because
    the keepalive powers the camera down after each capture and re-initialises it
    for the next, the daemon was building one per cycle -- "Create
    PollingDeviceWatcher" appeared 16 times in a single session. Now created once
    and reused, which took that to 1 per run and stabilised the thread count.
    This is a partial fix for a larger problem, recorded in the spec rather than
    overclaimed: daemon RSS still grows ~27 MB per enable/disable cycle and reaches
    1.66 GB in normal use, at which p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
    [orbbec.py]
2026-08-12 Record try3: 5/5 GOOD on a clean daemon
    Five dashboard recordings after restarting the service. 28-28.8 fps with 5.4% of
    depth frames dropped, against 71% before the fixes and 41-49% on the bloated
    daemon. All five graded GOOD, with median step 5.0-6.3 mm -- just above the
    OAK-D reference band, so the motion is representative rather than the
    stationary case that grades GOOD trivially.
    Noise floor measured on 131919: 3.264 mm local-delta RMSE on a 5.211 mm mean
    step, the same order as the OAK-D's 2.309/3.715. The pipeline's
    non-determinism is a property of RTAB-Map, not of the camera.
    The two episodes that lost tracking did so for a diagnosable reason rather than
    a defect: depth coverage co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
2026-08-12 Add opt-in IR exposure control for the Gemini 305
    try4 moved the scene to a textured kitchen worktop and the depth-starvation
    failure went away: coverage rose from 61-69% to a 73% mean and stayed at 66-75%
    even inside the tracking-loss bursts, where try3 had collapsed to 17%. The
    limiting factor changed rather than disappeared -- losses now correlate with a
    drop in image sharpness while depth stays healthy, i.e. motion blur.
    The camera explains why: default AE picks ~15.6 ms of integration with gain at
    its floor of 16, nearly half the 33 ms frame interval, because it optimises for
    low noise. Manual control works (verified: exposure reads back correctly once
    OB_PROP_IR_AUTO_EXPOSURE_BOOL is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
    [config.py, main.py, orbbec.py]
2026-08-12 Record try5: 100% tracking on all six episodes
    Two batches of three in the kitchen scene on a freshly restarted daemon. 6/6
    GOOD with 100% tracking on every episode -- zero losses across 1,256 frames --
    at 3.6-7.0 mm median step, which brackets the OAK-D reference band, and with
    drop rates matched between batches at 4.2-4.6%.
    The exposure A/B did not actually run. The feature touches four files and only
    orbbec.py had ever been copied to the Pi, which was still at 4911872, so
    GRABETTE_ORBBEC_IR_EXPOSURE_US was silently ignored -- pydantic-settings drops
    unknown env vars without complaint. try5b is therefore a second auto-exposure
    batch, which turns the pair into a repeatability check instead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
2026-08-12 Fix daemon memory growth: cap glibc malloc arenas
    RSS reached 1.66 GB in normal use and capture degraded with it -- 41-49% of
    depth frames dropped at 15-17 fps, against 1.3% at 29 fps on a fresh daemon.
    Not a leak. Cycling OrbbecCapture standalone under tracemalloc showed the Python
    heap flat at 4.2 MB across 8 cycles, gc objects +3, and the writer thread
    exiting cleanly each time -- while RSS still climbed. malloc_trim(0) then handed
    back 6-8 MB per cycle and held RSS at a plateau, which is the signature of
    memory the application freed and the allocator kept.
    The capture threads churn ~1 MB of numpy buffers per frame at up to 30 fps, and
    glibc retains freed memory in per-thread arenas: up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
2026-08-13 Multi-device start from one device
2026-08-13 Prevent device from deco at stop
    [main.py, relay_client.py]
2026-08-13 Ease recording chaining
2026-08-13 Sync stop END OF SHORT POLLING
    [button_listener.py, capture_scheduler.py, fleet_sync.py, main.py, relay_client.py]
2026-08-13 Use device token to push
2026-08-13 Modify LED for group
2026-08-13 Add blinking led on stop
2026-08-13 Add battery to heartbeat
2026-08-13 loop for battery
2026-08-13 Try fix dashboard access
    [daemon.py]
2026-08-13 Modify relay space
2026-08-13 epsiodes infos saved by the device
2026-08-13 Modify led blinking
2026-08-13 Fix fixed led when should be blinking
    [button_listener.py]
2026-08-13 fix led on init
    [button_listener.py]
2026-08-13 Inline edition + signature lock + propagate edit to devices
2026-08-13 Modify logout button
2026-08-13 report device activity
2026-08-13 Fix new test import
    [main.py]
2026-08-17 Record the same-scene A/B: Gemini 305 matches OAK-D on quality, not margin
    Four episodes per camera, same kitchen scene, same pace, cameras physically
    swapped, daemon restarted between batches, arena cap active for both, episode
    shapes matched.
    Trajectory quality is indistinguishable: 4/4 GOOD both, and the Gemini tracked
    100% of every episode while the OAK-D lost one frame. Median steps overlap.
    The OAK-D's advantage is margin rather than accuracy: 0.0% frames dropped
    against 4.0%, an exact 30.00 fps against 28.6-29.0, ~5 fps more Arducam
    headroom, and 6.7x the image sharpness. All of that traces to one cause -- it
    encodes on its own ASIC so the Pi does less work, and its shorter exposure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
2026-08-17 Name the configured depth camera in the dashboard
    The UI hardcoded "OAK-D" in the status badge, the toggle button and two 501
    messages, so a device running a Gemini 305 reported an OAK-D to the operator.
    Wrong-but-plausible labels are the expensive kind once two cameras behave
    differently.
    The name is now served by the API rather than mapped in the UI, so there is one
    authoritative source: hardware/depth_camera.py owns DISPLAY_NAMES and a
    display_name() fallback, RpiBackend exposes depth_camera_model, and
    /api/oakd/status returns model + label. The badge, button and messages read that
    label and so cannot drift apart.
    Deliberately unchanged: the /api/oakd/* route paths and the oakd_* filena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
    [camera.py, depth_camera.py, oakd.py]
2026-08-17 Fix stale anchor name in check_dataset's not-found message
    Changing the episode anchor to oakd_left.mp4 left the failure message still
    naming oakd_imu.json, so a run that found nothing pointed at the wrong file.
    That exact message is what made a 305 batch look like a missing-IMU problem
    earlier in this work.
2026-08-17 Rename episode depth-camera files oakd_* -> dcam_*, readers accept both
    A Gemini 305 recording was writing files called oakd_left.mp4, oakd_imu.json and
    oak_mask.png -- naming the episode after hardware that produced none of it. The
    canonical prefix is now dcam_ ("depth camera"), which is true whichever camera
    recorded it.
    Compatibility is the whole design. Episodes recorded before this use oakd_*, and
    plenty are already on the Hub; they are NOT being rewritten. Every reader goes
    through episode_files.resolve(), which prefers the canonical name and falls back
    to the legacy one, so both layouts process identically. metadata.json's per-
    stream stats key moves from "oakd" to "dcam" with the sa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
    [episode_files.py, oakd.py, orbbec.py, replay.py]
2026-08-18 Record the dcam_ rename and the Space propagation near-misses
    Documents the chosen option (neutral names, readers accept both) against the
    three alternatives, why the resolver is duplicated across the two packages, and
    the real-data verification of both layouts.
    Also records the three things that diffing each vendored Space file against
    develop caught, which a bulk copy would have broken: a deliberate lerobot==0.5.1
    pin, a 561-line dataset.py fork against that pinned API, and a README that
    diverges on purpose. Plus a fourth in the Space's own pipeline.py, which
    hardcoded the legacy discovery anchor and would have made every new dcam_
    episode silently invisible.
2026-08-18 Record which depth camera produced an episode
    The dcam_* rename made filenames vendor-neutral, which removed the only (if
    accidental) signal of which camera recorded an episode. Nothing else filled the
    gap: metadata.json was structurally identical for both, and dcam_calib.json
    identifies the camera only in vendor-specific schemas -- productName on an
    OAK-D, name on an Orbbec -- so no consumer could read it uniformly. The
    remaining signals were inferences from symptoms: a dcam_right.mp4 or a
    dcam_imu.json or an imu_to_cam key implied an OAK-D.
    That matters now rather than later, because datasets are about to mix both
    cameras, and they differ in ways that affect the data: the Gemini has no IM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
2026-08-18 Keep meaningful nulls in the depth_camera metadata block
    The previous commit claimed the Gemini records "imu": null so the absence of an
    IMU is stated rather than inferred. It did not: rpi.py filtered None out of the
    block, so the one field carrying that signal was silently deleted. A live
    capture showed depth_camera with no imu key at all.
    Each camera now decides for itself. Both omit fields they could not read -- so a
    null that survives means "known to be absent", not "we did not look" -- and the
    Orbbec adds "imu": None deliberately. rpi.py no longer filters.
    The existing test missed this because it checked camera_info() on the capture
    class, where the value was always correct; the fault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
    [oakd.py, orbbec.py]
2026-08-19 Add calibration process to Readme.
2026-08-19 Show error on oak_calib_offline missing
    [button.py, button_listener.py, capture_scheduler.py, daemon.py, episode_check.py, hf.py]
2026-08-19 Fix error for angle sensors
    [errors.py, main.py, test_hardware_error.py]
2026-08-19 Set the LE advertising interval explicitly
    btmgmt's "add-adv" carries no interval, so the kernel applied its own
    default of 0x0800 (1.28s). At that rate a central not only discovers the
    robot erratically, it cannot connect at all: a connection is only ever
    opened in answer to an advertisement, so the attempt times out and is
    cancelled locally (le-connection-abort-by-local) with the robot never
    seeing it — the Pi's journal stays empty while Chrome reports "Connection
    attempt failed", then "Bluetooth Device is no longer in range" once BlueZ
    evicts the device it could not reach. The interval was lost when
    advertising moved to the btmgmt path to work around the kernel-6.18
    extended-advertising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
    [test_bluetooth_advertising.py, test_bluetooth_bond_deadlock.py]
2026-08-19 Stop the connect path from hiding, and mis-reading, failures
    Three defects found while chasing the advertising-interval bug, each of
    which made that bug harder to see than it needed to be.
    The web client retried a failed GATT connect five times. It cannot work:
    a failed connect makes BlueZ evict the device, so the handle is dead and
    only a fresh requestDevice() — a new user gesture — can replace it. The
    four doomed retries then overwrote the one informative error with "no
    longer in range". Retry only while the handle is live, and say plainly
    that the entry expired. The Connect button also stayed enabled while
    connecting, so a second click opened a second chooser whose scan aborted
    the c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
    [test_bluetooth_bond_deadlock.py]
2026-08-19 Stop the BT tool burying the real connection error
    Retrying a failed GATT connect cannot work: the failure makes BlueZ evict
    the device, so the handle is dead and only a fresh requestDevice() — a new
    user gesture — can replace it. The five attempts therefore ended in four
    doomed ones whose "Bluetooth Device is no longer in range" overwrote the
    message that actually explained the failure. Retry only while the handle
    is live, and say outright that the entry expired.
    The Connect button also stayed enabled while connecting, so a second click
    opened a second chooser whose scan aborted the connection already in
    flight; disable it for the duration.
    Straight to main because the Pages deploy on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
2026-08-19 casquette: fix BMI088 gyro I2C address (0x68 -> 0x69)
    The default-low gyro address 0x68 collides with the PiSugar DS3231 RTC on the Casquette HAT stack, so IMU init read the RTC chip id (not the gyro's) and RpiBackend refused to record. Hardware-validated on casquette.local: the old bimanual build (0x69) records; the monorepo's 0x68 failed IMU init. Matches the fix already on the old casquette bimanual branch.
    [bmi088.py]
2026-08-19 casquette: background the ffmpeg mux; add DEBUG stop-phase timing
    Restores the faster-stop behavior the old bimanual build had (lost when casquette moved to the monorepo): stop() now muxes on a daemon thread so it no longer blocks the stop path / the next recording. A class-level thread registry warns when back-to-back captures stack muxes (CPU contention on the Pi Zero 2W). Per-phase timing in camera.stop() and RpiBackend.stop_capture() is re-added at logger.debug (off by default; CASQUETTE_LOG_LEVEL=DEBUG to enable).
    [camera.py]
2026-08-19 casquette: fleet foundation - config/deps + Backend warmup & sync-metadata hooks
    Groundwork for the copy-first fleet client: relay config (stable persisted device_id, relay_url, relay_enabled, device_name), aiohttp + huggingface-hub deps, Backend.prepare_capture() (pre-T0 warmup, default no-op) and set/get_sync_metadata() folded into metadata.json at stop in mock + rpi backends.
2026-08-19 casquette: add fleet/ subpackage (relay_client, capture_scheduler, cancel, wifi, auth)
    Copy-first prototype of the device-side fleet client, copied with a clean seam from grabette (develop @0cb3453) into a self-contained casquette/fleet/: relay_client (config + providers fully constructor-injected, only imports/logger changed), capture_scheduler (verbatim), cancel (verbatim), wifi (trimmed to get_route_ip/get_current_ssid), auth (minimal PAT-only; grabette's OAuth/refresh deferred). Each file carries a provenance header for the later shared-package extraction. Not yet wired into the app; record store + command dispatcher + lifespan wiring come next.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
2026-08-19 casquette: fleet record store + command dispatcher + relay wiring (recording peer)
    Phase 2-4 of the copy-first fleet prototype: casquette now joins the cloud fleet as a pure recording peer. task.py = grabette's TaskManager record store (Task/Session/Episode, tasks.json, T0-derived episode_id_for, members/signature, report_tasks/revision), copied+adapted (angle/OAK-D stripped) + get_task_manager() singleton. app/main.py = _handle_relay_command dispatcher (recording subset: get_state, cancel_dataset, prepare/start/stop_capture, delete_episode, edit/delete_task, set_episode_members, logout; upload_episodes/process_dataset deferred) + RelayClient wired into the lifespan (no button; PAT auth; no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
2026-08-20 Expect a right video only from cameras that record one
    check_dataset warned "missing dcam_right.mp4" on every Gemini 305 episode.
    That camera streams LEFT_IR + Depth only, so the file is legitimately absent
    — the same kind of absence already handled for the IMU, reported instead as
    a defect. A permanent warning on every recording is how a checker gets
    ignored.
    require_right now defaults to None, meaning derive it from the episode. The
    discriminator is the recorded per-stream stats rather than a table of model
    names: oakd.py always writes right_frames, orbbec.py never writes the key,
    so an unseen camera classifies itself. An OAK-D whose right stream failed
    still reports right_frames: 0, so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
2026-08-20 casquette: implement upload_episodes fleet command
    Casquette can now push its recorded streams to the shared raw HF dataset under {episode_id}/{role}, so the fleet dataset build includes the casquette (previously returned 'unknown command'). Adds fleet/hf.py (HuggingFaceClient copied from grabette + get_hf_client singleton) and the upload_episodes dispatcher handler (per-episode cancel checkpoints, thread-offloaded uploads); advertises the capability. process_dataset remains the one deferred command. +2 dispatcher tests (mocked HF client).
2026-08-24 casquette: export frame_timestamps.json per recording
    Per-frame video timestamps (same format grabette writes) so the post-process can align casquette's POV frames onto the bimanual episode timeline precisely. Existing raw episodes without it still work via the builder's fps-derived fallback; this just improves accuracy for future recordings.
2026-08-24 pipeline: add the grasp projection step, and name the representation
    run_pipeline.sh chained clean -> deltas -> QA -> resize and then printed a
    train.py command, so anyone following its output trained on RAW gripper angles
    and got the under-close back, with nothing saying so. The projection was
    documented only in docs/grasp_projection.md and wired into no procedure.
    --grasp-projection now runs the converter as the last prep step and points the
    generated train command at the projected dataset. The final banner states the
    gripper representation EVERY time, and when it is raw it says what that costs
    and gives the command to fix it — getting this wrong is silent in both
    directions.
    The stats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
2026-08-24 docs(pi05): point the procedure at the projected dataset
    The README's Requirements said the dataset comes from run_pipeline.sh and its
    commands used <dataset>_cartesian in five places — the UNPROJECTED output — so
    following it verbatim trained pi05 on raw gripper angles and reproduced the
    under-close. The eval examples were also missing --grasp_projection, which the
    remote path requires explicitly.
    Names the projection requirement in Requirements, switches the training and
    gate commands to _graspproj, adds --grasp_projection on to both eval examples,
    and documents that flag and --grip_torque_limit alongside the other
    deployment settings.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
2026-08-24 Adapt sound from other project
    [config.txt]
2026-08-24 Add sound for failure
    [button_listener.py, capture_scheduler.py, sound.py, test_speaker.py]
2026-08-24 casquette: mitigate camera frontend-timeout wedge (event-loop starvation)
    Root-caused to an intermittent asyncio event-loop stall >1s starving picamera2 (bare rpicam-vid records 90s clean; only the app wedges; camera hardware is healthy). Three mitigations: (1) daemon._poll_loop runs backend.get_state() via asyncio.to_thread — it does blocking BMI088 I2C reads at idle, and inline on the loop those stall everything; (2) picamera2 buffer_count=8 for headroom against brief stalls before the 1s dequeue timeout; (3) rpi.stop_capture fails LOUD on 0 frames (ERROR log + camera_ok=false in metadata) so a wedge never silently ships a 0-frame clip (which is what silently dropped one episode from the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
    [camera.py, daemon.py]
2026-08-25 Revert "Try debug sound"
    This reverts commit 51197342b76303b4dfbfc1779f0b67731231163a.
    [sound.py, test_speaker.py]
2026-08-25 Revert "Try fix regression"
    This reverts commit 0ed9bbb07f843332c16470effb61be196babd847.
    [sound.py, test_speaker.py]
2026-08-25 fix 3D printing guide
2026-08-25 fix(pipeline): run on bash 3.2, and stop recommending a Hub id for the stats pass
    Two fixes to run_pipeline.sh.
    1. Empty arrays under `set -u`. bash 3.2 — still the default /bin/bash on
    macOS — treats "${EMPTY[@]}" as unbound and aborts:
    run_pipeline.sh: line 148: RAW_ROOT_ARG[@]: unbound variable
    Hit on a Mac by any run that omits --raw-root (a Hub dataset), i.e. the
    documented common case. Now expanded as ${A[@]+"${A[@]}"}, which is safe on
    3.2 and >= 4.4 and preserves arguments containing spaces (verified).
    2. --projection-repo-id defaulted to the raw input's Hub id, and its help said
    the id "must resolve on the Hub". Both wrong: LeRobotDataset only queries the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
2026-08-25 casquette: add opt-in event-loop lag watchdog (camera-wedge diagnostic)
    Diagnostic to find the mechanism of the intermittent CSI camera frontend-timeout wedge. Controlled experiments implicate the fleet relay (relay-off soaks clean; the one wedge was relay-on), but the bug is intermittent so soak-counting can't confirm it. This watchdog measures event-loop/main-thread stalls directly: it sleeps 100ms and logs a WARNING when actual elapsed exceeds tick by >0.5s — i.e. the main thread (or GIL) was blocked long enough to starve picamera2's buffer recycling. Opt-in via CASQUETTE_LOOP_WATCHDOG=1, negligible cost, off by default.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
    [main.py]
2026-08-25 Document Gemini 305 setup in the README
    The only Gemini mentions on this branch were an internal design spec and the
    file-format doc, so bringing one up meant reading the Makefile to discover
    install-orbbec-sdk and hand-editing /etc/grabette/env. Nothing told you the
    camera also has to be toggled on in the dashboard.
    Adds an Install subsection with the four steps, what a successful start looks
    like, what to check when the device is not found, and the two behavioural
    differences that change how you record: no IMU, and passive stereo needing a
    lit textured workspace.
    Also adds a Hardware table row, since that table listed the OAK-D as the only
    depth camera and as 'required'.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
2026-08-25 casquette: watchdog can enable asyncio debug to name loop blockers
    CASQUETTE_ASYNCIO_DEBUG=1 turns on asyncio debug + slow_callback_duration=0.5 so the event-loop stalls the lag watchdog detects get attributed to a named callback — pins the exact relay operation blocking the main thread.
    [main.py]
2026-08-25 casquette: cut relay memory footprint to stop swap-thrash camera wedge
    Root cause of the intermittent CSI camera frontend-timeout wedge: memory pressure on the 512MB Pi Zero 2W. The fleet relay adds ~37MB resident (aiohttp + huggingface_hub); with the desktop GUI + camera buffers the device had only ~126MB free and was actively swapping (zram). Under pressure the kernel's synchronous direct reclaim froze the main thread multiple seconds (watchdog caught 7.71s), past picamera2's 1s dequeue timeout -> frontend wedge. Confirmed by free/vmstat + a reproduced cold-boot wedge with named stalls. The old standalone build had no relay (fit in RAM); the grabette is a Pi 4 (ample RAM) -> neither wedged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
    [camera.py, main.py]
2026-08-25 Update gripette assembly guide
    Correct servos IDs
    Add link to BOM page 4
    Add link to github "motor setup" link
2026-08-26 Add a Hugging Face documentation site
    Five hand-written pages built with upstream hf-doc-builder, matching the
    setup Reachy Mini uses (huggingface.co/docs/reachy_mini): a landing page,
    getting started, the dashboard, the two Hugging Face Spaces, and an FAQ.
    Preview locally with:
    uvx --from "hf-doc-builder @ git+https://github.com/huggingface/doc-builder.git@main" \
    doc-builder preview grabette docs/source --not_python_module
    --not_python_module is required: doc-builder otherwise tries to import a
    `grabette` module for version detection, which this workspace doesn't
    expose at the top level. No [[autodoc]] is used, so nothing needs to be
    installed to build the docs.
    Nothing is publ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
2026-08-26 Reduce sound and fix error signal
    [sound.py]
2026-08-26 Wire up the Hugging Face documentation CI
    Three workflows calling the upstream doc-builder reusable workflows, the
    same way reachy_mini does:
    - build_pr_documentation.yml builds docs/source on any PR touching docs/
    - upload_pr_documentation.yml publishes it and comments the preview URL,
    https://moon-ci-docs.huggingface.co/docs/grabette/pr_<n>
    - build_documentation.yml publishes on push to develop and on release
    Differences from the reachy_mini setup:
    - additional_args passes --not_python_module. There is no [[autodoc]] here
    and no importable top-level `grabette` module, so the build would fail on
    ModuleNotFoundError otherwise. CI branches on this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
2026-08-26 Fix unaudible error sound
    [sound.py]
2026-08-26 back on official relay
2026-08-27 feat: chunk-relative action math (P1 of the relative-actions plan)
    Absolute pose chunks <-> offsets from the chunk's first pose, COMPOSED into that
    pose's frame rather than subtracted:
    a_i = R_ref^-1 (p_i - p_ref) A_i = R_ref^-1 R_i gripper passthrough
    That composition is what makes it origin-invariant, which matters because SLAM
    gives every episode an arbitrary origin: (R_g R_ref)^-1 R_g (p_i - p_ref) reduces
    to R_ref^-1 (p_i - p_ref). Property-tested under random rigid re-origins and
    under a yaw sweep, with a companion test asserting the naive subtraction FAILS
    the same check, so the invariance test cannot go vacuous.
    Jumps are REPAIRED, not masked or dropped: pi0/pi05 ign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
2026-08-27 feat: splice orientation jumps too, and record why the delta pipeline is safer
    Rotation glitches are real in this data: convert_dataset.py's --despike_max_deg
    was lowered from 45 to 5 because 5-45 deg glitches reached training, "the policy
    reproduced them at eval, amplified through the widened r6d normalization ranges,
    and tripped the arm server's IK-jump watchdog". So repairing translation alone
    was a regression against the existing pipeline, not just an incomplete feature.
    splice_rotation_jumps() applies the same repair in SO(3): per-step relative
    rotations R_i^-1 R_{i+1} above 5 deg are replaced by the median of the valid
    steps and the sequence rebuilt by composing forward. The median is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
2026-08-27 Tell an http:// page it needs a secure address, not a new browser
    Web Bluetooth is hidden unless the page is a secure context, so serving
    this file over http://<host>:<port> — the obvious way to try a local edit,
    or to open the tool from the robot itself — leaves navigator.bluetooth
    undefined. The existing check read that as an unsupported browser and told
    a perfectly capable Chrome to "open this page in Chrome or Edge", which
    cannot help.
    Test isSecureContext first and give the one action that works: a link to
    the published page, plus the localhost URL for anyone testing a local
    copy. The port comes from location.port, so the hint names whatever port
    is actually being served rather tha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
2026-08-27 feat: chunk-relative processor steps, and measure the real jump rate (P2)
    The lerobot shell around the maths: ChunkRelativeActionsStep (forward) and
    AbsoluteFromChunkRelativeStep (inverse), both registered so a saved pipeline can
    name them.
    Design points:
    - the reference is the chunk's FIRST action, not observation.state, which keeps
    the state gripper-only — no absolute SLAM pose in the policy input
    - the inverse accepts an explicitly set reference, because at deploy time it is
    the robot's MEASURED pose and no forward step has run; it refuses to guess
    - a (B, D) single-step action passes through the forward step untouched: at
    inference there is no chunk to be relative to
    - rot="r6d"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
2026-09-01 Document the Linux pairing-agent trap
    First contact always needs a pairing, and a host whose desktop agent
    declines it leaves the tool connecting and dropping forever with no useful
    error — indistinguishable from a broken robot. Cost most of a debugging
    session to identify; the fix is one bluetoothctl incantation nobody would
    guess. Seen on Ubuntu GNOME, so not an exotic setup.
    Describes the symptom and the fix without asserting a mechanism: the
    capture showed the host advertising IO capability KeyboardDisplay, so an
    agent WAS registered — it simply did not confirm, and why is unexplained.
    The steps start from a scan, so they work for a robot that has never been
    on the network: over th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
2026-09-01 Carry the connect-path guards onto the rewritten BT page
    These exist on main (3062878) but were written against the old page, so the
    rewrite arrived without them and a develop -> main release would drop them.
    the device, so the handle is dead and only a fresh requestDevice() can
    replace it. The doomed retries also overwrote the one error that explained
    the failure. Stop on a dead handle and say the entry expired.
    Disable the search button while connecting, too: a second click opens a
    second chooser whose scan aborts the connection in flight. Re-enabled
    unconditionally, because while connected the picker is hidden rat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
2026-09-02 test: pin the step's position in the real pi05 pipeline, and record the costs
    The unit tests used a synthetic one-step pipeline, so the insertion point was
    unproven. test_chunk_relative_pipeline.py now covers the two properties that
    would otherwise fail silently:
    - POSITION, asserted against the shipped factory SOURCE rather than a comment:
    relative before NormalizerProcessorStep on the way in, unnormalize before
    absolute on the way out. A lerobot bump that reorders the pipeline now breaks
    a test instead of a training run.
    - RANGE, through the real prefix with QUANTILES normalisation: our step +
    relative stats give [-1.27, +1.20] with 98% inside [-1, 1]; the same stats on
    absolute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
2026-09-02 docs: record the P4 dataset build and its verification
    There is no raw 8D pick3 on the Hub (every 8D dataset is single-task), so the
    A/B dataset was assembled locally from the baseline's three ancestors. It comes
    out identical to pick3_graspproj_480 where it must: 554 episodes / 91123 frames,
    and 166/199/189 per task. Built under ~/grabette-work/pick3_raw8d_chunkrel,
    nothing existing touched, no convert_dataset step.
    Records two prep facts that are easy to get wrong:
    - the sources carry identifier task strings, so the relabel to the language
    forms is keyed on the source identifier and raises rather than guesses;
    mapping by merge position would silently mislabel which object an episode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
2026-09-02 fix: strip stale action-stats provenance when converting
    Found while building the projected chunk-relative dataset. The converter copies
    the source tree wholesale, so a source carrying chunk-relative action stats
    passed its `action_relative_meta` marker to the copy — while the conversion had
    just recomputed `action` for the new gripper channels, i.e. as ABSOLUTE stats.
    The result is a dataset that claims relative stats while holding absolute ones.
    The training guard keys on precisely that marker, so the stale copy would have
    made it PASS on a mis-normalised dataset: the guard defeated by the thing it
    guards against.
    The converter now drops `action_relative_meta` and `action_absolute` aft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
2026-09-02 feat: run chunk-relative checkpoints on the robot
    evaluate.py could train chunk-relative policies but not execute them. Adds the
    eval side:
    - ChunkRelativeDeltas turns a chunk's offsets into the body-local deltas
    SendCartesianDelta expects. The server composes
    delta_pos_world = R_target @ delta_pos and R_target_new = R_target @ R_delta,
    so the chunk's reference pose cancels in the difference and the arm never
    needs to be told what it was.
    - --chunk_relative {auto,on,off}. auto is exact rather than heuristic: it reads
    the registered step names out of policy_preprocessor.json. It refuses to
    guess, like --grasp_projection, and the action width is cross-checked against
    the checkpo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
2026-09-02 feat: make the offline gates work on chunk-relative checkpoints
    smoke_generation.py --chunk_relative. Two reasons the gate could not just run
    as-is on such a checkpoint:
    - Relative action 0 is identically zero in all six pose dims, because the
    reference IS the chunk's first action. So comparing two episodes'
    select_action() outputs reports "input-INDEPENDENT" however good the policy
    is — a false failure on the gate's central check. It now predicts the whole
    chunk and drops action 0 before differencing.
    - The checkpoint's postprocessor ends with the inverse step, which needs a
    reference pose only the robot has. Stripped, as in evaluate.py.
    Check 3 also gets sharper: the ground-t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
2026-09-03 fix: measure task sensitivity against a sampling-noise floor
    The --task2 probe compared the task effect against the scene effect, which
    cannot tell a real effect from resampling. pi05 is a flow model: the same input
    does not give the same output twice. The README already records why this matters
    — our 3-task pi05 moved 0.0047 on a task swap against a 0.0036 same-task floor,
    1.3x, i.e. nothing — and reporting that 0.0047 as "task-sensitive" is exactly
    the false pass a floor prevents. The probe now samples the same task twice for
    the floor and grades task/floor: <1.5x FAIL, <3x WEAK, else PASS.
    Also declares grabette-chunkrel in integrations/Pi05/pyproject.toml. That is a
    standalone uv pr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
2026-09-03 fix: import the processor module so the steps reach lerobot's registry
    A chunk-relative checkpoint would not load. Both inference scripts imported
    grabette_chunkrel.chunk_relative — the maths — and neither imported
    chunk_relative_processor, where the @ProcessorStepRegistry.register decorators
    are. Registration happens at IMPORT time of that specific module, so declaring
    the dependency and installing the package are both beside the point;
    make_pre_post_processors() resolves the checkpoint's step NAMES against a
    registry that never learned ours, and lerobot raises a bare KeyError listing
    every step except it.
    train.py was unaffected because it imports chunk_relative_processor directly,
    wh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
2026-09-03 feat: average the task probe over several draws; record P4 results
    The task/floor ratio was built from one draw on each side. pi05 is a flow model,
    so both quantities are random variables and a ratio of two single samples is too
    noisy to act on. --task_samples (default 3) averages each side and prints the
    ranges, flagging the case where they overlap.
    This does not change the P4 conclusion: 1.93x is WEAK whether the true value is
    1.6 or 2.3, so the instruction cannot be relied on either way.
    Records the P4 measurements in the design note: the coupling risk is closed
    (our step survives save_pretrained before the normaliser), the SNR claim is
    confirmed in the checkpoint's own stats (~244mm su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
2026-09-03 feat: diagnose execution quality and gripper timing offline
    The first robot run failed and check 3 could not have predicted it: a chunk can
    have a small mean OFFSET error while the per-step motion derived from it is
    noise. Two diagnostics, both from one prediction, no robot time.
    report_execution_quality: differences the predicted chunk the way the eval loop
    does and reports, per axis, demo vs predicted step size, scatter, straightness
    (net/path) and lag-1 autocorrelation. Differencing shares a_i between
    consecutive deltas with opposite sign, so white offset error drives that
    autocorrelation to -0.5 — a signature real motion cannot produce. Hardware
    measured straightness 0.01 on x (40 mm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
2026-09-03 docs: record the P5 negative result — chunk-relative fails on the robot
    0 grasps across --n_action_steps 15 and 50. The baseline grasped first time in
    the same session, run afterwards specifically to rule out the scene change that
    had been raised as a confounder, so the environment is not the explanation.
    The representation was learned well: offsets accurate to 2.9-5.8 mm, grasp
    timing nearly exact (predicted close index 40 vs GT 39). The failure is in
    converting offsets to per-step motion. Offset error 2.50 mm against 2.46 mm of
    grasp-phase per-step motion is a per-step SNR of 0.98, and differencing shares
    a_i between consecutive deltas with opposite sign, driving the lag-1
    autocorrelati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
2026-09-03 fix: rotvec_to_r6d used columns, so every rotation delta was inverted
    The arm decodes the 6D wire value as the first two ROWS of the rotation matrix —
    the convention rotation_matrix_to_rotation_6d_numpy emits and the working
    per-step-delta pipeline uses. rotvec_to_r6d emitted the first two COLUMNS, which
    is the transpose, i.e. R^-1. Every commanded rotation delta sent to the robot was
    backwards: 0.5-0.85 deg per step, 12-21 deg over a 25-50 action window, and the
    position integration drifts with it because the arm applies
    target_pos += R_target @ delta_pos. That is "smooth but completely misses".
    Found by comparing against convert_dataset.compute_delta_actions on real
    trajectories. Positi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
2026-09-03 docs: P5 grasps first try once the rotation encoding is fixed
    Replaces the superseded negative write-up, which was still asserting a
    "fundamental tension" and recommending we stop. With the wire encoding fixed,
    --n_action_steps 50 grasped the mustard bottle first try, in the same session as
    the baseline control that also grasped first try.
    Separates what the offline analysis got right (the representation is learnable,
    grasp timing is learned, offsets are accurate, the training conditioning win is
    real, and n_action_steps 15 does discard a close at index 40) from what is
    withdrawn (that no horizon works, and the "opposite ends of one dial" framing —
    the long-horizon failure was the bug). T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
2026-09-03 docs: record that this task cannot discriminate the two representations
    n_action_steps 15 still jitters with the encoding fixed, confirming the one
    offline prediction that survived the bug. n_action_steps 50 behaves well and
    looks like the baseline — not visibly better.
    A single object on a clear table from a fixed start pose is comfortably within
    what per-step deltas already do, so "equivalent" is the most this experiment can
    conclude whichever representation is actually better. The SNR argument predicts
    an advantage in fitting fine motion, which a task with this tolerance will not
    expose.
    Records the recommendation: do not adopt as default. The costs are asymmetric —
    chunk-relative n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
2026-09-03 feat: normalize_raw — bring a raw capture into the pipeline's shape
    Newer bimanual-capable captures differ from what the pipeline assumes: channel
    names carry the arm side (right_x, right_proximal), cameras are right_camN
    while evaluate.py sends observation.images.cam0, and there is no
    observation.state. convert_dataset.py normally synthesises the state, but a
    chunk-relative dataset skips that script entirely — the delta conversion is
    what chunk-relative replaces — so it has to be added here.
    Written because the pick3 chunk-relative dataset was assembled with throwaway
    scripts, recorded in the design note but never committed, so the build was not
    reproducible. This one is.
    The camera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
2026-09-05 feat: diverse eval split and best-on-eval checkpoint keeping
    The sugar-cup run (2026-09-04) overfitted from its FIRST eval point — 0.0679 at
    step 1000 rising monotonically to 0.2053 at step 20000 — and --save_freq 10000
    had saved only the two worst checkpoints, one of which push_to_hub then shipped.
    Two independent defects.
    1. lerobot holds out "the last ceil(n * eval_split) episodes per task", i.e. the
    contiguous TAIL of the recording session: 8 of 150 episodes recorded back to
    back, maximally correlated, so the eval loss measures roughly one situation
    repeated. Replaced with farthest-point sampling over a per-episode descriptor
    (the peak-closure pose — where the object a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
2026-09-05 fix: inline the checkpointing helpers — hf jobs uploads ONE script
    `hf jobs uv run` takes a single SCRIPT (local file or URL) with no way to ship a
    sibling module, so `import checkpointing` would have raised ImportError inside
    the container the moment the job started. Caught before launching, not after.
    The helpers now live in train.py and the tests load them from there via
    importlib rather than keeping a second copy — the duplicate-source trap that
    already cost three robot sessions on the r6d convention.
    Verified the property that actually matters: train.py copied ALONE into an empty
    directory imports and resolves its push targets correctly
    (<id>_step4000 / <id>_best). 325 tests pass.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
2026-09-05 fix: the diverse eval split could not find the action data
    First run with the patches fell back to lerobot's tail split with
    RuntimeError('no action data found'), so it trained with exactly the split the
    feature exists to replace.
    Cause: our hook runs BEFORE make_dataset, which is what downloads the data and
    video files, so on a fresh machine only meta/ exists and globbing the dataset
    root finds nothing. It now resolves each episode's parquet by name via
    get_data_file_path and fetches just those (a few MB, no video) when they are not
    already local.
    Verified against the real Hub dataset: 150 episodes found, 23 held out at
    eval_split 0.15, spread 180.8mm against 139.3mm for the whole set.
    A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
2026-09-05 fix: the checkpoint-target line ran before logging was configured
    _rewrite_last_push_target logs its confirmation before lerobot's main() sets up
    logging, so the line went nowhere and the rewrite looked like it had not
    happened. Uses print(flush=True) instead. The rewrite itself was working.
2026-09-05 fix: the eval-loss capture did not survive lerobot's logging reset
    Second run produced a clean eval trace but ZERO [best] events. Cause:
    init_logging calls logger.handlers.clear() on the root logger, so the capture
    handler installed before main() was discarded. Two consequences, and the second
    is the expensive one: nothing could be selected as best, and because pruning is
    driven by the same signal, NOTHING was pruned — 16 saves of 9.35 GB each heading
    for the bucket instead of two.
    Re-attached by wrapping init_logging, the only placement that survives the
    clear. Also warns loudly, once, when no eval_loss has been captured, since the
    silent failure mode is disk exhaustion rather than an er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
2026-09-06 fix: push the best checkpoint when it is selected, not at the end
    A 13-hour run produced eval minimum 0.0709 at step 1000 and then lost it.
    _push_best read the checkpoint from disk after training, --output_dir was
    /bucket/... , and that FUSE mount cannot hold multi-GB files: the read raised
    OSError(EIO) twelve hours after the write, leaving an empty _best repo. Same
    mount that only ever retained 2214-byte config.json files from the earlier runs.
    The Hub is the only storage here that demonstrably keeps weights, so the best
    now goes there the moment it is identified.
    Three changes:
    - upload on selection, so a run that dies later still leaves its best
    checkpoint published; the end-of-run pus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
2026-09-07 fix: run the chunk diagnostics for per-step deltas too
    The offline A/B could not be done: report_execution_quality and
    report_gripper_schedule only ran in the --chunk_relative branch, so pointing the
    gate at the delta baseline fell through to the legacy single-action print. One
    action says nothing about grasp timing, which is the question.
    Both reports now run for either representation, with the one distinction that
    matters: per-step deltas ARE the motion, so they are NOT differenced.
    Differencing them would invent noise that is not there and make the two
    representations look falsely alike — precisely the comparison at stake. The
    gripper report was already width-agnostic (closure is the l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
2026-09-07 feat: --episodes takes N, with a summary of position and timing error
    Every conclusion so far rested on two episodes, and two of them had to be
    walked back — first "the timing failure is the robot failure" (read off
    training episodes), then "the delta model times the grasp correctly" (same
    mistake). A median over eight held-out episodes is what a grasp-timing claim
    actually needs.
    --episodes now accepts 2 or more. Both diagnostics return their numbers instead
    of only printing, and a summary reports per-episode position error, per-step
    error, SNR and the signed timing error, then the medians and ranges — including
    the timing error converted to millimetres of misjudged arrival, which is t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
2026-09-07 fix: the summary printed metres as millimetres, and conflated two errors
    Two defects that between them produced a wrong conclusion.
    1. Units. The per-episode prints multiplied by 1000; the summary stored the raw
    metres and formatted them with an 'm' suffix that reads as mm. The delta
    model's 1.8-4.8 mm therefore displayed as 0.00 and looked perfect.
    2. Worse, the column mixed two different quantities under one name. For
    chunk-relative it was the error in an OFFSET from the chunk reference, which
    accumulates over 50 steps; for per-step deltas it was a single step. Reading
    one against the other is what produced the claim that the delta model
    generalises "20x better". On the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
2026-09-07 fix: step_err_mm was already millimetres — do not scale it again
    The previous commit fixed the chunk-error units (metres shown as mm) and then
    introduced the mirror-image bug on the step error, which
    report_execution_quality already converts before averaging: it would have
    printed 2610 mm instead of 2.61. The unit test written in the same commit
    caught it, which is the only reason it did not reach a conclusion. 37 tests.
2026-09-08 docs: bring READMEs in line with chunk-relative mode and checkpoint selection
    - Pi05: drop the bucket-mount output_dir advice (the FUSE mount never
    retained weights); local --output_dir + Hub push. New 'Checkpoint
    selection' subsection: GRABETTE_SAVE_BEST / GRABETTE_EVAL_SELECT
    defaults, <repo_id>_best and <repo_id>_step<N> push targets,
    GRABETTE_CHUNK_RELATIVE opt-in, eval-split recipe 0.15/500/500,
    execution-quality summary of the gate.
    - openarm_gripette_simu: --chunk_relative auto|on|off, horizon caveat,
    8D/11D width check, --skip_stale fix note.
    - grabette-postprocess: normalize_raw, publish gate, relative stats;
    project tree updated.
    - grabette-chunkrel: new README (maths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
2026-09-08 docs: review of attention maps and saliency maps as policy debugging tools
    State of the art for pi0.5 and Diffusion Policy, with multi-camera
    genericity as a first-class constraint.
    Key findings:
    - The 2026 VLA-diagnosis papers all use raw attention (action tokens as
    queries, image tokens as keys, mean over heads); rollout/Chefer/GMAR
    have never been applied to a VLA and need a scalar target we must pick.
    - Attention is measurably less faithful than interventional attribution
    on pi0.5 (Embodied Interpretability, ICML 2026), and VLM-side attention
    is a poor proxy for what the action head needs (VLA-Pruner).
    - Attention mass on task-irrelevant regions is significantly higher in
    fail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
2026-09-08 docs: add implementation notes and source bibliographies to the review
    Section 5 (verified against the installed lerobot 0.6.x sources):
    - pi0.5 attention needs no fork: GemmaAttention.forward returns the
    probabilities and lerobot forces eager, so a forward hook on the 18
    expert attention modules gets (B, 8, 50, prefix_len+50) once per layer
    per denoising step. compute_layer_complete, where weights are dropped,
    is training-only and not on the inference path.
    - Prefix layout gives token -> (camera, row, col) directly; camera order
    is config.image_features order and missing cameras are appended after
    the present ones with their mask zeroed, which is the concrete rule the
    multi-ca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
2026-09-08 docs: design spec for attention maps and view ablation (v1)
    Scope: attention extraction plus view ablation for pi0.5, offline only.
    Shared analysis records with a PNG front end first and a rerun logger
    after; dataset episodes first with a dump_obs reader behind the same
    frame-source interface.
    Rests on verified internals: a forward hook on the 18 expert attention
    modules yields the probabilities without touching lerobot, and
    sample_actions takes an explicit noise tensor, so ablation is
    deterministic by construction rather than by global seeding.
    Ablation removes a view by zeroing its image mask in place rather than
    dropping the batch key, which preserves token order and position ids and
    ma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
2026-09-08 docs: implementation plan for attention maps and view ablation
    13 TDD tasks building packages/grabette-attention: records, letterbox
    geometry, token layout, hook capture, reduction, the millimetre metric,
    the pi0.5 adapter, frame sources, orchestration, the PNG front end, the
    CLI and wiring, the rerun front end, then mutation and GPU tests.
    Every multi-camera acceptance criterion from the spec appears as an
    executable test, and the mutation file states the specific mistakes that
    must fail: hard-coded token counts, hard-coded single camera, a
    transposed token grid, per-camera renormalisation that would hide which
    camera is used, plotted padding rows, and a double-scaled millimetre.
2026-09-08 docs: amend plan for pre-flight rulings 1-3
    Ruling 1: reduce_attention takes a per-camera mapping of letterbox
    geometries, not one geometry applied to every view. The plan took the
    first visible camera's geometry and cropped every camera's grid with it,
    which assumes all views share a resolution and aspect ratio - exactly
    what the multi-camera constraint forbids. Adds a test with a 4:3 and a
    square view proving the two grids differ in height, and one for a
    forgotten camera being a KeyError rather than a guess.
    Ruling 2: the pi0.5 adapter resolves the expert attention path only, with
    no fallback that existed solely to satisfy the test stub; the stub now
    mirrors the real module tree. A fallba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
2026-09-08 feat(attention): token layout for any number of cameras
2026-09-08 feat(attention): reduce captures to per-camera maps and prefix mass
2026-09-08 feat(attention): translation delta metric in millimetres
2026-09-08 test(attention): guard pi0.5 camera drop against list-deletion regression
    Task 7 review found that the existing drop-camera tests only exercise the
    descriptive layer (layout()) or a chunk-differs assertion that a del-based
    ablation would also satisfy, since the stub's zip() tolerates a shortened
    list. Add a test that inspects images/img_masks as run() actually hands them
    to sample_actions(), asserting the length stays at one entry per configured
    camera and that the dropped camera is masked in place (padding value, mask
    False) while the other camera is untouched at its own slot.
2026-09-08 feat(attention): dataset and dump_obs frame sources with grasp-frame selection
2026-09-08 fix(attention): address code review findings for sources.py
    - Fix E401 violations by using pytest tmp_path fixture instead of tempfile.mkdtemp
    - Add opencv-python-headless to test extra so cv2-gated tests run on Python 3.11
    - Fix stride notes to report actual frame count sampled, not requested count
    - Add test for count > n_frames edge case
    - Verify ruff lint passes on entire package
2026-09-08 feat(attention): grabette-attn CLI, checkpoint loader and wiring
2026-09-08 fix(attention): convert the ablation chunk to real units (CRITICAL)
    loader.py discarded the postprocessor from make_pre_post_processors, and
    adapters/pi05.py called sample_actions() directly, so the chunk metrics.py
    scaled by 1000 and labelled millimetres was still in pi0.5's normalized
    quantile action space -- and quantile normalization is per-channel, so the
    distortion corrupts the shape of the per-axis breakdown, not just its
    magnitude. This is the tool's headline measurement.
    - loader.py now returns (policy, preprocessor, postprocessor) and drops the
    chunk-relative checkpoint's AbsoluteFromChunkRelative postprocessor step
    (it needs a reference pose only the robot has), mirroring
    i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
2026-09-08 fix(attention): validate the captured key axis against the derived layout
    reduce.py sliced the prefix out of the captured attention tensor with no
    check that the tensor's key axis actually matched the layout it was derived
    from. If the patch size is wrong, tokens-per-image and grid rows*cols stay
    mutually consistent BY CONSTRUCTION (both come from the same wrong patch), so
    the reshape still succeeds and numpy silently truncates -- every camera
    block is misaligned while the output looks fine.
    reduce_attention now asserts the captured key axis equals prefix_len plus
    the query count before reducing. Pinned with
    test_a_key_axis_that_disagrees_with_the_layout_is_rejected (confirmed to
    fail -- "D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
2026-09-08 fix(attention): reject --denoise-step all instead of silently averaging
    reduce.py's _select() treated denoise_step='all' identically to 'mean',
    averaging the denoising steps together, even though the spec argues for
    comparing maps ACROSS denoising steps as an open question nobody has
    published -- unlike layers='all', which legitimately means "average across
    layers." Supporting a true per-step comparison would need a per-step record
    shape (FrameAnalysis currently holds one map per camera per frame); that is
    a bigger change than this fix wave, so denoise_step='all' now raises with a
    message naming what to pass instead ('mean', 'last', 'first', or an index).
    Pinned with test_denoise_step_all_i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
2026-09-08 fix(attention): prefer the dataset's own task; validate --camera-key
    sources.py built every observation with the caller-supplied --task, which the
    CLI defaults to "". The dataset item already carries its own task from its
    episode (DatasetReader sets item["task"] from meta.tasks), so running without
    --task silently analysed the policy under an empty prompt it was never
    trained on -- and this policy discretizes the robot state INTO the language
    prompt, so the reported language mass would then describe state plus padding
    alone.
    DatasetSource.frames() now prefers the item's own task, falling back to the
    supplied value, and records which source won per episode in a new
    task_source dict; cli.py t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
2026-09-08 fix(attention): make camera output labels collision-free
    The PNG writer, the rerun logger, and the CLI's progress line all built a
    short camera label from the key's last dot-segment (camera.rsplit('.',
    1)[-1]), triplicated. Two cameras whose keys share a trailing segment --
    exactly the shape of a stereo pair, e.g. "observation.images.left.cam0" and
    "observation.images.right.cam0" -- collapse onto the same label, so one
    view's PNG overwrites the other's and one view's rerun entity replaces the
    other's, silently. The reviewer promoted this from Minor: losing half a
    stereo pair is the exact failure multi-camera genericity was supposed to
    preclude.
    Added grabette_attention.frontends.camera_labe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
2026-09-08 fix(attention): upsample and normalize the rerun attention overlay
    The rerun logger sent the raw 12x16 attention grid straight through as an
    image entity under the camera's entity. The viewer draws each entity at its
    own pixel resolution, so a small child does not stretch over its 720x960
    parent frame -- it lands as a small block. Raw attention values, of order
    one over the cell count, also sit near the bottom of the default float
    display range and render near-black. The PNG path avoids both problems via
    matplotlib's `extent=` and autoscaling; the rerun path had neither.
    Added _upsample_and_normalize(): nearest-neighbour upsample to the frame's
    height and width (no interpolation library is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
2026-09-08 fix(attention): declare the png extra; skip PNG overlays gracefully
    integrations/Pi05/pyproject.toml depended on a bare "grabette-attention",
    and that integration's README now advertises grabette-attn. But the
    plotting library sits behind grabette-attention's 'png' extra and nothing
    else in that environment pulls it in, so a run would die on a missing
    matplotlib import -- after loading a checkpoint (multi-gigabyte) and
    computing the first frame. Changed the dependency to
    "grabette-attention[png]" and regenerated integrations/Pi05/uv.lock.
    Confirmed the pinned lerobot revision (e40b58a8dfa9e7b86918c374791599d070518d11,
    shared across training, the offline gates, and the inference server) is
    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
2026-09-08 fix(attention): an explicitly supplied task must win over the dataset's own
    The dataset source preferred item["task"] unconditionally, so an explicit
    --task was silently discarded. That is backwards for the case that matters:
    a dataset can carry a directory slug rather than language, and this policy
    discretizes the robot state INTO the language prompt, so feeding the slug
    analyses the policy under a prompt it never saw and corrupts the reported
    language mass too.
    Precedence is now: explicit --task wins, the dataset's own task is the
    default when none was supplied, neither available is an error rather than
    an empty prompt. --task defaults to None so absence is distinguishable
    from a delibera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
2026-09-08 fix(grabette-attention): widen test extra to lerobot[pi]
    The test extra pinned plain lerobot, which cannot load a pi0.5
    checkpoint (ImportError: transformers required). This left
    test_integration_gpu.py, the only test exercising the real forward-hook
    path, unrunnable from the package's own declared test environment.
    Widen the pin to lerobot[pi]==0.6.0 to match what loading a pi0.5
    policy actually needs, keeping the python_version >= '3.12' marker.
2026-09-08 docs(attention-maps): record the first real run against a checkpoint
    Append a factual record of the tool's first run against
    SteveNguyen/pick3_graspproj_chunkrel_pi05: masses, ablation delta,
    runtime, and the two things not yet explained (bottom-left saliency
    peak, unconfirmed per-axis convention). One frame of one episode;
    recorded as a demonstration that the pipeline runs, not a result.
2026-09-09 feat(attention): label the axes, clip the colour scale, add per-step maps
    Three changes that all bear on how the tool's output gets read.
    Axis labels. The per-axis ablation millimetres were printed as a bare
    "xyz" triple, and the docstrings in records.py and metrics.py both claimed
    the breakdown showed "the vertical (range) information" -- conflating two
    axes that behave oppositely. Measured over 172 episodes of
    mustard_graspproj: the approach is pinned to +z in 99% of episodes (70 mm
    mean travel) and the post-closure lift to -y (44 mm, 91% agreement) while
    z's sign agreement collapses to 51%. So the frame is camera-relative, not
    world, and it is the standard OpenCV camera frame: x lateral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
2026-09-09 docs(attention-maps): record the first real measurements
    Axis convention measured over 172 episodes, the units check against real
    demonstrated travel, an 80-frame ablation sweep across 10 episodes, and the
    per-step sink growth. Includes the measurement scripts so every number can
    be rederived.
    The headline results:
    - The action frame is camera-relative (OpenCV: x right, y down, z forward),
    established from the recorded actions and agreeing independently with the
    T_b_c1 calibration.
    - Removing the camera changes the forward command by a constant ~55% of the
    distance still to travel, at any range -- scale-invariant range
    perception. The naive reading of the raw +0.894 correlation say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
    [sweep_rows.csv]
2026-09-09 docs(attention-maps): what the attention map is actually made of
    Three separable components, measured over 48 frames spanning 8 episodes and
    every timing from episode start to grasp.
    1. A dominant component fixed to the gripper. The camera is gripper-mounted,
    so anything fixed in image space is fixed on the hardware. Each frame's
    map is cosine 0.928 to the across-frame mean, the peak sits in one
    three-cell cluster in 83% of frames, and attention is bottom-weighted
    (0.25-0.45x uniform in rows 0-5, rising to 2.48x by row 11).
    2. A real but modest object-following component: 1.17x, with 38/48 frames
    preferring their own object footprint over other frames' footprints
    (p ~ 1e-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
2026-09-09 feat(attention): occlusion saliency — a causal map, not an attention map
    Cover a block of one camera's image, re-run, measure how far the commanded
    chunk moves. Same intervention as the view ablation, spatially resolved.
    This exists because the attention map does not answer the question people
    want to ask of it. On this policy attention mass does not track causal
    effect at all (mass stays in 0.262-0.311 across a 6.7x spread in ablation
    delta), and the map's dominant component is locked to the gripper rather
    than to the scene. Neither of those can be fixed by reading the map more
    carefully, and today produced three confident readings of these maps that
    measurement then refuted -- two of th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
2026-09-09 feat(attention): prompt sensitivity — is the language input load-bearing?
    Same intervention as the view ablation, applied to the prompt: substitute the
    string, re-run with the same noise, measure the RMS change in commanded
    translation. Language plus state carries ~0.7 of the prefix attention mass,
    about twice the camera's, and nothing here had ever intervened on it.
    Measured on sugar_cup_chunkrel_pi05_step20000, 21 frames over 3 episodes,
    mean baseline motion 100.5 mm. Mean delta by variant:
    control (its own prompt) 0.0 mm <- exact, at all 7 phases
    'pick up the cup' 5.9 mm
    its own words, scrambled 6.7 mm
    'pick up the mustard bottle' 9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
2026-09-10 feat(attention): report each model's own motion scale, so representations compare
    A bare millimetre delta cannot be compared across action representations, and
    the delta-vs-chunk-relative comparison would have been nonsense without this.
    Read from the checkpoints' own processor configs:
    delta models relative_actions_processor enabled=false
    absolute_actions_processor enabled=false
    -> output is the dataset's raw PER-STEP deltas, ~3 mm scale
    chunkrel models grabette_chunk_relative_actions enabled=true, and this
    package strips the paired absolute step (it needs a
    reference pose only the robot has)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
2026-09-10 docs(attention-maps): delta vs chunk-relative, and the figure for it
    Same recording, same 20000 steps, same prompt; only the action
    parameterisation differs. Reported as a fraction of each model's own
    commanded motion, since their raw millimetres differ ~20x by construction.
    Three results:
    - Vision dependence is indistinguishable: every phase within +/-9%, both
    near 100%. But the measure SATURATES there -- at 100% the ablated output
    is about as different from the original as the original's own magnitude,
    i.e. decorrelated -- so this is 'no detectable difference', not 'no
    difference'. Ranking two models needs graded degradation, not full
    removal.
    - The delta model carries 1.30x th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
2026-09-10 docs(attention-maps): attention and causal maps for both representations
    Same episode, same two frames, both checkpoints, so the maps can be read
    side by side rather than only as tables.
    This found what the fraction tables could not. Full camera removal put both
    models at ~100% of their own commanded motion -- the measure saturates
    there, so it cannot rank them. Occlusion is the graded version of the same
    intervention, and it separates them sharply:
    largest single 30x30 block effect, % of own baseline motion
    delta chunkrel ratio
    approach 0% 40.0% 5.6% 7.1x
    grasp 12.3% 6.7% 1.8x
    The chunk-relative model's reliance on the i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
2026-09-10 feat(attention): endpoint divergence, and it deflates the 7x claim
    The delta-vs-chunk-relative concentration finding rested on a normalisation
    I could not defend. Dividing each block's effect by that model's own
    commanded motion gave 7x; the same data in raw millimetres reversed the
    ranking, because the delta baseline is a 3.5 mm per-step figure and the
    chunk-relative one a 61 mm cumulative figure. Two defensible readings means
    neither was decisive.
    Endpoint divergence embeds no choice: compose each chunk into a trajectory --
    chaining the delta model's per-step rotations -- and measure how far apart
    the endpoints land. Both models then command a trajectory of the same length
    (125 vs 127 mm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
2026-09-11 docs(attention-maps): localise the cube, and correct the attention claim
    Colour failed four times on this scene. Two things fixed it. A grid-labelled
    zoom read by eye put the cube at x 248-286, y 224-248 (cells r7c8, r7c9,
    r8c8, r8c9). Then Grounding DINO for the box plus SAM2 for the mask -- run
    locally, so no robot imagery leaves the machine -- reproduced exactly those
    four cells at 0.73 confidence and 4.7 px of centre error. Note the division
    of labour: SAM2 is promptable and cannot find an object from a description,
    so the text-to-box step has to come from elsewhere.
    With a validated object region, approach frame, mean map value on the object
    against every cell in neither object: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
2026-09-11 ci: run the attention and chunk-relative test suites
    244 tests that existed but nothing executed: 170 in grabette-attention and
    74 in grabette-chunkrel. Both packages were absent from ci.yml, so every
    regression in them would have landed silently.
    grabette-attention goes in the fast 'tests' job with a hand-built venv rather
    than --extra test. That extra declares torch and lerobot[pi] so the one
    GPU-marked test can load a real pi0.5 by hand; in CI it would pull the CUDA
    wheel and transformers, several GB, for a test the package's own
    addopts (-m 'not gpu') deselects anyway. Verified by running the suite in
    exactly the environment the step builds: torch (CPU), pytest, numpy,
    matplotlib, openc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
2026-09-11 feat(Pi05): retask_dataset.py, and correct the lens-occlusion claim
    The prompt is not a training flag. train.py takes no --task; the string the
    policy learns comes from the dataset's meta/tasks.parquet via task_index. So
    retraining the sugar models with a correct prompt needs a patched dataset
    first, which this publishes -- as a COPY, since rewriting the original in
    place would make the existing checkpoints' provenance a lie. Only
    meta/tasks.parquet changes; task_index values stay valid because the indices
    keep their meaning.
    New prompt: 'put the sugar cube in the mug'. It describes the actual task,
    which 'pick up the sugar cup' does not, and it shares only the word 'the'
    with any pick3 str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
2026-09-11 fix(Pi05): retask both places the task string lives
    The dry run over the real datasets showed meta/episodes/*.parquet carries a
    per-episode 'tasks' column holding the literal string -- 150 stale copies per
    dataset that the first version of this script left untouched.
    Checked which one training reads: dataset_reader.py line 352 does
    `item["task"] = self._meta.tasks.iloc[task_idx].name`, resolving the frame's
    task_index through meta/tasks.parquet. aggregate.py goes through the same
    table. So the episode-level column is NOT load-bearing and patching
    tasks.parquet alone would have trained correctly.
    Patching it anyway, with an assertion per file. A dataset whose metadata
    contradicts itself is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
2026-09-11 fix(Pi05): tag the retasked datasets with their codebase version
    The first smoke job died on this. upload_folder copies FILES, not refs, so
    the new datasets carried no v3.0 tag while both sources do. lerobot resolves
    a dataset revision through get_safe_version(), which raises
    RevisionNotFoundError when a repo has no version tag, so
    LeRobotDatasetMetadata.__init__ failed before a single step ran.
    Worse, the failure was opaque: in this huggingface_hub version that
    RevisionNotFoundError cannot construct itself
    (HfHubHTTPError.__init__() missing 'response'), so the traceback ends in an
    unrelated TypeError deep in utils.py and never mentions tags. Anyone hitting
    this without knowing to look at r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
2026-09-13 fix(Pi05): pin wandb, and document the chunk-relative --with
    Four failed HF Jobs boots today, three of them avoidable from the repo.
    PIN WANDB. train.py declared 'wandb' unpinned, so uv resolved the latest.
    wandb 0.29.0 removed Run.get_url(), which lerobot's wandb_utils.py line 122
    still calls, so the job dies with
    AttributeError: 'Run' object has no attribute 'get_url'
    the moment --wandb.enable=true is passed. The perverse part: the README
    RECOMMENDS enabling wandb (a 12 h / $30 run's losses were unrecoverable
    without it), so following the documented recipe was what broke the run.
    Boundary found by installing each version: 0.18.7 / 0.19.11 / 0.20.1 /
    0.21.0 / 0.22.0 / 0.25.0 / 0.28.0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
2026-09-14 docs(Pi05): correct the claim about hf jobs log truncation
    Said logs always return a tail, on the evidence of one 12 h run that came
    back as 55 KB. The delta run of the same length, fetched the morning it
    finished, returned 1.6 MB with all 50 evals. The difference is age, not
    length: pull the log promptly and it is complete.
    Also records what both sugarcube runs showed: eval loss bottoms out early
    (best at step 3000 for delta, step 1000 for chunk-relative) and does not
    improve across the remaining 17-19k steps, at 32.7 epochs over 23k frames.
    The delta run still beat the recipe's reference (0.7818 -> 0.4095 against
    0.755 -> 0.447).
2026-09-14 docs(attention-maps): the retrain closed the prompt collision
    Re-ran the prompt sweep on sugarcube_in_mug_chunkrel_pi05_step20000, same 21
    frames, same seed, same protocol as the original.
    The collision is gone, and the comparison that shows it is against pick3's
    OWN sibling strings rather than the absolute figure:
    original retrained
    'pick up the cup' 5.9 15.2
    'pick up the mustard bottle' 9.8 15.7
    'pick up the red can' 10.5 18.4
    collision / sibling mean 0.58x 0.89x
    The hazard was never the small number as such; it was that among three
    sibling instructions, THAT o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
2026-09-14 docs(attention-maps): bring the findings record up to date
    The in-repo record had stopped at d4da340 while the work continued; the
    shareable artifact became the complete account and the versioned one covered
    about half. That is backwards — the repo doc sits beside the code and the
    scripts it cites, and survives whatever happens to an artifact URL.
    Adds sections 7-12, all from measurements already committed here:
    7 occlusion vs attention: 0/10 top cells shared at either frame, and no
    single patch worth more than ~6% of the baseline motion
    8 prompt sensitivity, the collision, and the retrain that closed it
    (collision / sibling mean 0.58x -> 0.89x)
    9 delta vs chunk-relati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
2026-09-16 Add a inverted parameter for orbbec and make it by default.
    [config.py, main.py, orbbec.py]
2026-09-16 Gemini inverted by default.
    [config.py]
2026-09-23 Modify HF button.
2026-09-29 Add space button in test recording.
2026-09-30 Tell iPhone and iPad users to switch device, not browser
    Every iOS browser is WebKit underneath, Chrome included, and WebKit has no
    Web Bluetooth. The existing check read that as an unsupported browser and
    told a Chrome-on-iPhone user to open the page in Chrome — advice that
    cannot work, delivered exactly where someone has already tried it.
    iPadOS reports itself as a Mac, hence the touch-points check; desktop
    Safari still gets the "use Chrome or Edge" message, which does work there.
    Assisted-by: Claude:claude-opus-5
2026-10-01 Fix test recording issues.
    [depth_camera.py, episode_check.py, oakd.py]
2026-10-01 Hide message error if camera is plugged back.
    [test_hardware_error.py]
2026-10-05 Set the speaker volume on the codec mixer, not in the samples
    The dashboard slider scaled the amplitude of the rendered cues, so it could
    only go down from the 'Line DAC Playback Volume' level set at boot by
    aic3104-init.sh (45, i.e. -36.5 dB): at 100 % the cues were still quiet,
    while raising the DAC by hand with amixer made them much louder.
    The slider now drives that mixer control through amixer: 1-100 % maps
    linearly onto DAC values 30-118 (-44 dB to 0 dB, linear in dB since the
    steps are 0.5 dB), and 0 % still mutes by not playing. The cues are rendered
    once at a fixed amplitude. The saved level is applied when the daemon
    prepares the speaker; scripts/test_speaker.py passes none and le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
    [config.py, sound.py, test_speaker.py]
2026-10-06 Add calibration button
2026-10-06 Update UI for calibration
2026-10-07 Modify button color.
2026-10-07 Add calibration in Get Started
2026-10-07 Manage already calibrated device
2026-10-07 Update tutorial video with calibration.
2026-10-07 Add recalibrate button
2026-10-07 Add play button for each sound.
2026-10-08 Add check calibration in dashboard
2026-10-08 Test simplified stl
    [606_00020_sr_front_cover.stl, 606_00021_sr_back_cover_py074.stl, 611_00020.stl, 611_00020_1.stl, 612_00001_tim_thermal_oak_d_poe.stl, arducam_fisheye.stl, bushing_6x8x4.stl, button.stl]
